muzaffernizam/STM32-Motor-Control-BLDC-24V/Orders/STM32_Motor_Kit_v0.1_L.xlsx

Sheet: STM32_Motor_Kit_v0.1
Reference | Value | Footprint | LCSC PART | LCSC PRICE 100 ADETTE |  | Price 10 adet | Adet | Toplam
R86,R130 | 0R | AKE_Resistor_SMD:RES_0603 | AC0603FR-070RL | 0.002 | 100 ADETTE | $0.0100 | 20 | $0.20 | 0.04
D3,D41 | 3.3V | AKE_Diode_SMD:SOD-123 | BZT52C3V3-7-F | 0.0224 | 20 ADETTE | $0.0460 | 20 | $0.92 | 0.448
R33,R34,R35,R36,R37,R38,R41,R42,R43,R44,R45,R46 | 10R | AKE_Resistor_SMD:RES_0603 | RC0603FR-0710RL | 0.0032 | 100 | $0.0100 | 120 | $1.20 | 0.384
D2,D29,D30,D31 | 26V | AKE_Diode_SMD:SMC |  |  |  | $0.0100 | 40 | $0.40 | 0
R18,R19,R47,R48,R62,R63,R72,R73,R83,R84,R87,R89,R131,R132 | 47R | AKE_Resistor_SMD:RES_0603 | RC0603FR-0747RL | 0.0012 |  | $0.0100 | 140 | $1.40 | 0.168
R29,R31 | 60R | AKE_Resistor_SMD:RES_0603 | RC0603FR-0760R4L | 0.0012 |  | $0.0100 | 20 | $0.20 | 0.024
R7,R10,R28,R119 | 100R | AKE_Resistor_SMD:RES_0603 | AC0603FR-07100RL | 0.0021 |  | $0.0100 | 40 | $0.40 | 0.084
R17,R81,R82,R120,R121,R122,R123,R124,R125,R126,R127,R128 | 330R | AKE_Resistor_SMD:RES_0603 | RC0603FR-07330RL | 0.0012 |  | $0.0100 | 120 | $1.20 | 0.144
R16 | 500R | AKE_Resistor_SMD:RES_0603 | RC0603FR-07499RL | 0.0013 |  | $0.0100 | 10 | $0.10 | 0.013
R1,R4,R5,R50,R51,R52,R53,R54,R55,R69,R70,R71,R75,R76,R77,R118 | 1K | AKE_Resistor_SMD:RES_0603 | RC0603FR-071KL | 0.001 |  | $0.0100 | 160 | $1.60 | 0.16
R15,R56,R57,R58,R59,R60,R61 | 1.5K | AKE_Resistor_SMD:RES_0603 | RC0603FR-071K5L | 0.0012 |  | $0.0100 | 70 | $0.70 | 0.084
R14 | 2.4K | AKE_Resistor_SMD:RES_0603 |  |  |  | $0.0100 | 10 | $0.10 | 0
R13 | 3.3K | AKE_Resistor_SMD:RES_0603 |  |  |  | $0.0100 | 10 | $0.10 | 0
R88,R90,R91,R92 | 4.7K | AKE_Resistor_SMD:RES_0603 |  |  |  | $0.0100 | 40 | $0.40 | 0
R2,R12 | 10K | AKE_Resistor_SMD:RES_0603 |  |  |  | $0.0100 | 20 | $0.20 | 0
R3,R6 | 10K | AKE_Resistor_SMD:RES_1206 |  |  |  | $0.0100 | 20 | $0.20 | 0
R11 | 29.4K | AKE_Resistor_SMD:RES_0603 |  |  |  | $0.0100 | 10 | $0.10 | 0
R66,R67,R68,R78,R79,R80 | 47K | AKE_Resistor_SMD:RES_0603 |  |  |  | $0.0100 | 60 | $0.60 | 0
R9 | 68K | AKE_Resistor_SMD:RES_0603 |  |  |  | $0.0100 | 10 | $0.10 | 0
R8 | 330K | AKE_Resistor_SMD:RES_0603 |  |  |  | $0.0100 | 10 | $0.10 | 0
C58,C59 | 1000uF_35V | AKE_Capacitor_TH:C_Radial_D16.0mm_H31.5mm_P7.50mm |  |  |  | $0.0374 | 20 | $0.75 | 0
C1,C2,C3,C4,C5,C6,C7,C8,C11,C13,C15,C16,C18,C20,C22,C23,C24,C25,C30,C34,C42,C49,C50,C51,C75,C76,C77,C81,C82,C83,C86,C87,C103,C104 | 100nF_50V | AKE_Capacitor_SMD:CAP_0603 |  |  |  | $0.0100 | 340 | $3.40 | 0
C52,C54,C56 | 100nF_50V | AKE_Capacitor_SMD:CAP_1206 |  |  |  | $0.0100 | 30 | $0.30 | 0
C36,C37,C40,C41,C66,C67,C68,C69,C70,C71 | 100pF_50V | AKE_Capacitor_SMD:CAP_0603 |  |  |  | $0.0100 | 100 | $1.00 | 0
C26 | 10nF_50V | AKE_Capacitor_SMD:CAP_0603 |  |  |  | $0.0100 | 10 | $0.10 | 0
C12,C17 | 10uF_10V | AKE_Capacitor_SMD:CAP_1206_TANTAL |  |  |  | $0.1260 | 20 | $2.52 | 0
C90 | 10uF_10V | AKE_Capacitor_SMD:CAP_1206 |  |  |  | $0.1260 | 10 | $1.26 | 0
C43,C44,C45 | 10uF_50V | AKE_Capacitor_SMD:CAP_1206_TANTAL |  |  |  | $0.0100 | 30 | $0.30 | 0
C9,C10 | 18pF_50V | AKE_Capacitor_SMD:CAP_0603 |  |  |  | $0.0100 | 20 | $0.20 | 0
D17,D18,D21,D22,D25,D26 | 1N4148 | AKE_Diode_SMD:SOD-323 |  |  |  | $0.0278 | 60 | $1.67 | 0
C29,C84,C85,C88,C89 | 1nF_50V | AKE_Capacitor_SMD:CAP_0603 |  |  |  | $0.0100 | 50 | $0.50 | 0
C72,C73,C74,C78,C79,C80 | 1uF_10V | AKE_Capacitor_SMD:CAP_0603 |  |  |  | $0.0100 | 60 | $0.60 | 0
C27,C28,C46,C47,C48 | 1uF_50V | AKE_Capacitor_SMD:CAP_1206 |  |  |  | $0.0100 | 50 | $0.50 | 0
C33 | 1uF_50V | AKE_Capacitor_SMD:CAP_0603 |  |  |  | $0.0100 | 10 | $0.10 | 0
C60,C61,C62,C63,C64,C65 | 2.2uF_10V | AKE_Capacitor_SMD:CAP_0603 |  |  |  | $0.0126 | 60 | $0.76 | 0
C19 | 220uF_50V | AKE_Capacitor_TH:CP_Radial_D10.0mm_P5.00mm |  |  |  | $0.1116 | 10 | $1.12 | 0
C14,C21,C35 | 22pF_50V | AKE_Capacitor_SMD:CAP_0603 |  |  |  | $0.0100 | 30 | $0.30 | 0
C53,C55,C57 | 22uF_35V | AKE_Capacitor_SMD:CAP_2917_7343_TANTAL_7.3x4.3mm |  |  |  | $0.1000 | 30 | $3.00 | 0
C91 | 3.3nF_50V | AKE_Capacitor_SMD:CAP_0603 |  |  |  | $0.0100 | 10 | $0.10 | 0
C32 | 330uF_25V | AKE_Capacitor_TH:CP_Radial_D10.0mm_P5.00mm |  |  |  | $0.0508 | 10 | $0.51 | 0
C31 | 47pF_50V | AKE_Capacitor_SMD:CAP_0603 |  |  |  | $0.0100 | 10 | $0.10 | 0
L1,L2 | 6.8uH_5.6A | AKE_Inductor_SMD:SRI1004-6R8M |  |  |  | $0.3068 | 20 | $6.14 | 0
TH1 | 8V_0.5A | AKE_Resistor_SMD:RES_1206 |  |  |  | $0.1087 | 10 | $1.09 | 0
D9 | B0520LW-7-F | AKE_Diode_SMD:SOD-123 |  |  |  | $0.0100 | 10 | $0.10 | 0
D4 | B340A-E3/61T | AKE_Diode_SMD:SMA |  |  |  | $0.2574 | 10 | $2.57 | 0
D5,D6,D7,D8,D32,D33,D42,D43,D44,D45,D46,D47,D48,D49 | Blue | AKE_Led_SMD:LED_0805 |  |  |  | $0.0500 | 140 | $7.00 | 0
J1,J4 | Conn_01x02_Male | AKE_Connector_Socket_TH:PhoenixContact_MC_1,5_2-G-3.81_1x02_P3.81mm_Horizontal |  |  |  | $0.1000 | 20 | $2.00 | 0
J5 | Conn_01x03_Male | AKE_Connector_Socket_TH:PhoenixContact_MC_1,5_3-G-3.81_1x03_P3.81mm_Horizontal |  |  |  | $0.1000 | 10 | $1.00 | 0
J6 | Conn_01x05_Male | AKE_Connector_Socket_TH:PhoenixContact_MC_1,5_5-G-3.81_1x05_P3.81mm_Horizontal |  |  |  | $0.1000 | 10 | $1.00 | 0
J2 | Conn_02x05_Odd_Even | AKE_Connector_IDC_Socket:IDC-Header_2x05_P2.54mm_Vertical |  |  |  | $0.0100 | 10 | $0.10 | 0
J10 | Conn_02x20_Odd_Even | AKE_Pinheader_TH:PinHeader_2x20_P2.54mm_Vertical |  |  |  | $0.2500 | 10 | $2.50 | 0
Y1 | CRYSTAL_8mHz | AKE_Oscilator_SMD:CRY_SMD_4P_5.0x3.2mm |  |  |  | $0.2000 | 10 | $2.00 | 0
D34 | DESD5V0U1BA-7 | AKE_Diode_SMD:SOD-323 |  |  |  | $0.0100 | 10 | $0.10 | 0
R85 | DNI/0R | AKE_Resistor_SMD:RES_0603 |  |  |  | $0.0100 | 10 | $0.10 | 0
R129 | DNI/0R | AKE_Resistor_SMD:RES_0603 |  |  |  | $0.0100 | 10 | $0.10 | 0
R39,R40 | DNI/499K | AKE_Resistor_SMD:RES_1206 |  |  |  | $0.0100 | 20 | $0.20 | 0
R30 | DNI/RX1 | AKE_Resistor_SMD:RES_0603 |  |  |  | $0.0100 | 10 | $0.10 | 0
R32 | DNI/RX2 | AKE_Resistor_SMD:RES_0603 |  |  |  | $0.0100 | 10 | $0.10 | 0
D14,D15,D16 | ES1D-M3/61T | AKE_Diode_SMD:SMA |  |  |  | $0.0877 | 30 | $2.63 | 0
F1 | Glass_Fuse | AKE_Device_TH:FuseHolder_5X20_TK79_Plastic |  |  |  | $0.1077 | 10 | $1.08 | 0
U9,U10,U11 | IR2101STRPBF | AKE_IC_SMD:SOIC-8_3.9x4.9mm_P1.27mm |  |  |  | $1.2804 | 30 | $38.41 | 0
U2 | LDF33DT-TR | AKE_Regulator_SMD:DPAK_123 |  |  |  | $0.2500 | 10 | $2.50 | 0
U3,U12,U13,U14 | LMV358IDRG4 | AKE_Opamp_SMD:SOIC-8_3.9x4.9mm_P1.27mm |  |  |  | $0.5184 | 40 | $20.74 | 0
U15 | LSF0204DPWR | AKE_IC_SMD:TSSOP-14_4.4x5mm_P0.65mm |  |  |  | $0.8130 | 10 | $8.13 | 0
U20 | M24C64-WMN6TP | AKE_IC_SMD:SOIC-8_3.9x4.9mm_P1.27mm |  |  |  | $0.1952 | 10 | $1.95 | 0
U5 | MC78M15CDTRKG | AKE_Regulator_SMD:DPAK_123 |  |  |  | $0.7028 | 10 | $7.03 | 0
Q9 | MMUN2235LT1G | AKE_Transistor_SMD:SOT-23 |  |  |  | $0.0501 | 10 | $0.50 | 0
Q1,Q2,Q3,Q4,Q5,Q6 | NTMFS4119NT1G | AKE_Mosfet_SMD:LFPAK56 |  |  |  | $0.1149 | 60 | $6.90 | 0
D13 | PESD2CANFD27V-TR | AKE_Diode_SMD:SOT-23 |  |  |  | $0.2000 | 10 | $2.00 | 0
SW2 | Push_Button_SMD_4P | AKE_Button_SMD_TH:SW_PTS645SK50SMTR92 |  |  |  | $0.1207 | 10 | $1.21 | 0
D1 | RED | AKE_Led_SMD:LED_0805 |  |  |  | $0.1000 | 10 | $1.00 | 0
R49,R64,R65,R74 | Rshont | AKE_Resistor_SMD:RES_2512 |  |  |  | $0.2500 | 40 | $10.00 | 0
D19,D20,D23,D24,D27,D28 | S3M-TP | AKE_Diode_SMD:SMC |  |  |  | $0.1178 | 60 | $7.07 | 0
U19 | SN74HC595DRG3 | AKE_IC_SMD:SOIC-16_3.9x9.9mm_P1.27mm |  |  |  | $0.3120 | 10 | $3.12 | 0
U1 | STM32G441VBT6 | AKE_MCU_SMD:LQFP-100_14x14mm_P0.5mm |  |  |  | $4.5000 | 10 | $45.00 | STM32G473VET6
SW1 | SW_DIP_x01 | Button_Switch_THT:SW_DIP_SPSTx01_Slide_6.7x4.1mm_W7.62mm_P2.54mm_LowProfile |  |  |  | $0.6088 | 10 | $6.09
U8 | TJA1441BT_0Z | AKE_IC_SMD:SOIC-8_3.9x4.9mm_P1.27mm |  |  |  | $1.3560 | 10 | $13.56
U4 | TPS54331DR | AKE_Regulator_SMD:SOIC-8_3.9x4.9mm_P1.27mm_EP |  |  |  | $0.4470 | 10 | $4.47
RV1 | WH148-1A-2-20V-B1K | AKE_Resistor_TH:Potentiometer_Side_TH_5mmPitch |  |  |  | $0.1712 | 10 | $1.71
 |  |  |  |  |  |  | TOPLAM | $240.59
 |  |  |  |  |  |  | BİRİM MALİYET | $24.06

Sheet: Sayfa1
Reference | Value | Footprint | Qty | DNP | MFG P/N | Price 10 adet | Adet | Toplam
R86,R130 | 0R | AKE_Resistor_SMD:RES_0603 | 2 |  | * | $0.0100 | 20 | $0.20
D3,D41 | 3.3V | AKE_Diode_SMD:SOD-123 | 2 |  | BZT52-B3V3_R1_00001 | $0.0460 | 20 | $0.92
R26,R27,R33,R34,R35,R36,R37,R38,R41,R42,R43,R44,R45,R46 | 10R | AKE_Resistor_SMD:RES_0603 | 14 |  | * | $0.0100 | 140 | $1.40
D2,D29,D30,D31 | 26V | AKE_Diode_SMD:SMC | 4 |  | * | $0.0100 | 40 | $0.40
R18,R19,R47,R48,R62,R63,R72,R73,R83,R84,R87,R89,R131,R132 | 47R | AKE_Resistor_SMD:RES_0603 | 14 |  | * | $0.0100 | 140 | $1.40
R29,R31 | 60R | AKE_Resistor_SMD:RES_0603 | 2 |  | * | $0.0100 | 20 | $0.20
R7,R10,R28,R111,R119 | 100R | AKE_Resistor_SMD:RES_0603 | 5 |  | * | $0.0100 | 50 | $0.50
R25 | 120R | AKE_Resistor_SMD:RES_0603 | 1 |  | * | $0.0100 | 10 | $0.10
R17,R81,R82,R116,R117,R120,R121,R122,R123,R124,R125,R126,R127,R128 | 330R | AKE_Resistor_SMD:RES_0603 | 14 |  | * | $0.0100 | 140 | $1.40
R16 | 500R | AKE_Resistor_SMD:RES_0603 | 1 |  | * | $0.0100 | 10 | $0.10
R95,R96 | 560R | AKE_Resistor_SMD:RES_0603 | 2 |  | * | $0.0100 | 20 | $0.20
R1,R4,R5,R20,R50,R51,R52,R53,R54,R55,R69,R70,R71,R75,R76,R77,R101,R102,R118 | 1K | AKE_Resistor_SMD:RES_0603 | 19 |  | * | $0.0100 | 190 | $1.90
R15,R21,R22,R23,R56,R57,R58,R59,R60,R61 | 1.5K | AKE_Resistor_SMD:RES_0603 | 10 |  | * | $0.0100 | 100 | $1.00
R14 | 2.4K | AKE_Resistor_SMD:RES_0603 | 1 |  | * | $0.0100 | 10 | $0.10
R13,R99,R100 | 3.3K | AKE_Resistor_SMD:RES_0603 | 3 |  | * | $0.0100 | 30 | $0.30
R24,R88,R90,R91,R92,R93,R94,R97,R98 | 4.7K | AKE_Resistor_SMD:RES_0603 | 9 |  | * | $0.0100 | 90 | $0.90
R103 | 4.7K | AKE_Resistor_SMD:RES_1206 | 1 |  | * | $0.0100 | 10 | $0.10
R2,R12,R105,R107,R112,R113,R114,R115 | 10K | AKE_Resistor_SMD:RES_0603 | 8 |  | * | $0.0100 | 80 | $0.80
R3,R6 | 10K | AKE_Resistor_SMD:RES_1206 | 2 |  | * | $0.0100 | 20 | $0.20
R11 | 29.4K | AKE_Resistor_SMD:RES_0603 | 1 |  | * | $0.0100 | 10 | $0.10
R66,R67,R68,R78,R79,R80 | 47K | AKE_Resistor_SMD:RES_0603 | 6 |  | * | $0.0100 | 60 | $0.60
R9 | 68K | AKE_Resistor_SMD:RES_0603 | 1 |  | * | $0.0100 | 10 | $0.10
R108,R109 | 100K | AKE_Resistor_SMD:RES_0603 | 2 |  | * | $0.0100 | 20 | $0.20
R8 | 330K | AKE_Resistor_SMD:RES_0603 | 1 |  | * | $0.0100 | 10 | $0.10
R106 | 510K | AKE_Resistor_SMD:RES_0603 | 1 |  | * | $0.0100 | 10 | $0.10
R110 | 1M | AKE_Resistor_SMD:RES_0603 | 1 |  | * | $0.0100 | 10 | $0.10
C58,C59 | 1000uF_35V | AKE_Capacitor_TH:C_Radial_D16.0mm_H31.5mm_P7.50mm | 2 |  | 108CKE063M | $1.5107 | 20 | $30.21
C1,C2,C3,C4,C5,C6,C7,C8,C11,C13,C15,C16,C18,C20,C22,C23,C24,C25,C30,C34,C38,C39,C42,C49,C50,C51,C75,C76,C77,C81,C82,C83,C86,C87,C98,C102,C103,C104 | 100nF_50V | AKE_Capacitor_SMD:CAP_0603 | 38 |  | * | $0.0100 | 380 | $3.80
C52,C54,C56 | 100nF_50V | AKE_Capacitor_SMD:CAP_1206 | 3 |  | * | $0.0100 | 30 | $0.30
C36,C37,C40,C41,C66,C67,C68,C69,C70,C71 | 100pF_50V | AKE_Capacitor_SMD:CAP_0603 | 10 |  | * | $0.0100 | 100 | $1.00
C26,C96 | 10nF_50V | AKE_Capacitor_SMD:CAP_0603 | 2 |  | * | $0.0100 | 20 | $0.20
C12,C17 | 10uF_10V | AKE_Capacitor_SMD:CAP_1206_TANTAL | 2 |  | TAJA106K010RNJ | $0.1260 | 20 | $2.52
C90 | 10uF_10V | AKE_Capacitor_SMD:CAP_1206 | 1 |  | TAJA106K010RNJ | $0.1260 | 10 | $1.26
C43,C44,C45 | 10uF_50V | AKE_Capacitor_SMD:CAP_1206_TANTAL | 3 |  | * | $0.0100 | 30 | $0.30
C9,C10 | 18pF_50V | AKE_Capacitor_SMD:CAP_0603 | 2 |  | * | $0.0100 | 20 | $0.20
D17,D18,D21,D22,D25,D26,D37,D38 | 1N4148 | AKE_Diode_SMD:SOD-323 | 8 |  | 1N4148WS_R1_00001 | $0.0278 | 80 | $2.23
C29,C84,C85,C88,C89,C94 | 1nF_50V | AKE_Capacitor_SMD:CAP_0603 | 6 |  | * | $0.0100 | 60 | $0.60
C72,C73,C74,C78,C79,C80 | 1uF_10V | AKE_Capacitor_SMD:CAP_0603 | 6 |  | * | $0.0100 | 60 | $0.60
C27,C28,C46,C47,C48 | 1uF_50V | AKE_Capacitor_SMD:CAP_1206 | 5 |  | * | $0.0100 | 50 | $0.50
C33 | 1uF_50V | AKE_Capacitor_SMD:CAP_0603 | 1 |  | * | $0.0100 | 10 | $0.10
C60,C61,C62,C63,C64,C65 | 2.2uF_10V | AKE_Capacitor_SMD:CAP_0603 | 6 |  | CL10A225KP8NNNC | $0.0126 | 60 | $0.76
C95 | 2.2uF_10V | AKE_Capacitor_SMD:CAP_1206 | 1 |  | * | $0.0100 | 10 | $0.10
C19 | 220uF_50V | AKE_Capacitor_TH:CP_Radial_D10.0mm_P5.00mm | 1 |  | PKLH-050V221MG160-T/A5.0 | $0.1116 | 10 | $1.12
C92,C93 | 22pF_10V | AKE_Capacitor_SMD:CAP_0603 | 2 |  | * | $0.0100 | 20 | $0.20
C14,C21,C35 | 22pF_50V | AKE_Capacitor_SMD:CAP_0603 | 3 |  | * | $0.0100 | 30 | $0.30
C99 | 22uF_10V | AKE_Capacitor_SMD:CAP_1206 | 1 |  | * | $0.0100 | 10 | $0.10
C53,C55,C57 | 22uF_35V | AKE_Capacitor_SMD:CAP_2917_7343_TANTAL_7.3x4.3mm | 3 |  | T495D226K035ATE300 | $1.2057 | 30 | $36.17 | footprint Kontrol edilecek var olan komponent eklendi
Q7,Q8 | 2N7002 | AKE_Mosfet_SMD:SOT-23 | 2 |  | 2N7002_R1_00001 | $0.0266 | 20 | $0.53
C91 | 3.3nF_50V | AKE_Capacitor_SMD:CAP_0603 | 1 |  | * | $0.0100 | 10 | $0.10
C32 | 330uF_25V | AKE_Capacitor_TH:CP_Radial_D10.0mm_P5.00mm | 1 |  | PKRM-025V331MF115-T/A5.0 | $0.0508 | 10 | $0.51
C100 | 4.7uF_10V | AKE_Capacitor_SMD:CAP_1206 | 1 |  | * | $0.0100 | 10 | $0.10
C97 | 470pF_50V | AKE_Capacitor_SMD:CAP_0603 | 1 |  | * | $0.0100 | 10 | $0.10
C31 | 47pF_50V | AKE_Capacitor_SMD:CAP_0603 | 1 |  | * | $0.0100 | 10 | $0.10
L1,L2 | 6.8uH_5.6A | AKE_Inductor_SMD:SRI1004-6R8M | 2 |  | SRI1004-6R8M | $0.3068 | 20 | $6.14
U6 | 74HC14D,653 | AKE_IC_SMD:SOIC-14_3.9x8.7mm_P1.27mm | 1 |  | 74HC14D,653 | $0.3007 | 10 | $3.01
TH1 | 8V_0.5A | AKE_Resistor_SMD:RES_1206 | 1 |  | 0ZCJ0050FF2G | $1.0794 | 10 | $10.79 | STOK YOK MUADİL BAK
RL1,RL2 | ALDP105W | AKE_Relay_TH:Relay_1P1T_NO_7x20x14.9mm_Panasonic_ALDP | 2 |  | ALDP124W | $0.5227 | 20 | $10.45 | ŞEMADA 24 VOLT ŞEKLİNDE DÜZELT
D9 | B0520LW-7-F | AKE_Diode_SMD:SOD-123 | 1 |  | B0520LW-7-F | $0.0100 | 10 | $0.10 | MUADİL BAKILACAK
D4 | B340A-E3/61T | AKE_Diode_SMD:SMA | 1 |  | B340A-E3/61T | $0.2574 | 10 | $2.57
D5,D6,D7,D8,D32,D33,D39,D40,D42,D43,D44,D45,D46,D47,D48,D49 | Blue | AKE_Led_SMD:LED_0805 | 16 |  | * | $0.0100 | 160 | $1.60
J1,J3,J4 | Conn_01x02_Male | AKE_Connector_Socket_TH:PhoenixContact_MC_1,5_2-G-3.81_1x02_P3.81mm_Horizontal | 3 |  |  | $0.6000 | 30 | $18.00
J8 | Conn_01x03 | AKE_Pinheader_TH:PinHeader_1x03_P2.54mm_Vertical | 1 |  |  | $0.0100 | 10 | $0.10
J5,J7,J9 | Conn_01x03_Male | AKE_Connector_Socket_TH:PhoenixContact_MC_1,5_3-G-3.81_1x03_P3.81mm_Horizontal | 3 |  |  | $0.6000 | 30 | $18.00
J6 | Conn_01x05_Male | AKE_Connector_Socket_TH:PhoenixContact_MC_1,5_5-G-3.81_1x05_P3.81mm_Horizontal | 1 |  |  | $0.6000 | 10 | $6.00
J2 | Conn_02x05_Odd_Even | AKE_Connector_IDC_Socket:IDC-Header_2x05_P2.54mm_Vertical | 1 |  |  | $0.0100 | 10 | $0.10
J10 | Conn_02x20_Odd_Even | AKE_Pinheader_TH:PinHeader_2x20_P2.54mm_Vertical | 1 |  |  | $0.0100 | 10 | $0.10
Y1 | CRYSTAL_8mHz | AKE_Oscilator_SMD:CRY_SMD_4P_5.0x3.2mm | 1 |  | OZDISAN | $0.2000 | 10 | $2.00 | KOMPONENT BUL
D34 | DESD5V0U1BA-7 | AKE_Diode_SMD:SOD-323 | 1 |  | * | $0.0555 | 10 | $0.56 | STOK YOK MUADİL BAK
R104 | DNI | AKE_PCB:RES_0603 | 1 | DNP | * | $0.0100 | 10 | $0.10
R85 | DNI/0R | AKE_Resistor_SMD:RES_0603 | 1 |  | * | $0.0100 | 10 | $0.10
R129 | DNI/0R | AKE_Resistor_SMD:RES_0603 | 1 | DNP | * | $0.0100 | 10 | $0.10
R39,R40 | DNI/499K | AKE_Resistor_SMD:RES_1206 | 2 |  | * | $0.0100 | 20 | $0.20
C101 | DNI/3nF_50V | AKE_Capacitor_SMD:CAP_0603 | 1 | DNP | * | $0.0100 | 10 | $0.10
R30 | DNI/RX1 | AKE_Resistor_SMD:RES_0603 | 1 |  | * | $0.0100 | 10 | $0.10
R32 | DNI/RX2 | AKE_Resistor_SMD:RES_0603 | 1 |  | * | $0.0100 | 10 | $0.10
D14,D15,D16 | ES1D-M3/61T | AKE_Diode_SMD:SMA | 3 |  | ES1D-E3/61T | $0.0877 | 30 | $2.63 | MUADİL BAKTIM KONTROL ET
F1 | Glass_Fuse | AKE_Device_TH:FuseHolder_5X20_TK79_Plastic | 1 |  | 202.707001.06-299 | $0.1077 | 10 | $1.08
D35,D36 | GREEN | AKE_Led_SMD:LED_0805 | 2 |  | * | $0.0100 | 20 | $0.20
U9,U10,U11 | IR2101STRPBF | AKE_IC_SMD:SOIC-8_3.9x4.9mm_P1.27mm | 3 |  | IR2101STRPBF | $1.2804 | 30 | $38.41
U2 | LDF33DT-TR | AKE_Regulator_SMD:DPAK_123 | 1 |  | LDF33DT-TR | $0.2500 | 10 | $2.50 | MUADİL BAK
U3,U12,U13,U14,U18 | LMV358IDRG4 | AKE_Opamp_SMD:SOIC-8_3.9x4.9mm_P1.27mm | 5 |  | LMV358M/NOPB | $0.5184 | 50 | $25.92 | MUADİL BULDUM KONTROL ET
U15 | LSF0204DPWR | AKE_IC_SMD:TSSOP-14_4.4x5mm_P0.65mm | 1 |  | LSF0204DPWR | $0.8130 | 10 | $8.13 | ÖZDİSANDAN MUADİL BAK ŞUANKİ DİGİKEY FİYATI
U20 | M24C64-WMN6TP | AKE_IC_SMD:SOIC-8_3.9x4.9mm_P1.27mm | 1 |  | M24C64-WMN6TP | $0.1952 | 10 | $1.95
U5 | MC78M15CDTRKG | AKE_Regulator_SMD:DPAK_123 | 1 |  | L7815CD2T-TR | $0.7028 | 10 | $7.03
Q9 | MMUN2235LT1G | AKE_Transistor_SMD:SOT-23 | 1 |  | MMUN2235LT1G | $0.0501 | 10 | $0.50 | STOK YOK MUADİL BAK
Q1,Q2,Q3,Q4,Q5,Q6 | NTMFS4119NT1G | AKE_Mosfet_SMD:LFPAK56 | 6 |  | NTMFS4119NT1G | $0.1149 | 60 | $6.90
D13 | PESD2CANFD27V-TR | AKE_Diode_SMD:SOT-23 | 1 |  | PESD2CANFD27V-TR | $0.2000 | 10 | $2.00
SW2 | Push_Button_SMD_4P | AKE_Button_SMD_TH:SW_PTS645SK50SMTR92 | 1 |  | PTS645SK50SMTR92 LFS | $0.1207 | 10 | $1.21
D1,D10,D11,D12 | RED | AKE_Led_SMD:LED_0805 | 4 |  | * | $0.0100 | 40 | $0.40
R49,R64,R65,R74 | Rshont | AKE_Resistor_SMD:RES_2512 | 4 |  | * | $0.2500 | 40 | $10.00
D19,D20,D23,D24,D27,D28 | S3M-TP | AKE_Diode_SMD:SMC | 6 |  | S3M_R2_00001 | $0.1178 | 60 | $7.07
U19 | SN74HC595DRG3 | AKE_IC_SMD:SOIC-16_3.9x9.9mm_P1.27mm | 1 |  | SN74HC595PWR | $0.3120 | 10 | $3.12 | FOOTPRİNT DEĞİŞECEK YENİ KOD EKLEDİM
U1 | STM32G441VBT6 | AKE_MCU_SMD:LQFP-100_14x14mm_P0.5mm | 1 |  | STM32G441VBT6 | $6.8090 | 10 | $68.09
SW1 | SW_DIP_x01 | Button_Switch_THT:SW_DIP_SPSTx01_Slide_6.7x4.1mm_W7.62mm_P2.54mm_LowProfile | 1 |  | NDS-01V | $0.6088 | 10 | $6.09
U7 | THVD1500D | AKE_IC_SMD:SOIC-8_3.9x4.9mm_P1.27mm | 1 |  | THVD1500DR | $0.3575 | 10 | $3.58 | YENİ KOD EKLEDİM KONTROL ET
U8 | TJA1441BT_0Z | AKE_IC_SMD:SOIC-8_3.9x4.9mm_P1.27mm | 1 |  | TJA1441BT/0Z | $1.3560 | 10 | $13.56 | ÖZDİSANDAN MUADİL BAK DİGİKEY FİYATI
U16,U17 | TLP290(GR-TP,SE | AKE_Opto_SMD:SO-4_4.4x2.3mm_P1.27mm | 2 |  | TLP290(GR-TP,SE(T | $0.2785 | 20 | $5.57 | YENİ KOD EKLEDİM KONTROL ET
U4 | TPS54331DR | AKE_Regulator_SMD:SOIC-8_3.9x4.9mm_P1.27mm_EP | 1 |  | TPS54331DR | $0.4470 | 10 | $4.47
RV1 | WH148-1A-2-20V-B1K | AKE_Resistor_TH:Potentiometer_Side_TH_5mmPitch | 1 |  | WH148-1A-2-20V-B1K | $0.1712 | 10 | $1.71
 |  |  |  |  |  |  | ALT TOPLAM | $399.86
 |  |  |  |  |  |  | BİRİM MALİYET | $39.99
