muzaffernizam/STM32-Motor-Control-BLDC-24V/Documents/Schematic/STM32_Motor_Kit_v0.1-Motor_Control.pdf

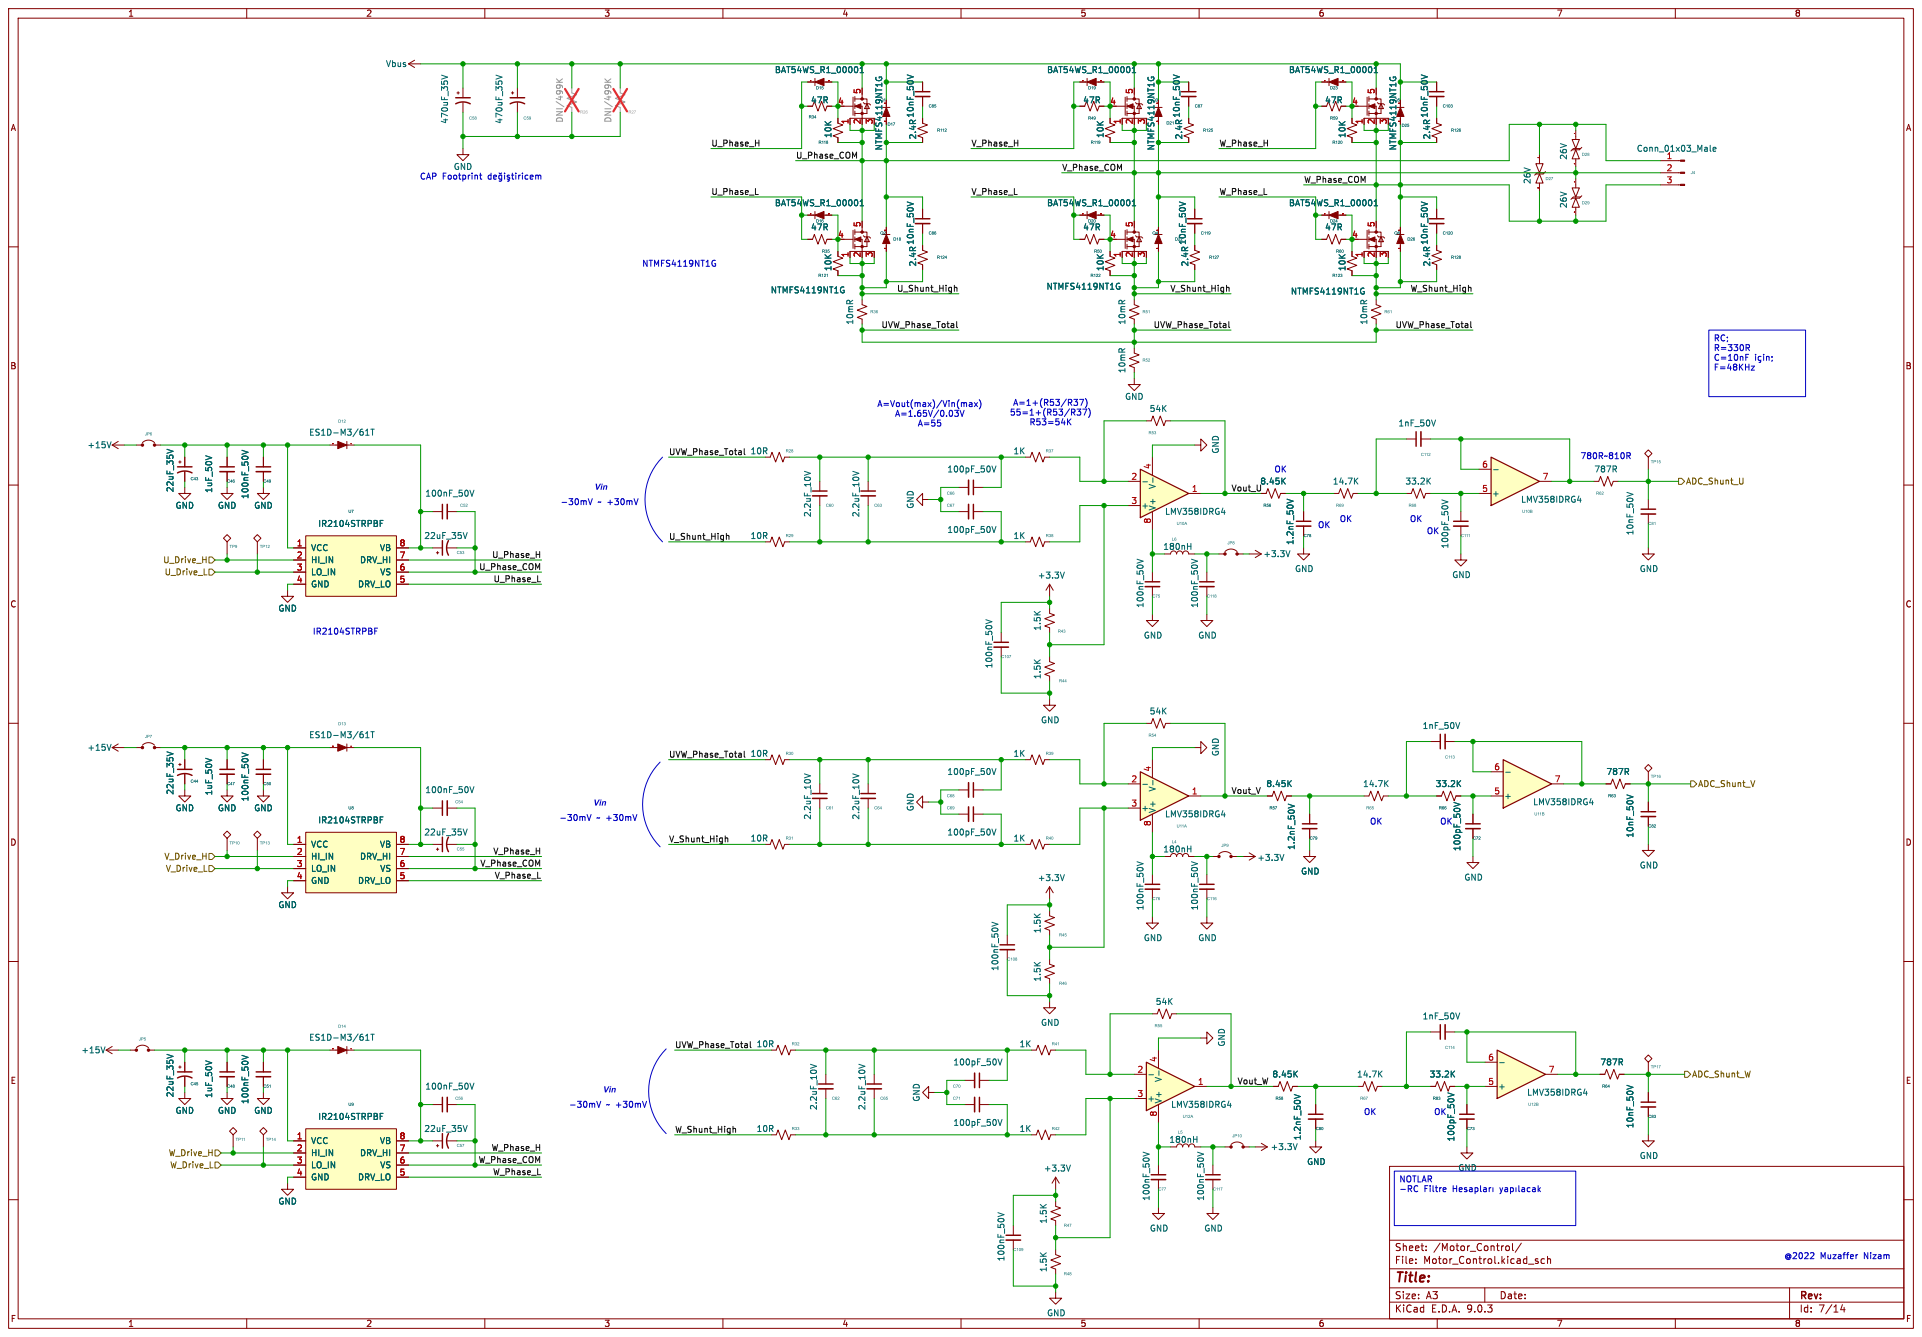
[picture p1: page 1]

A=Vout(max)/Vin(max) A=1.65V/0.03V
