muzaffernizam/STM32-Motor-Control-BLDC-24V/Documents/Schematic/STM32_Motor_Kit_v0.1.pdf

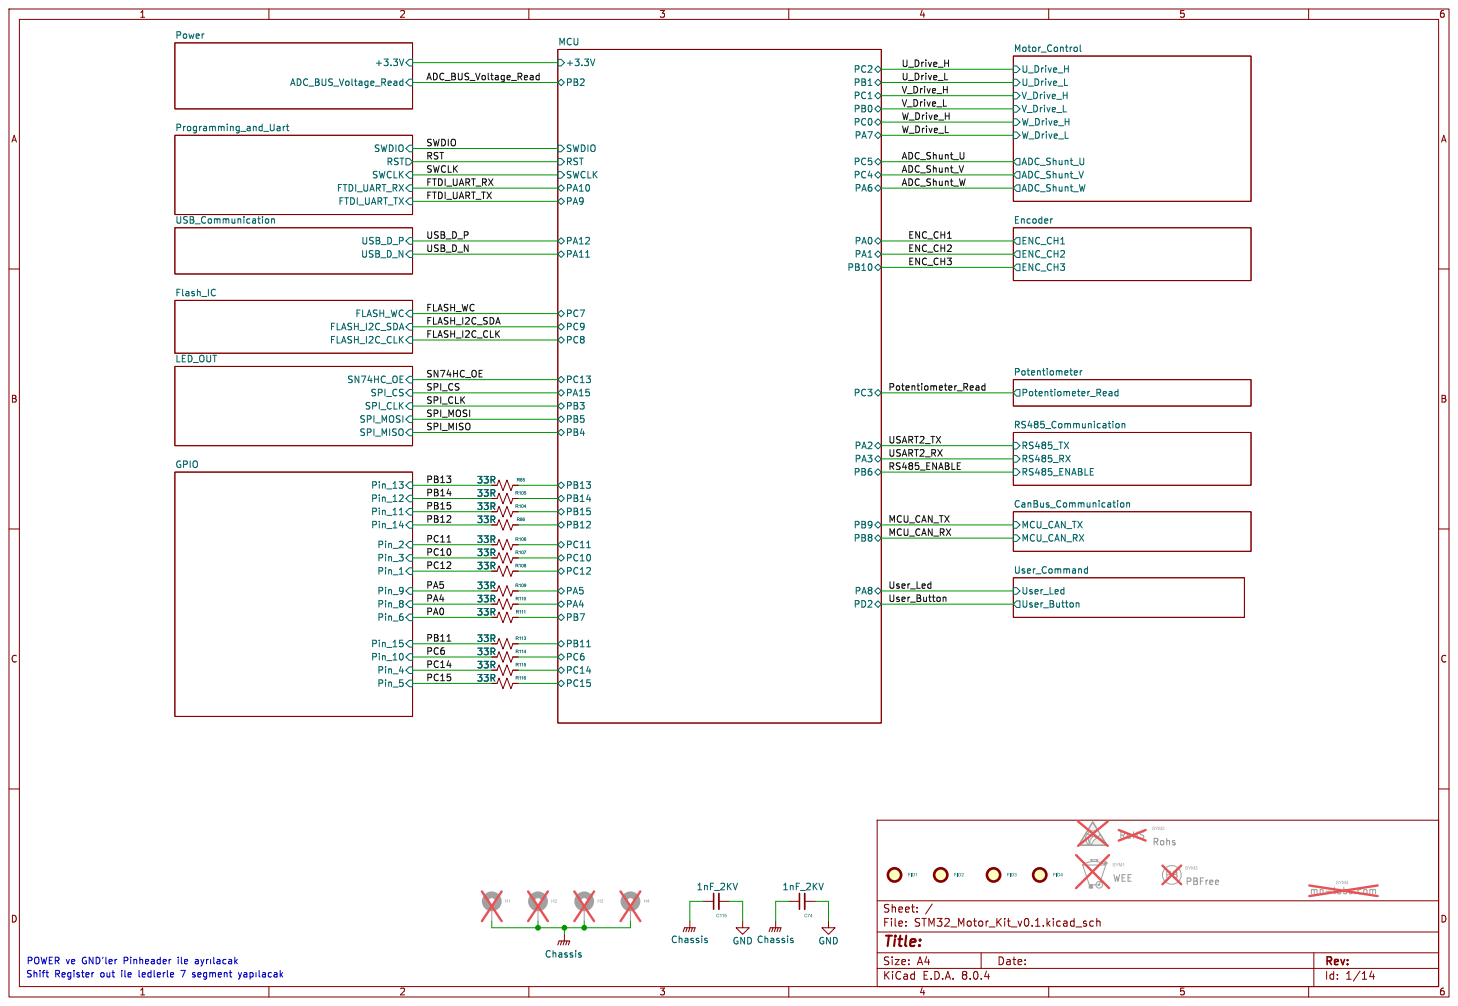
[picture p2: page 1]

Id: 1/14 Title: File: STM32_Motor_Kit_v0.1.kicad_sch Sheet: /

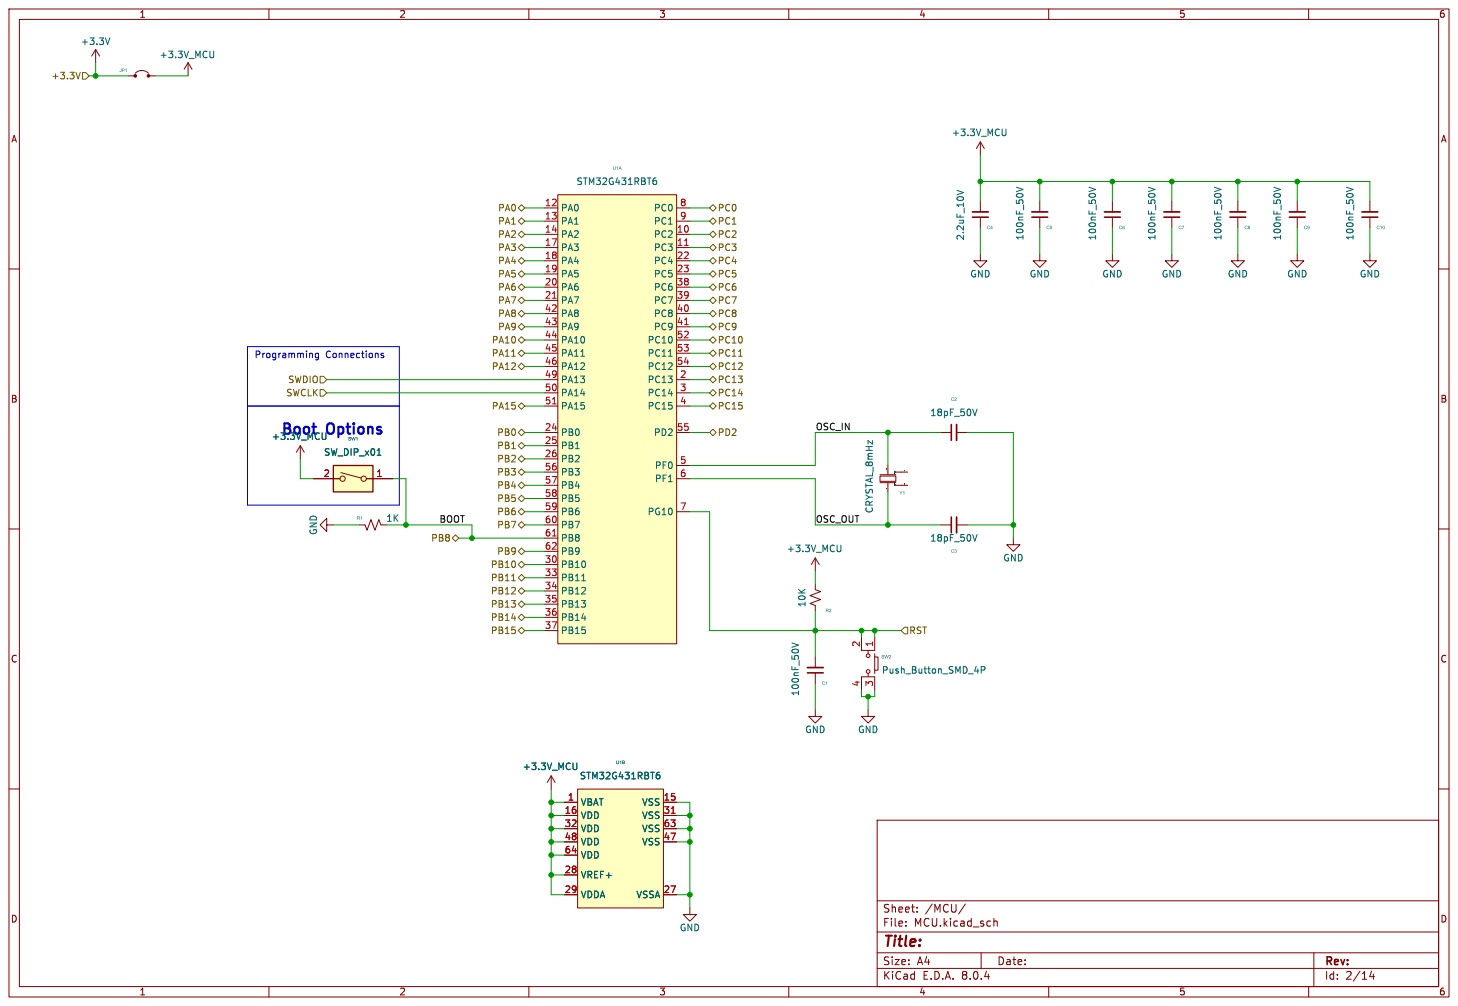
[picture p3: page 2]

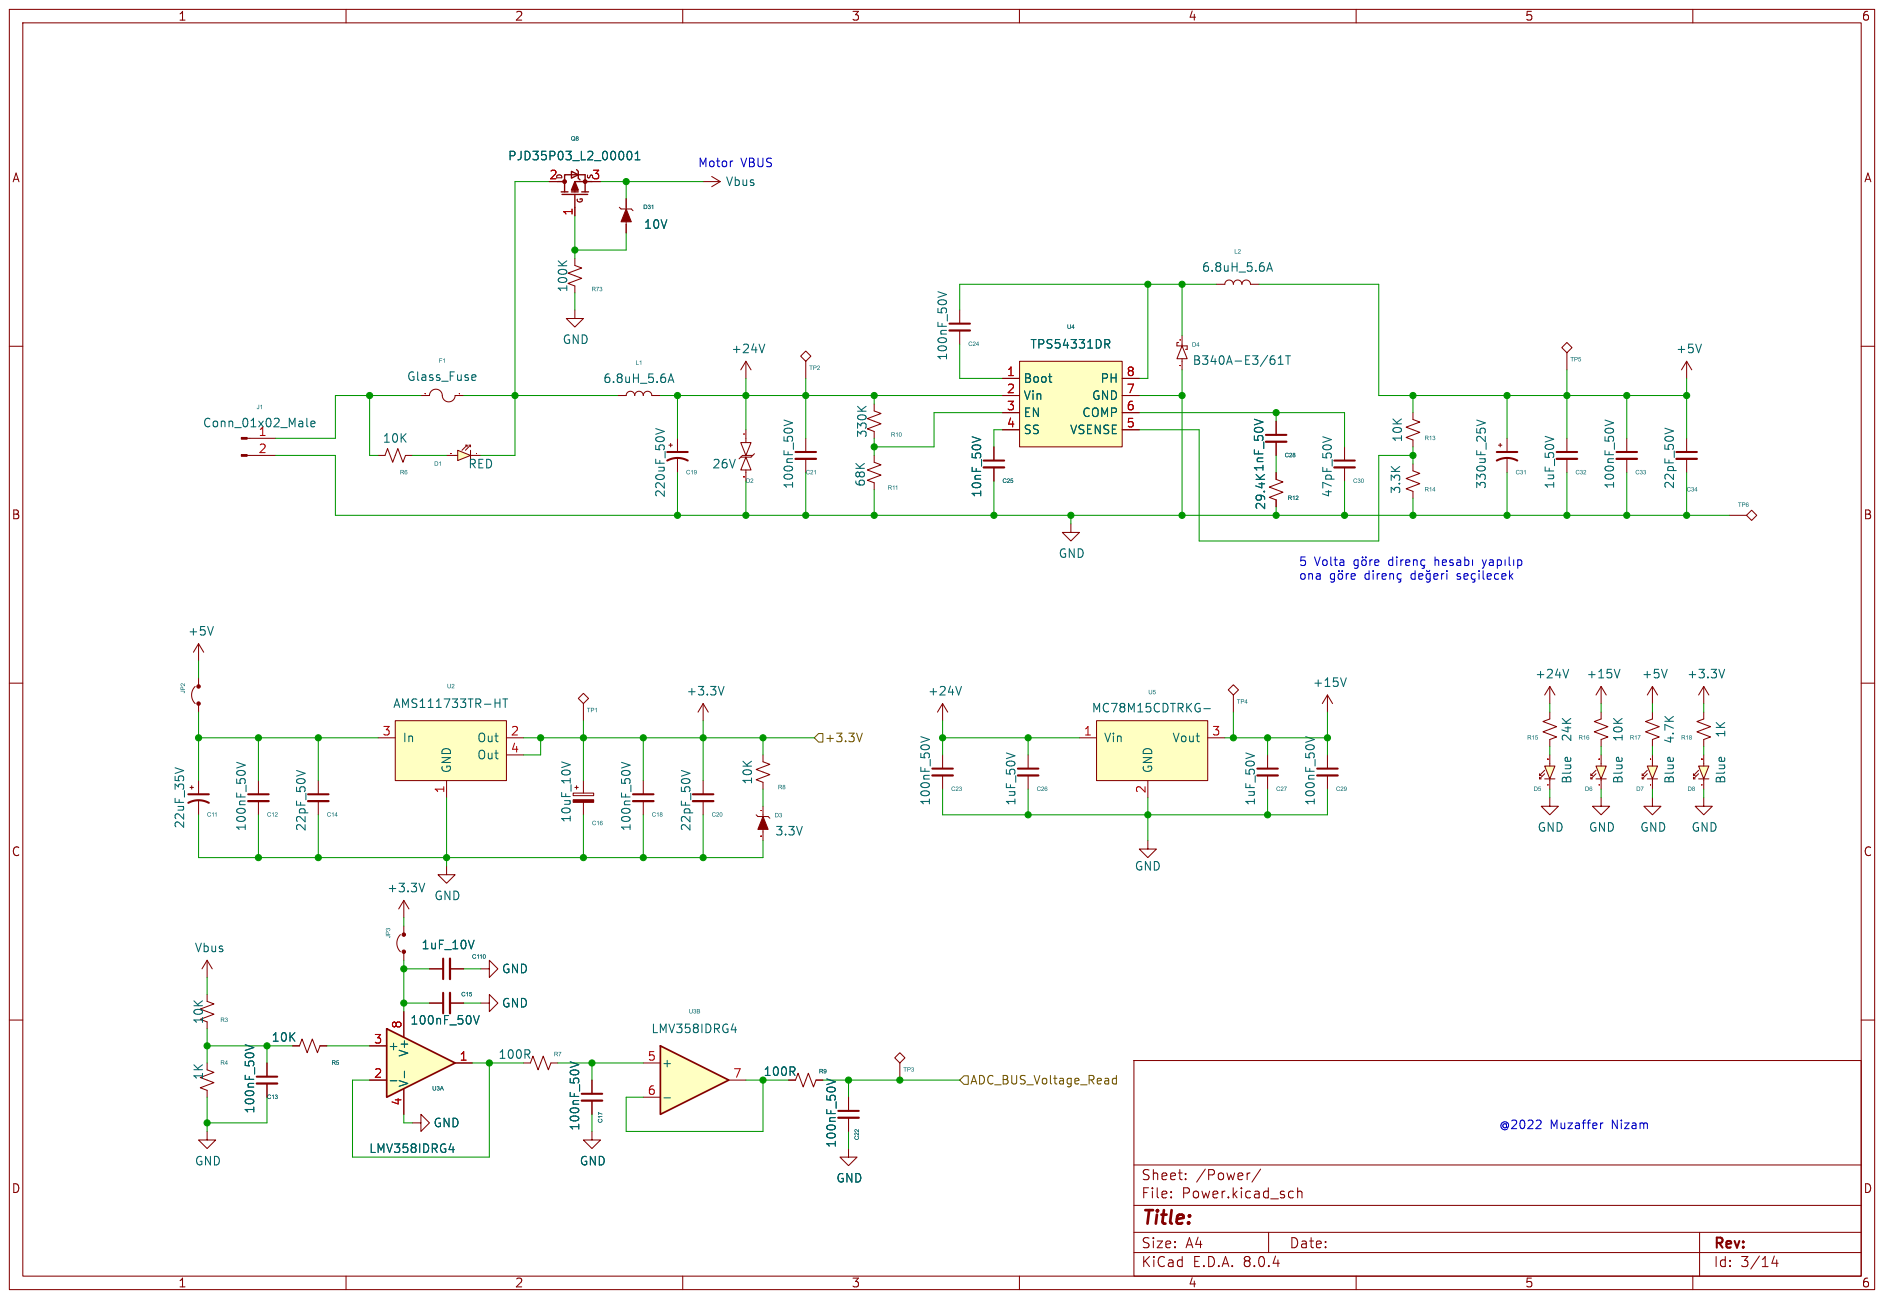
[picture p4: page 3]

ona þÿgöreþÿdirenç þÿdeeri þÿseçilecek Motor VBUS
Vbus

5 Volta þÿgöreþÿdirenç þÿhesab1 þÿyap1l1p

Id: 3/14 Title: File: Power.kicad_sch Sheet: /Power/

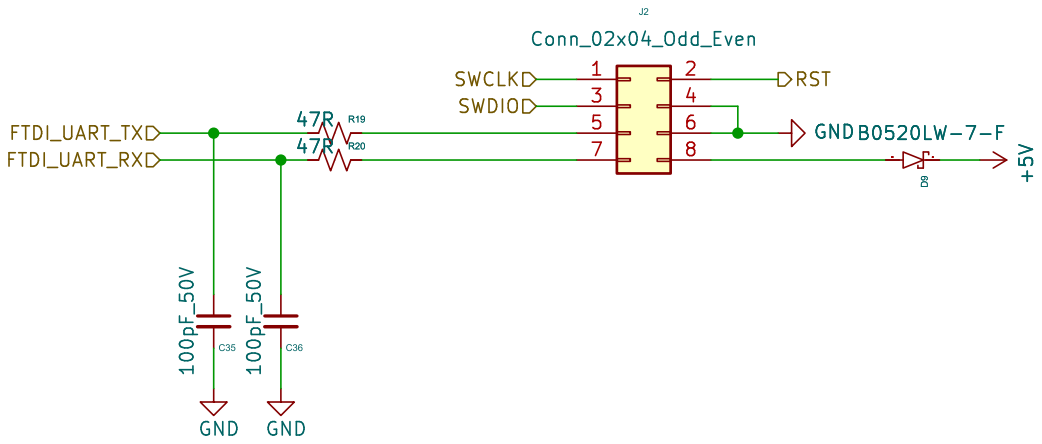
[picture p5: page 4]

Id: 4/14 Title: File: Programming_and_Uart.kicad_sch Sheet: /Programming_and_Uart/ +5V GND

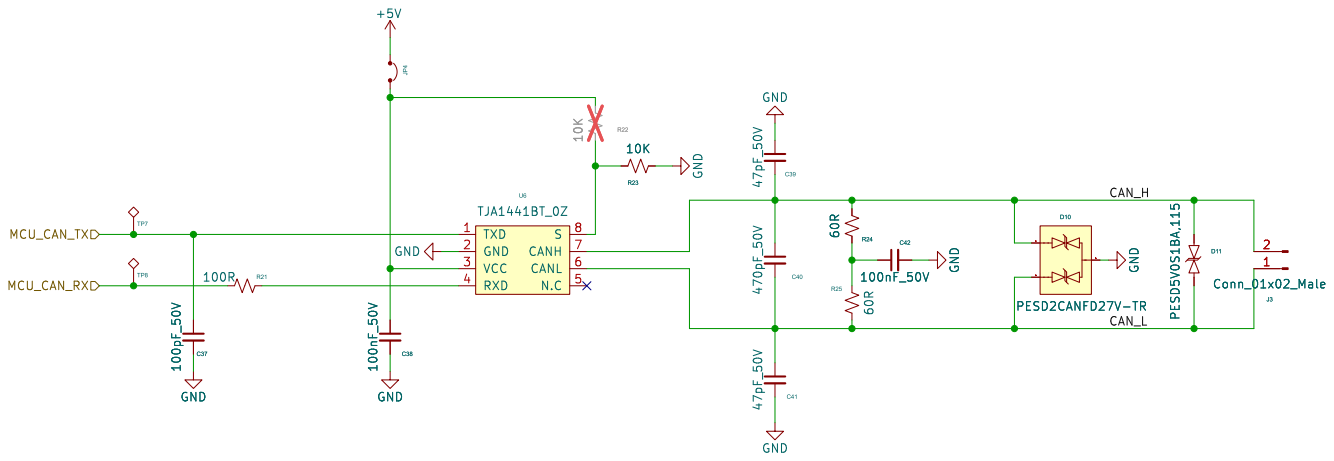
[picture p6: page 5]

Id: 6/14 Title: File: CanBus_Communication.kicad_sch Sheet: /CanBus_Communication/

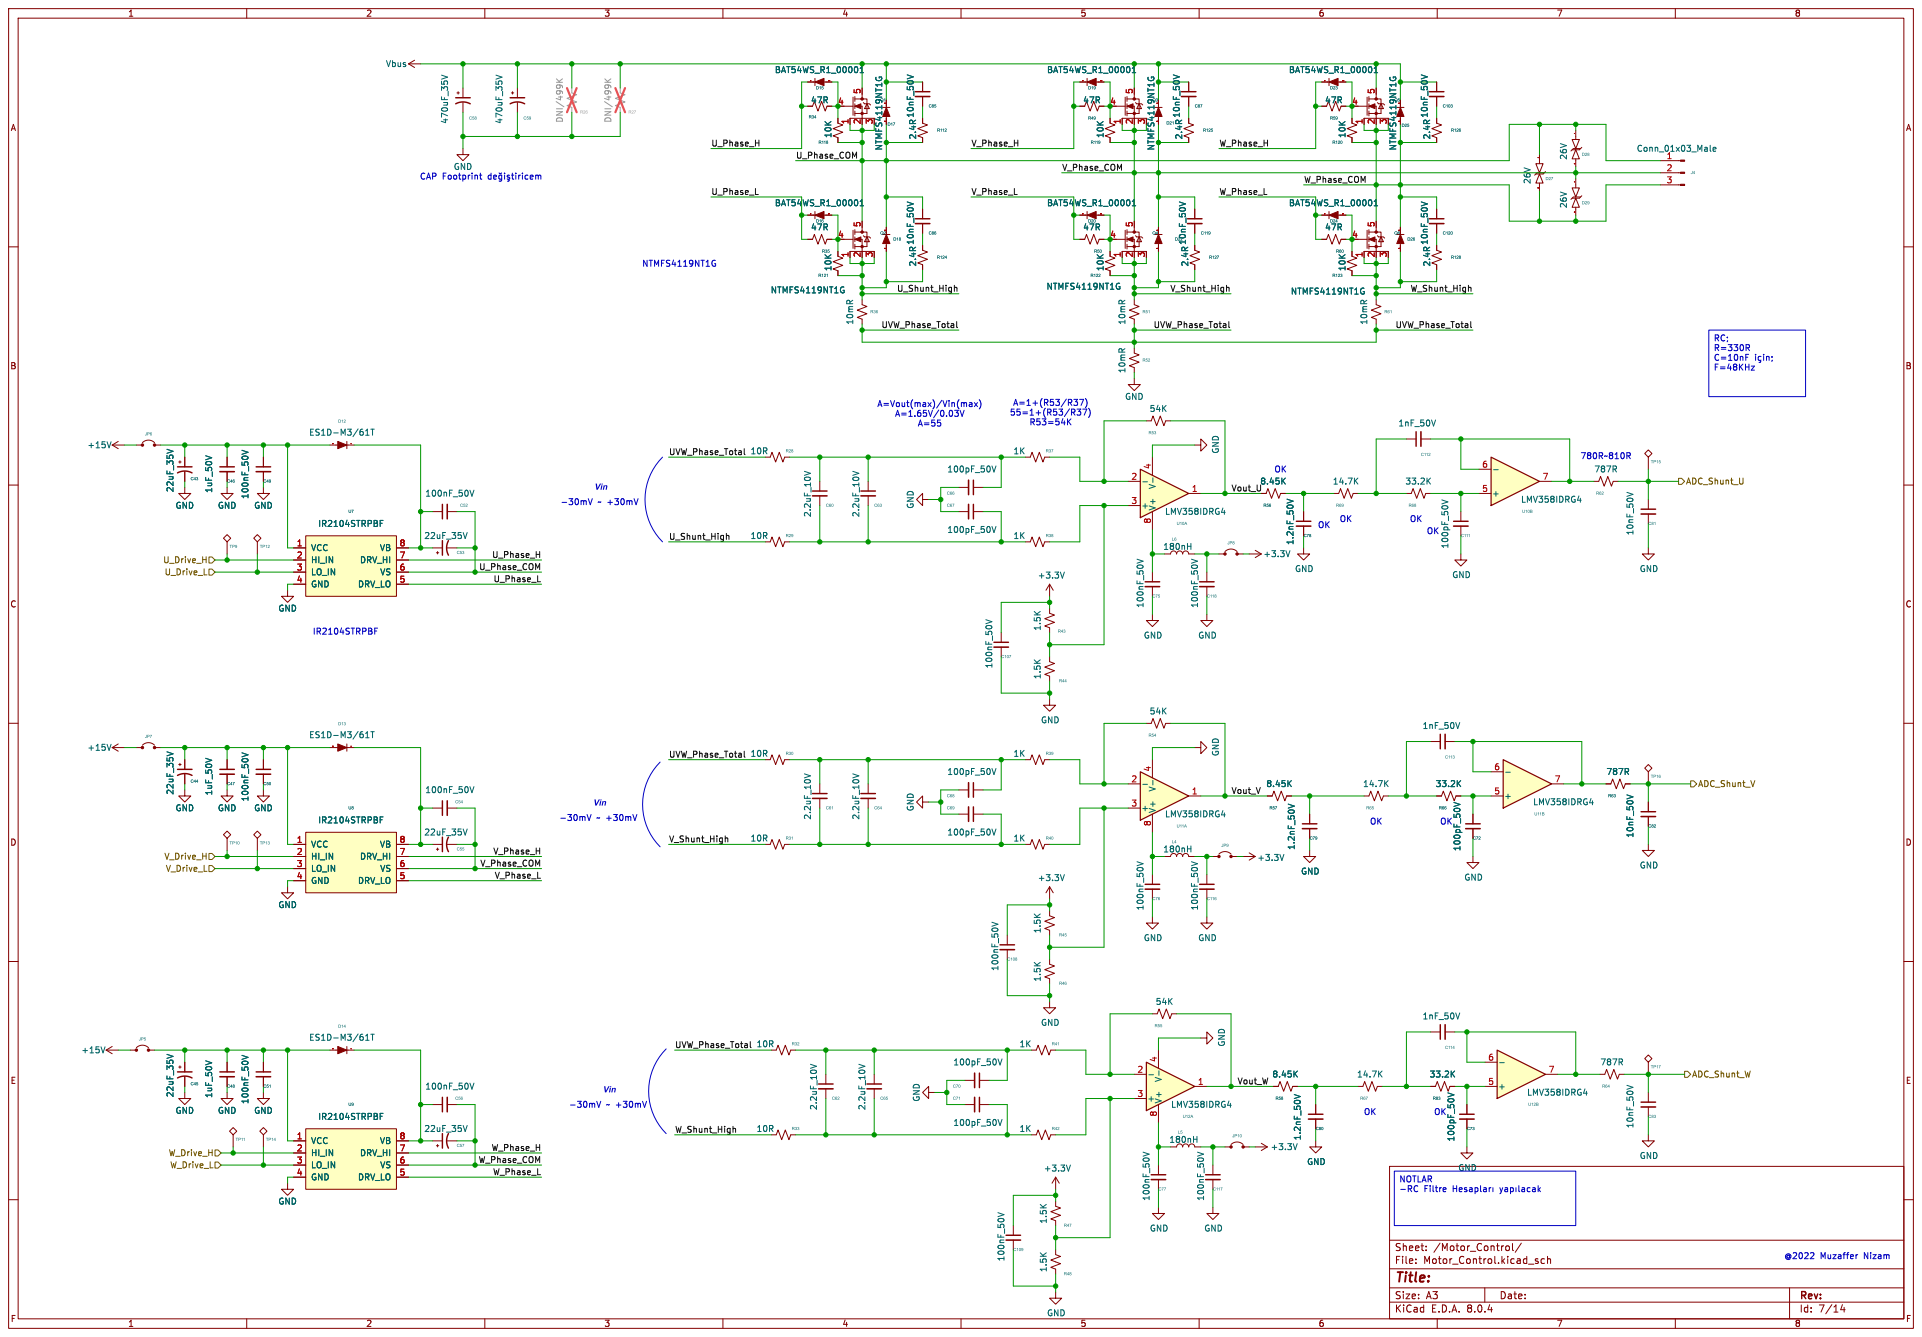
[picture p7: page 6]

A=Vout(max)/Vin(max) A=1.65V/0.03V

NOTLAR
-RC Filtre þÿHesaplar1 þÿyap1lacak

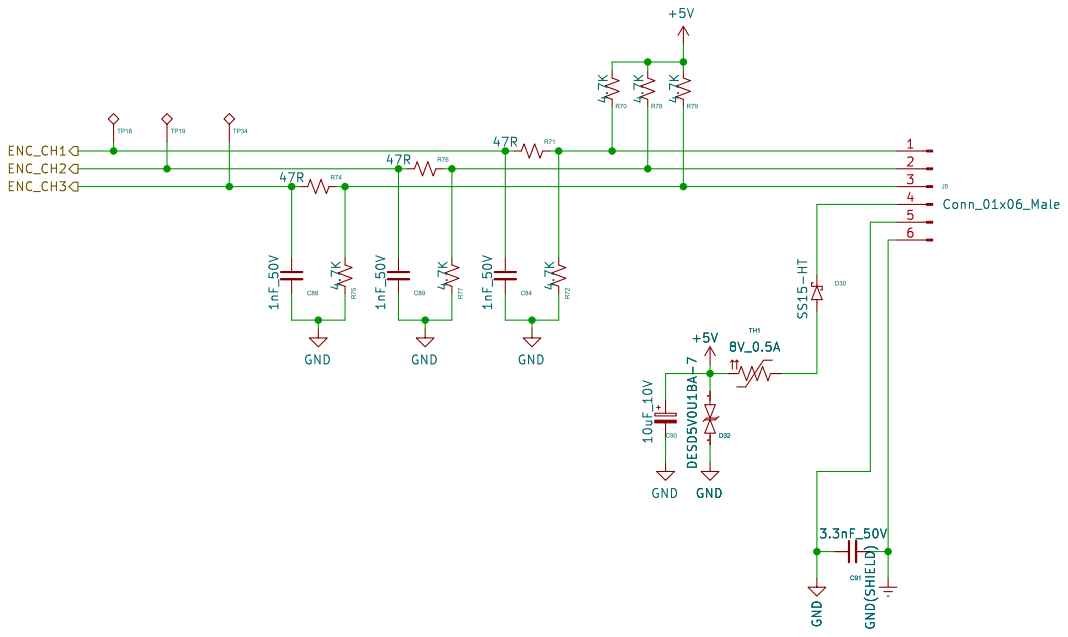
[picture p8: page 7]

Id: 8/14 Title: File: Encoder.kicad_sch Sheet: /Encoder/

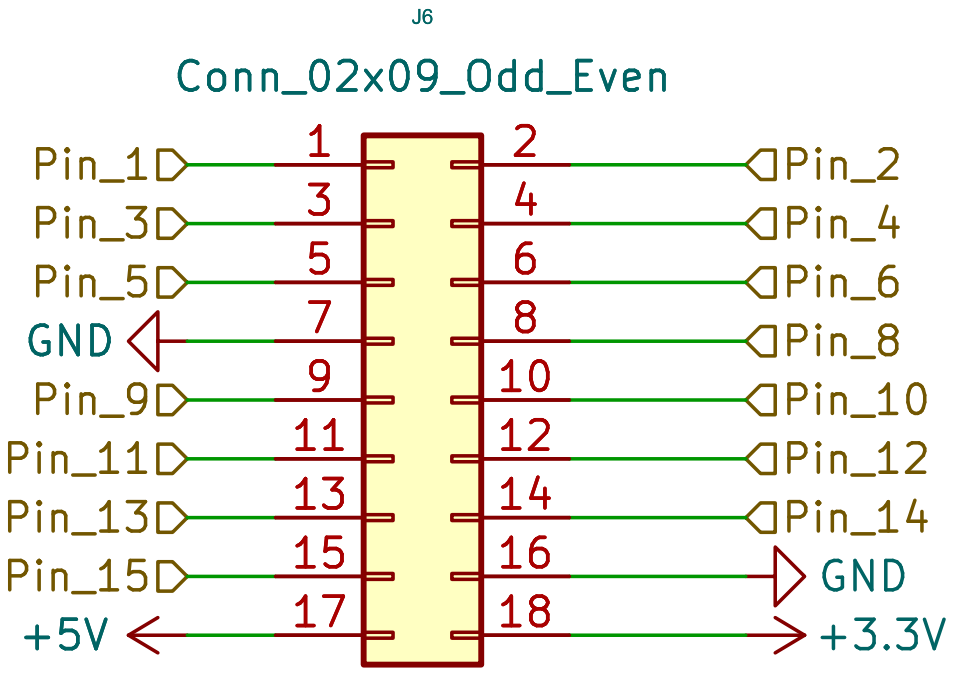
[picture p9: page 8]

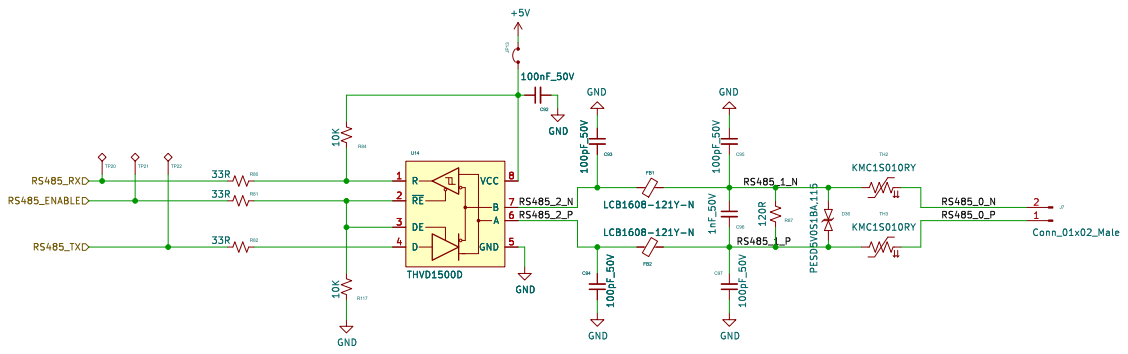
[picture p10: page 9]

Id: 12/14 Title: File: RS485_Communication.kicad_sch Sheet: /RS485_Communication/

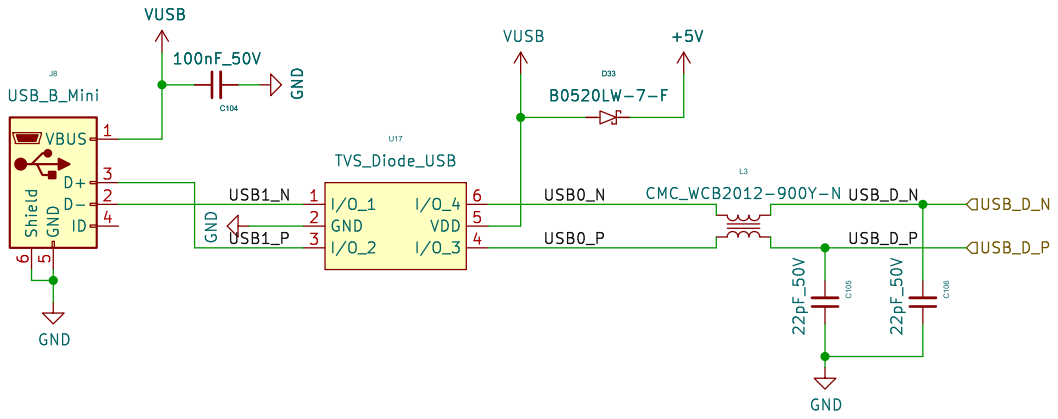
[picture p11: page 10]

Id: 13/14 Title: File: USB_Communication.kicad_sch Sheet: /USB_Communication/

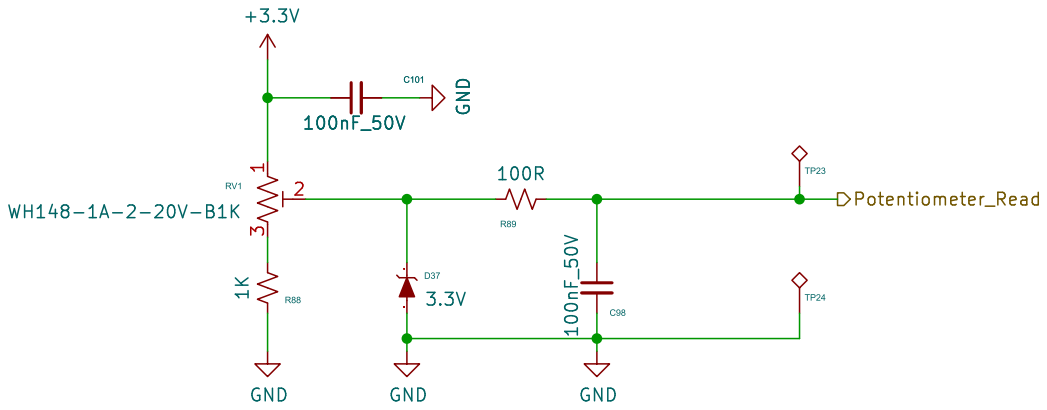
[picture p12: page 11]

Id: 13/14 Title: File: Potentiometer.kicad_sch Sheet: /Potentiometer/

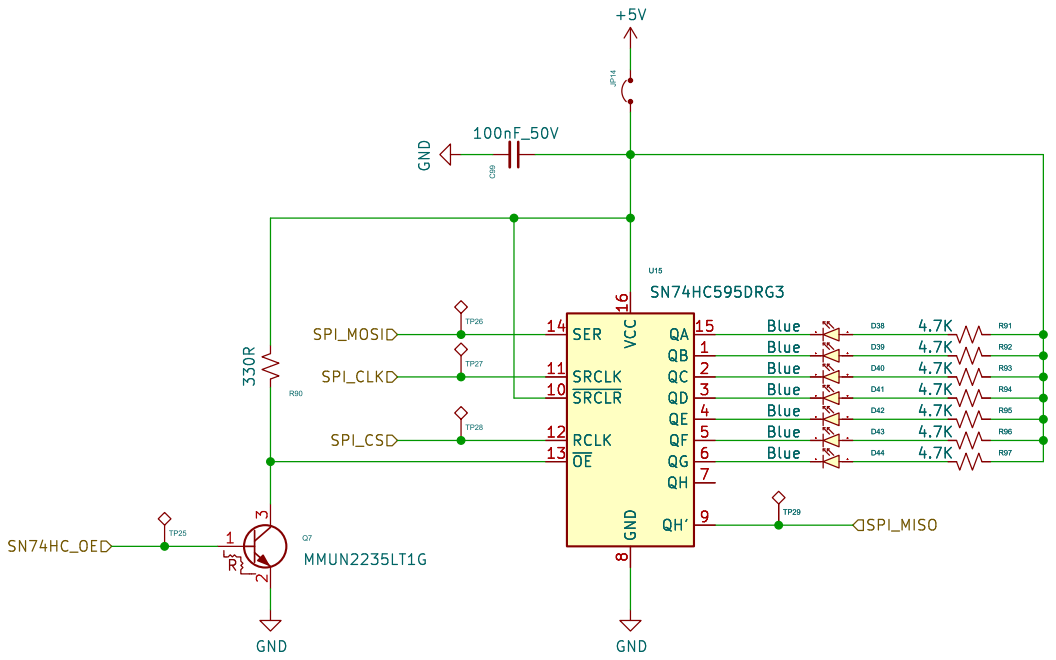
[picture p13: page 12]

Id: 14/14 Title: File: LED_OUT.kicad_sch Sheet: /LED_OUT/

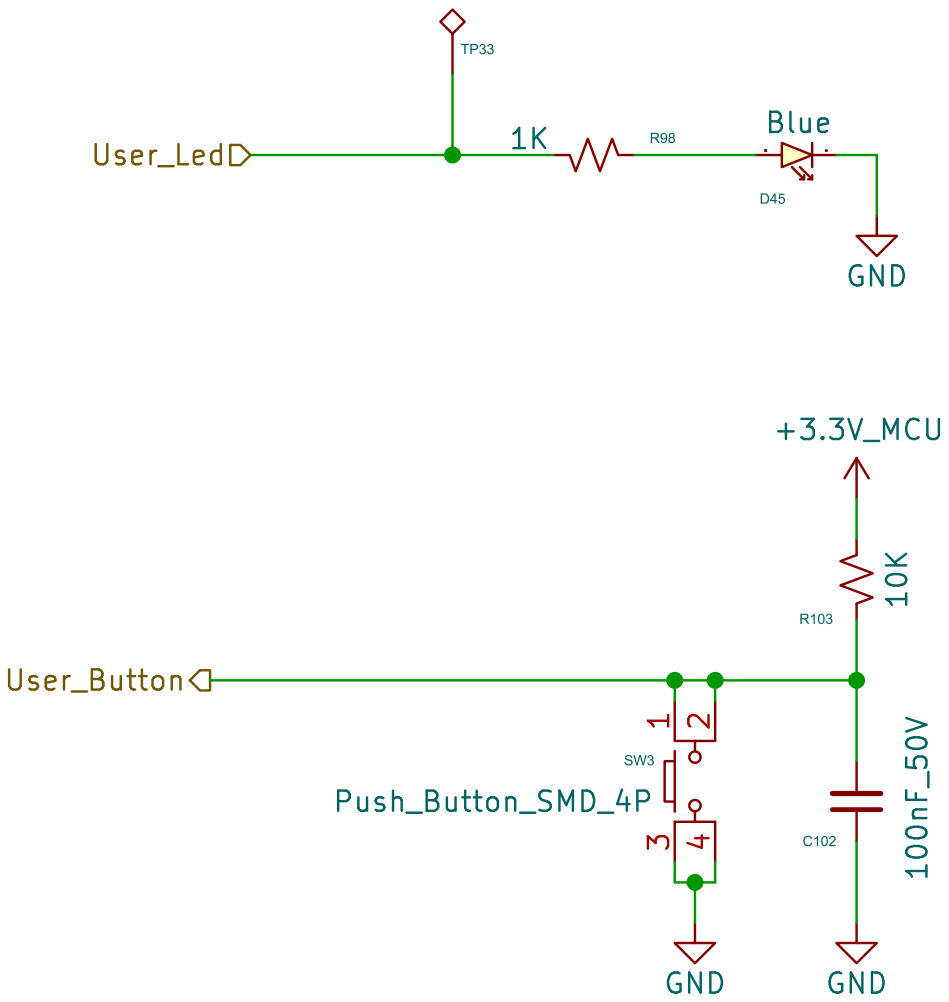
[picture p14: page 13]

Id: 14/14 Title: File: User_Command.kicad_sch Sheet: /User_Command/

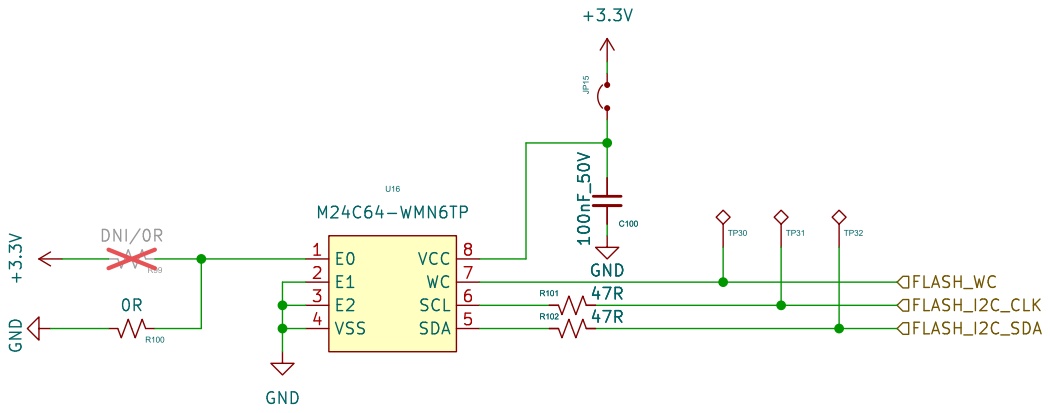
[picture p15: page 14]

Id: 15/14 Title: File: Flash_IC.kicad_sch Sheet: /Flash_IC/
