muzaffernizam/STM32-Motor-Control-BLDC-24V/Experiment/Opamp_EXP/Opamp_EXP.kicad_sch

## KiCad design Experiment/Opamp_EXP/Opamp_EXP.kicad_sch (2024-09-15)

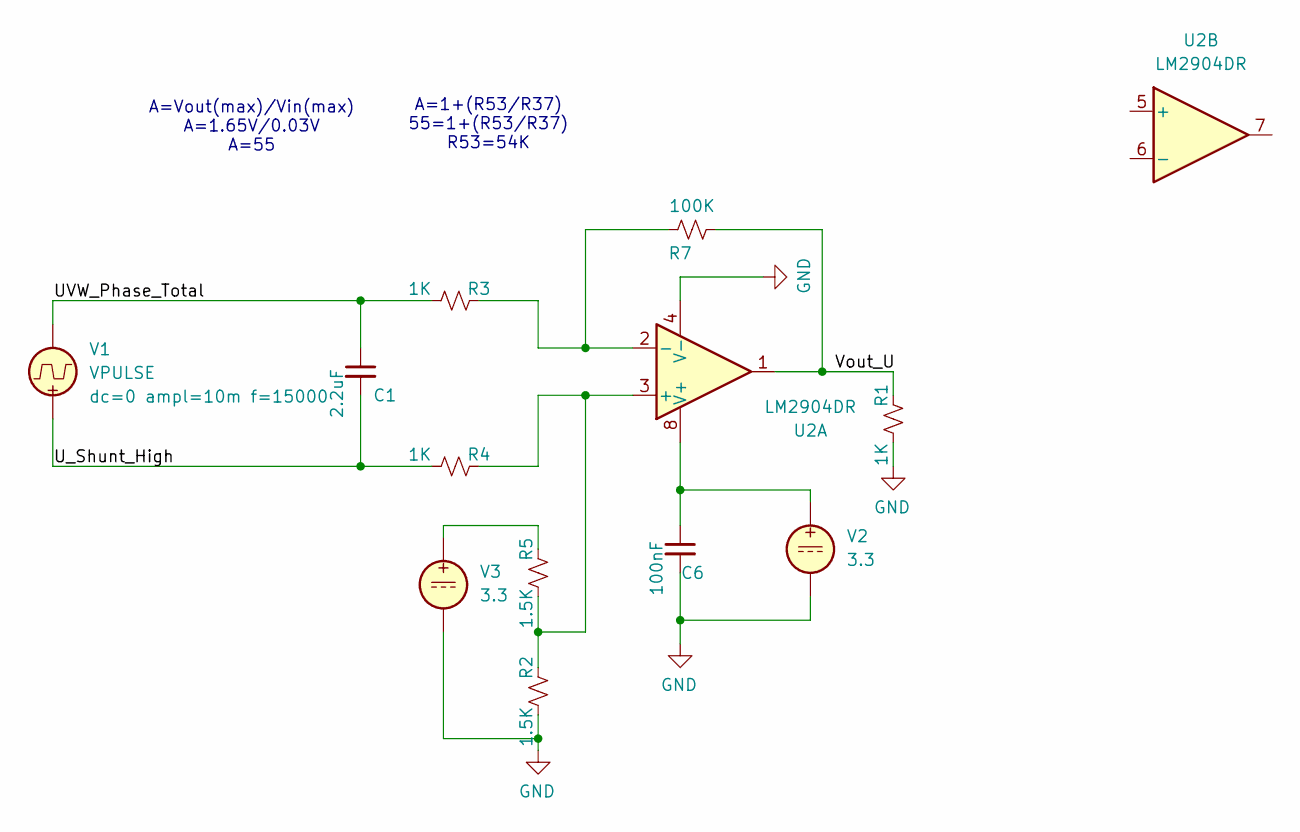
[picture p16: schematic Opamp_EXP.kicad_sch]

Parts:
C1: 2.2uF; CAP_0603; MFG P/N CL10A225KP8NNNC
C6: 100nF; CAP_0603; MFG P/N *
R1, R3, R4: 1K; RES_0603; MFG P/N *
R2, R5: 1.5K; RES_0603; MFG P/N *
R7: 100K; RES_0603; MFG P/N *
U2: LM2904DR; SOIC-8_3.9x4.9mm_P1.27mm; MFG P/N LM2904DR
V1: VPULSE
V2, V3: 3.3

Connections:
GND: C6.2, R1.2, R2.2, U2.4 (V-), V2.2, V3.2
unnamed: C6.1, U2.8 (V+), V2.1
unnamed: R2.1, R4.1, R5.2, U2.3 (+)
unnamed: R3.1, R7.2, U2.2 (-)
unnamed: R5.1, V3.1
UVW_Phase_Total: C1.1, R3.2, V1.2
U_Shunt_High: C1.2, R4.2, V1.1
Vout_U: R1.1, R7.1, U2.1

Notes on the sheet:
A=1+(R53/R37) 55=1+(R53/R37) R53=54K
A=Vout(max)/Vin(max) A=1.65V/0.03V A=55
