muzaffernizam/STM32-Motor-Control-BLDC-24V/Hardware/STM32_Motor_Kit_v0.1/Analog_Input.kicad_sch

## KiCad design Hardware/STM32_Motor_Kit_v0.1/Analog_Input.kicad_sch (2024-07-18)

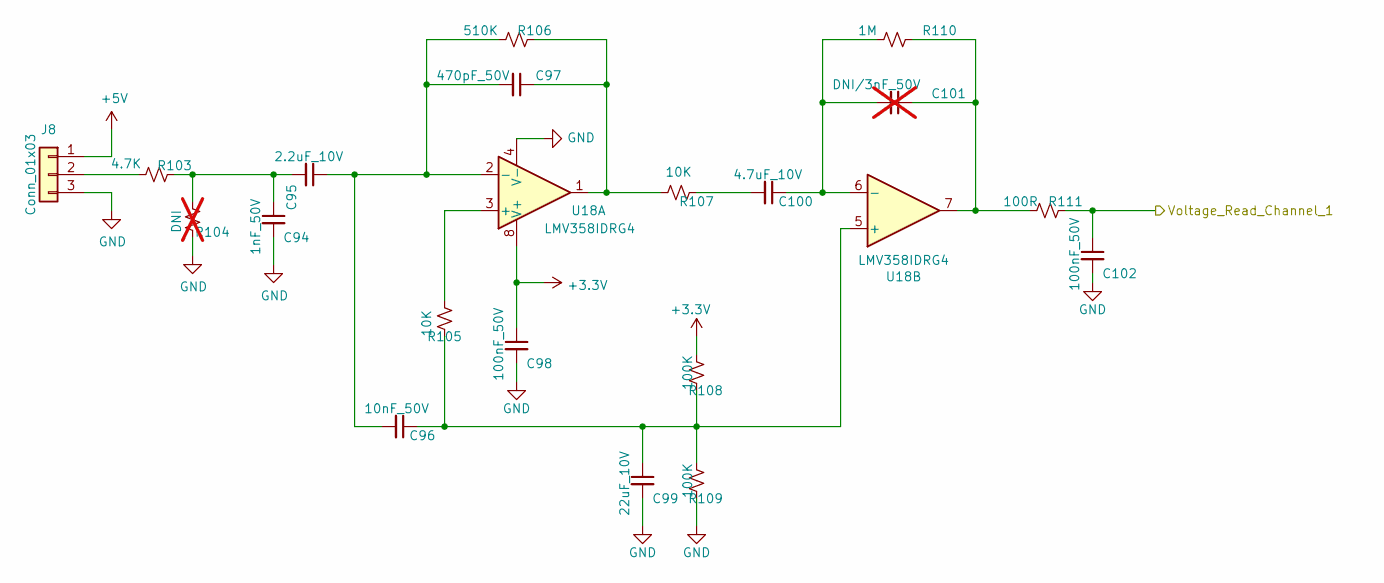
[picture p17: schematic Analog_Input.kicad_sch]

Parts:
C94: 1nF_50V; CAP_0603; MFG P/N *
C95: 2.2uF_10V; CAP_1206; MFG P/N *
C96: 10nF_50V; CAP_0603; MFG P/N *
C97: 470pF_50V; CAP_0603; MFG P/N *
C98, C102: 100nF_50V; CAP_0603; MFG P/N *
C99: 22uF_10V; CAP_1206; MFG P/N *
C100: 4.7uF_10V; CAP_1206; MFG P/N *
C101: DNI/3nF_50V; CAP_0603; MFG P/N *; not fitted
J8: Conn_01x03; PinHeader_1x03_P2.54mm_Vertical; MFG P/N CDM324
R103: 4.7K; RES_1206; MFG P/N *
R104: DNI; RES_0603; MFG P/N *; not fitted
R105, R107: 10K; RES_0603; MFG P/N *
R106: 510K; RES_0603; MFG P/N *
R108, R109: 100K; RES_0603; MFG P/N *
R110: 1M; RES_0603; MFG P/N *
R111: 100R; RES_0603; MFG P/N *
U18: LMV358IDRG4; SOIC-8_3.9x4.9mm_P1.27mm; MFG P/N LMV358IDRG4

Connections:
+3.3V: C98.1, R108.2, U18.8 (V+)
+5V: J8.1
GND: C94.2, C98.2, C99.2, C102.2, J8.3, R104.1, R109.1, U18.4 (V-)
unnamed: C94.1, C95.2, R103.2, R104.2
unnamed: C95.1, C96.2, C97.2, R106.1, U18.2 (-)
unnamed: C96.1, C99.1, R105.1, R108.1, R109.2, U18.5 (+)
unnamed: C97.1, R106.2, R107.1, U18.1
unnamed: C100.1, C101.2, R110.1, U18.6 (-)
unnamed: C100.2, R107.2
unnamed: C101.1, R110.2, R111.1, U18.7
unnamed: J8.2, R103.1
unnamed: R105.2, U18.3 (+)
Voltage_Read_Channel_1: C102.1, R111.2
