muzaffernizam/STM32-Motor-Control-BLDC-24V/Hardware/STM32_Motor_Kit_v0.1/CanBus_Communication.kicad_sch

## KiCad design Hardware/STM32_Motor_Kit_v0.1/CanBus_Communication.kicad_sch (2025-01-12)

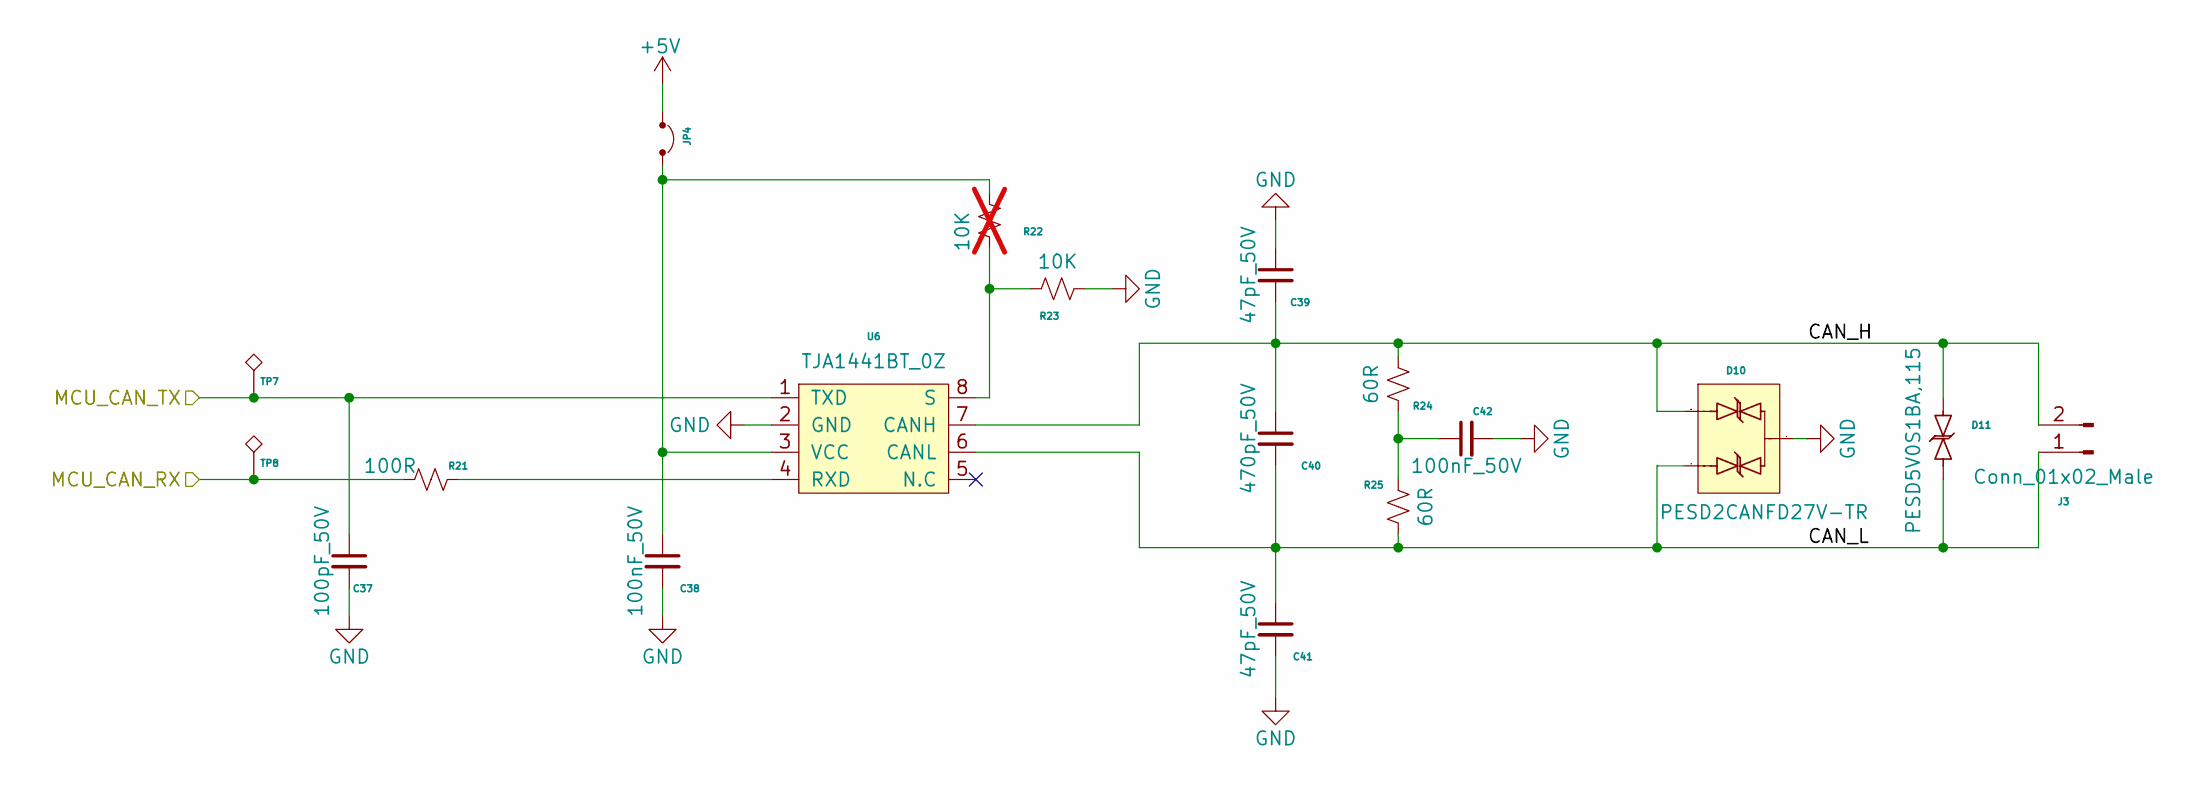
[picture p18: schematic CanBus_Communication.kicad_sch]

Parts:
C37: 100pF_50V; CAP_0603; MFG P/N *
C38, C42: 100nF_50V; CAP_0603; MFG P/N *
C39, C41: 47pF_50V; CAP_0603; MFG P/N *
C40: 470pF_50V; CAP_0603; MFG P/N *
D10: PESD2CANFD27V-TR; SOT-23; MFG P/N PESD2CANFD27V-TR
D11: PESD5V0S1BA,115; SOD-323; MFG P/N *
J3: Conn_01x02_Male; TerminalBlock_Phoenix_MKDS-1,5-2_1x02_P5.00mm_Horizontal; MFG P/N L-KLS2-306V-5.00-02P-4C
JP4: Jumper_Pinheader; PinHeader_1x02_P2.54mm_Vertical; MFG P/N *
R21: 100R; RES_0603; MFG P/N *
R22: 10K; RES_0603; MFG P/N *; not fitted
R23: 10K; RES_0603; MFG P/N *
R24, R25: 60R; RES_0603; MFG P/N *
TP7, TP8: Test_Point; TEST_POINT
U6: TJA1441BT_0Z; SOIC-8_3.9x4.9mm_P1.27mm; MFG P/N TJA1441BT/0Z

Connections:
+5V: JP4.1 (A)
CAN_H: C39.2, C40.1, D10.1, D11.2, J3.2, R24.1, U6.7 (CANH)
CAN_L: C40.2, C41.1, D10.2, D11.1, J3.1, R25.1, U6.6 (CANL)
GND: C37.2, C38.2, C39.1, C41.2, C42.2, D10.3, R23.1, U6.2 (GND)
MCU_CAN_RX: R21.1, TP8.1
MCU_CAN_TX: C37.1, TP7.1, U6.1 (TXD)
unnamed: C38.1, JP4.2 (B), R22.1, U6.3 (VCC)
unnamed: C42.1, R24.2, R25.2
unnamed: R21.2, U6.4 (RXD)
unnamed: R22.2, R23.2, U6.8 (S)
