muzaffernizam/STM32-Motor-Control-BLDC-24V/Hardware/STM32_Motor_Kit_v0.1/Digital_Input.kicad_sch

## KiCad design Hardware/STM32_Motor_Kit_v0.1/Digital_Input.kicad_sch (2024-07-18)

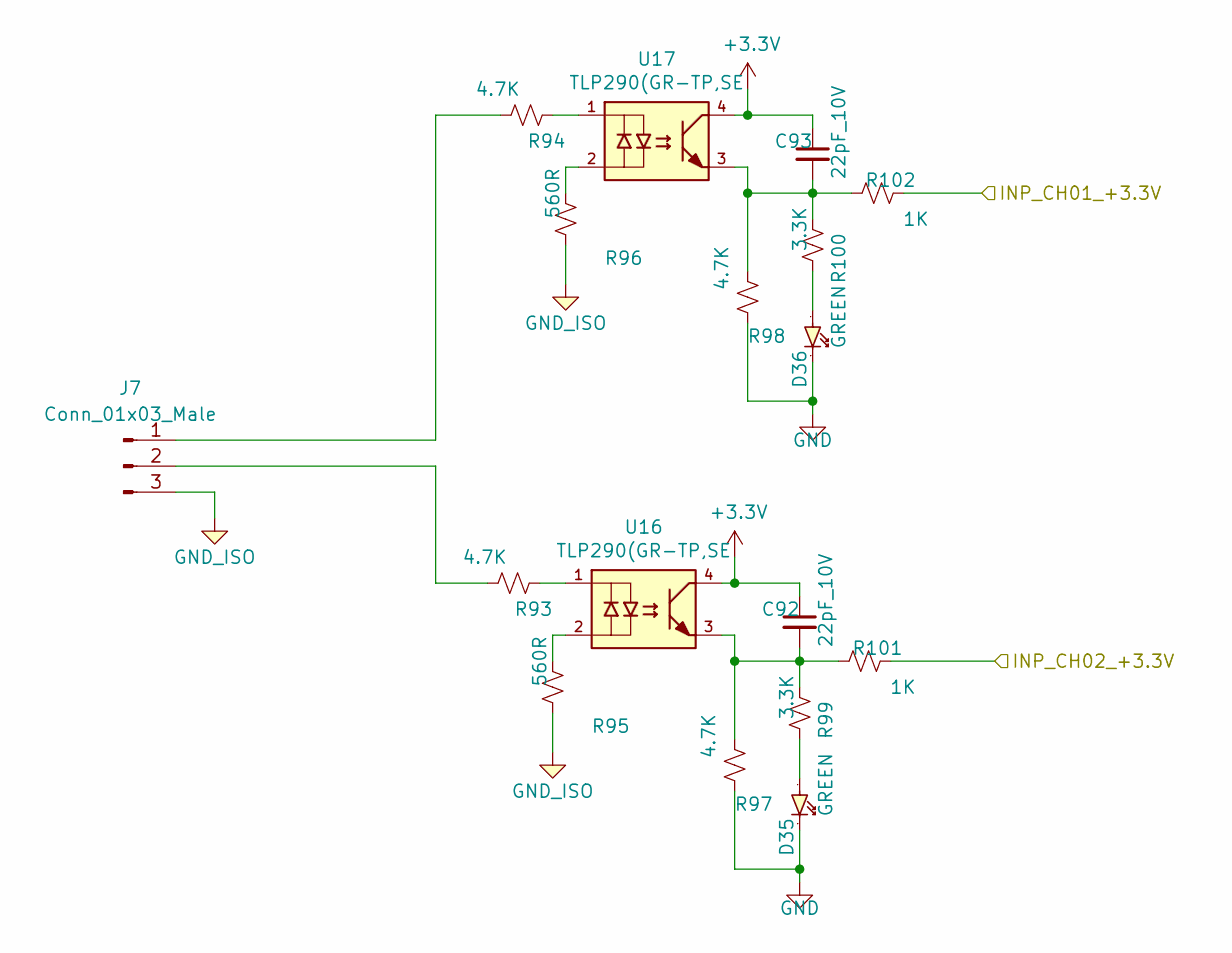
[picture p19: schematic Digital_Input.kicad_sch]

Parts:
C92, C93: 22pF_10V; CAP_0603; MFG P/N *
D35, D36: GREEN; LED_0805; MFG P/N *
J7: Conn_01x03_Male; PhoenixContact_MC_1,5_3-G-3.81_1x03_P3.81mm_Horizontal
R93, R94, R97, R98: 4.7K; RES_0603; MFG P/N *
R95, R96: 560R; RES_0603; MFG P/N *
R99, R100: 3.3K; RES_0603; MFG P/N *
R101, R102: 1K; RES_0603; MFG P/N *
U16, U17: TLP290(GR-TP,SE; SO-4_4.4x2.3mm_P1.27mm; MFG P/N TLP290(GR-TP,SE

Connections:
+3.3V: C92.1, C93.1, U16.4, U17.4
GND: D35.1, D36.1, R97.1, R98.1
GND_ISO: J7.3, R95.1, R96.1
INP_CH01_+3.3V: R102.2
INP_CH02_+3.3V: R101.2
unnamed: C92.2, R97.2, R99.2, R101.1, U16.3
unnamed: C93.2, R98.2, R100.2, R102.1, U17.3
unnamed: D35.2, R99.1
unnamed: D36.2, R100.1
unnamed: J7.1, R94.2
unnamed: J7.2, R93.2
unnamed: R93.1, U16.1
unnamed: R94.1, U17.1
unnamed: R95.2, U16.2
unnamed: R96.2, U17.2
