muzaffernizam/STM32-Motor-Control-BLDC-24V/Hardware/STM32_Motor_Kit_v0.1/Encoder.kicad_sch

## KiCad design Hardware/STM32_Motor_Kit_v0.1/Encoder.kicad_sch (2026-02-23)

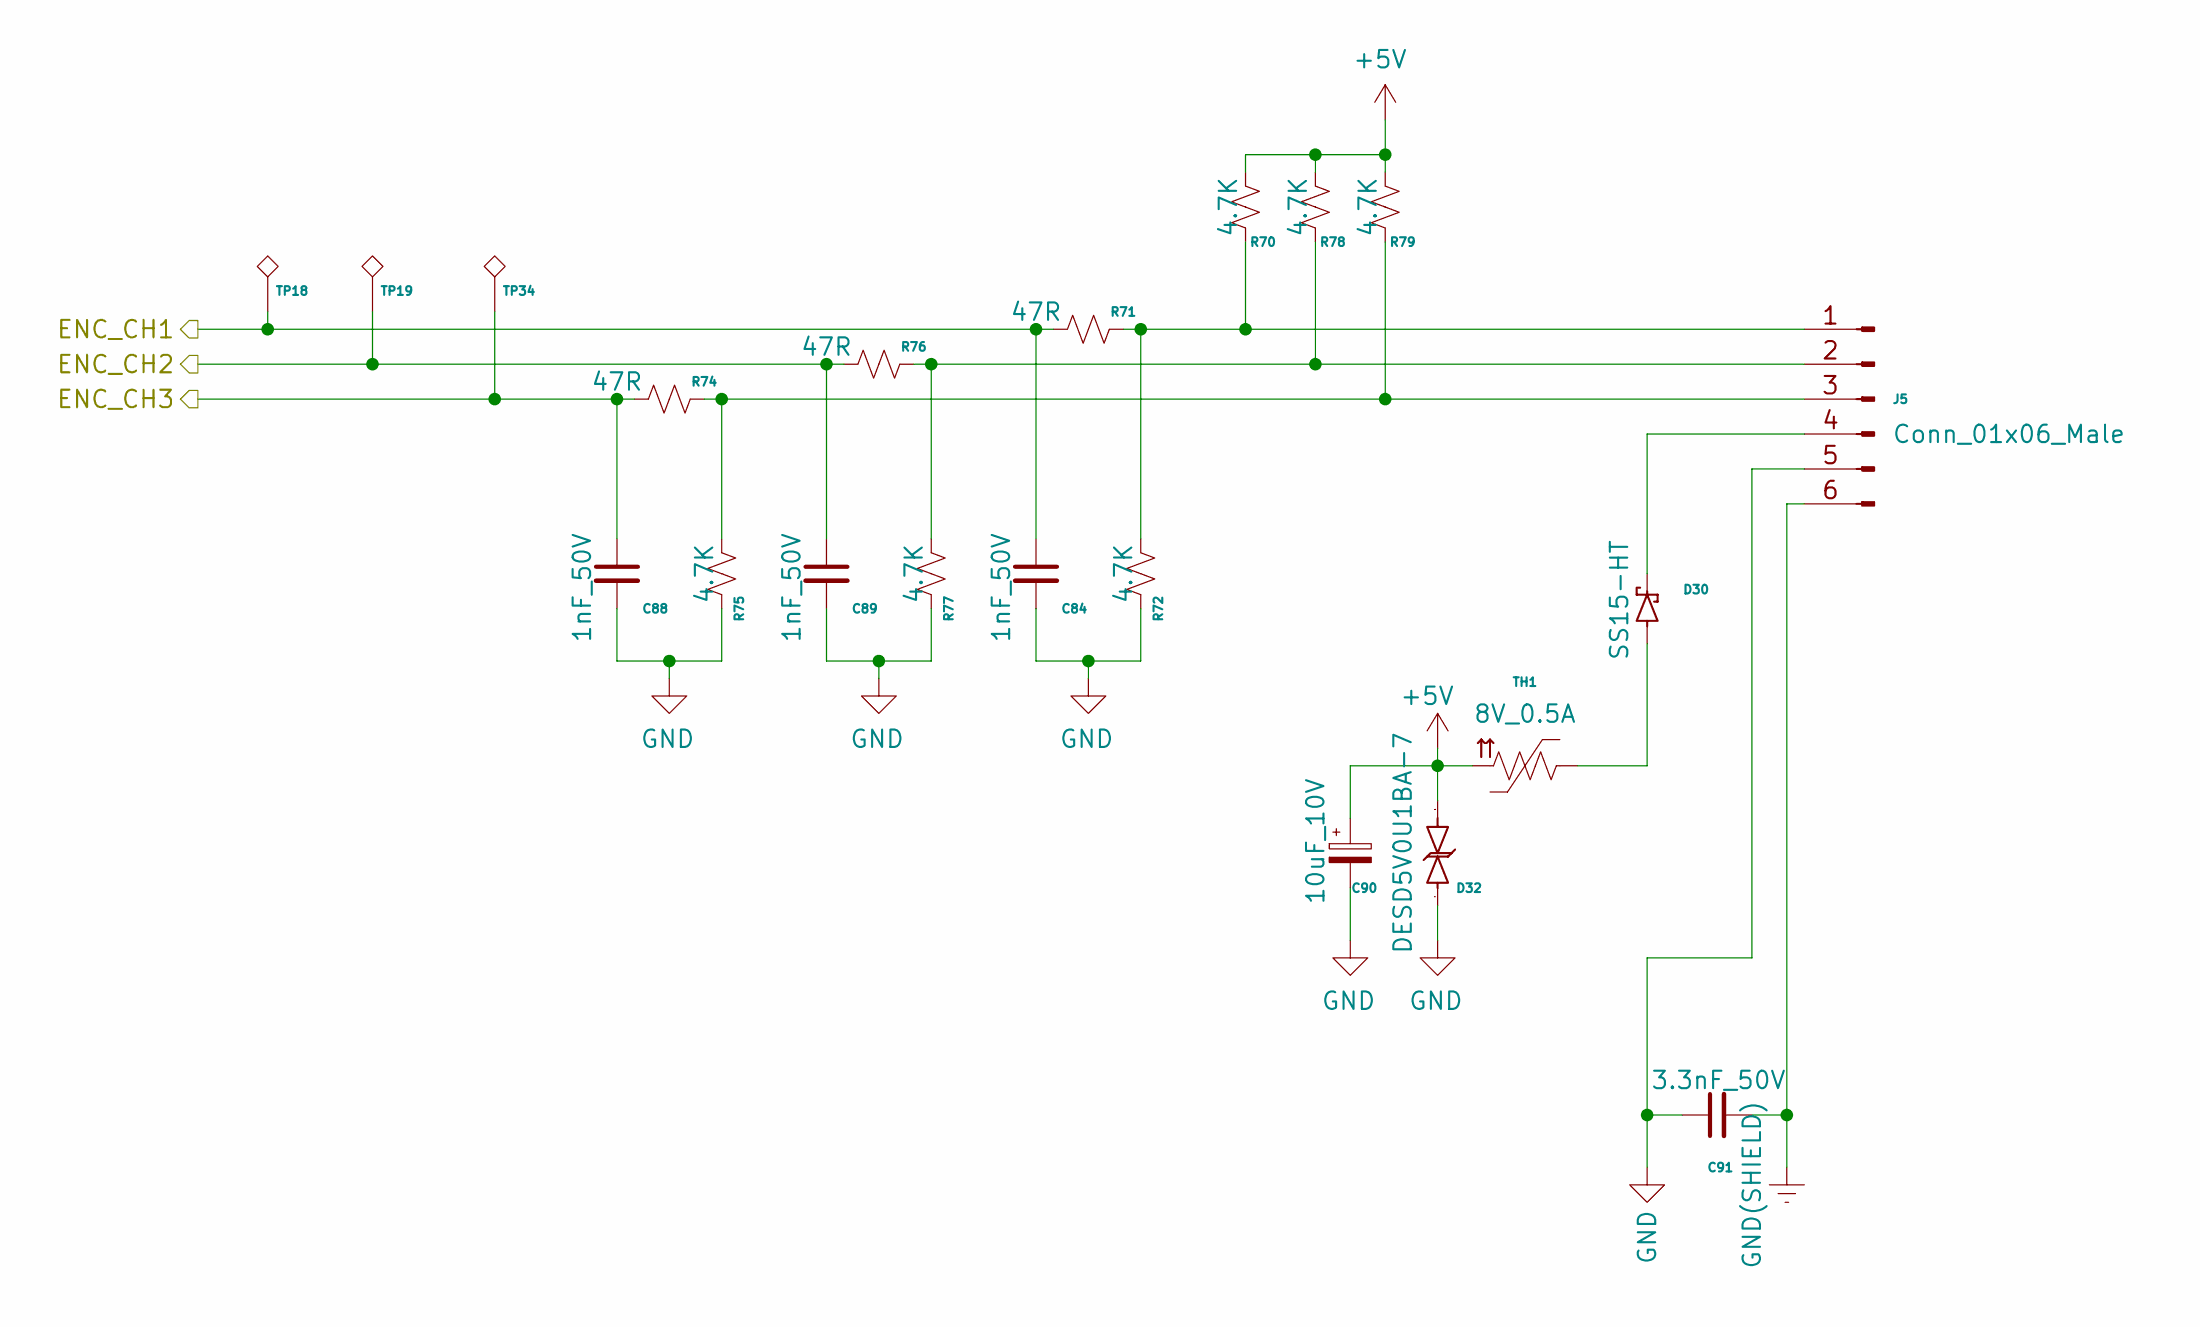
[picture p20: schematic Encoder.kicad_sch]

Parts:
C84, C88, C89: 1nF_50V; CAP_0603; MFG P/N *
C90: 10uF_10V; CAP_1206; MFG P/N TAJA106K010RNJ
C91: 3.3nF_50V; CAP_0603; MFG P/N *
D30: SS15-HT; SMA; MFG P/N *
D32: DESD5V0U1BA-7; SOD-323; MFG P/N *
J5: Conn_01x06_Male; TerminalBlock_Phoenix_MKDS-1,5-6_1x06_P5.00mm_Horizontal
R70, R72, R75, R77, R78, R79: 4.7K; RES_0603; MFG P/N *
R71, R74, R76: 47R; RES_0603; MFG P/N *
TH1: 8V_0.5A; RES_1206; MFG P/N 0ZCJ0050FF2G
TP18, TP19, TP34: Test_Point; TEST_POINT

Connections:
+5V: C90.1, D32.1, R70.2, R78.2, R79.2, TH1.2
ENC_CH1: C84.1, R71.2, TP18.1
ENC_CH2: C89.1, R76.2, TP19.1
ENC_CH3: C88.1, R74.2, TP34.1
GND: C84.2, C88.2, C89.2, C90.2, C91.1, D32.2, J5.5, R72.1, R75.1, R77.1
GND(SHIELD): C91.2, J5.6
unnamed: D30.1, J5.4
unnamed: D30.2, TH1.1
unnamed: J5.1, R70.1, R71.1, R72.2
unnamed: J5.2, R76.1, R77.2, R78.1
unnamed: J5.3, R74.1, R75.2, R79.1
