muzaffernizam/STM32-Motor-Control-BLDC-24V/Hardware/STM32_Motor_Kit_v0.1/Flash_IC.kicad_sch

## KiCad design Hardware/STM32_Motor_Kit_v0.1/Flash_IC.kicad_sch (2026-02-23)

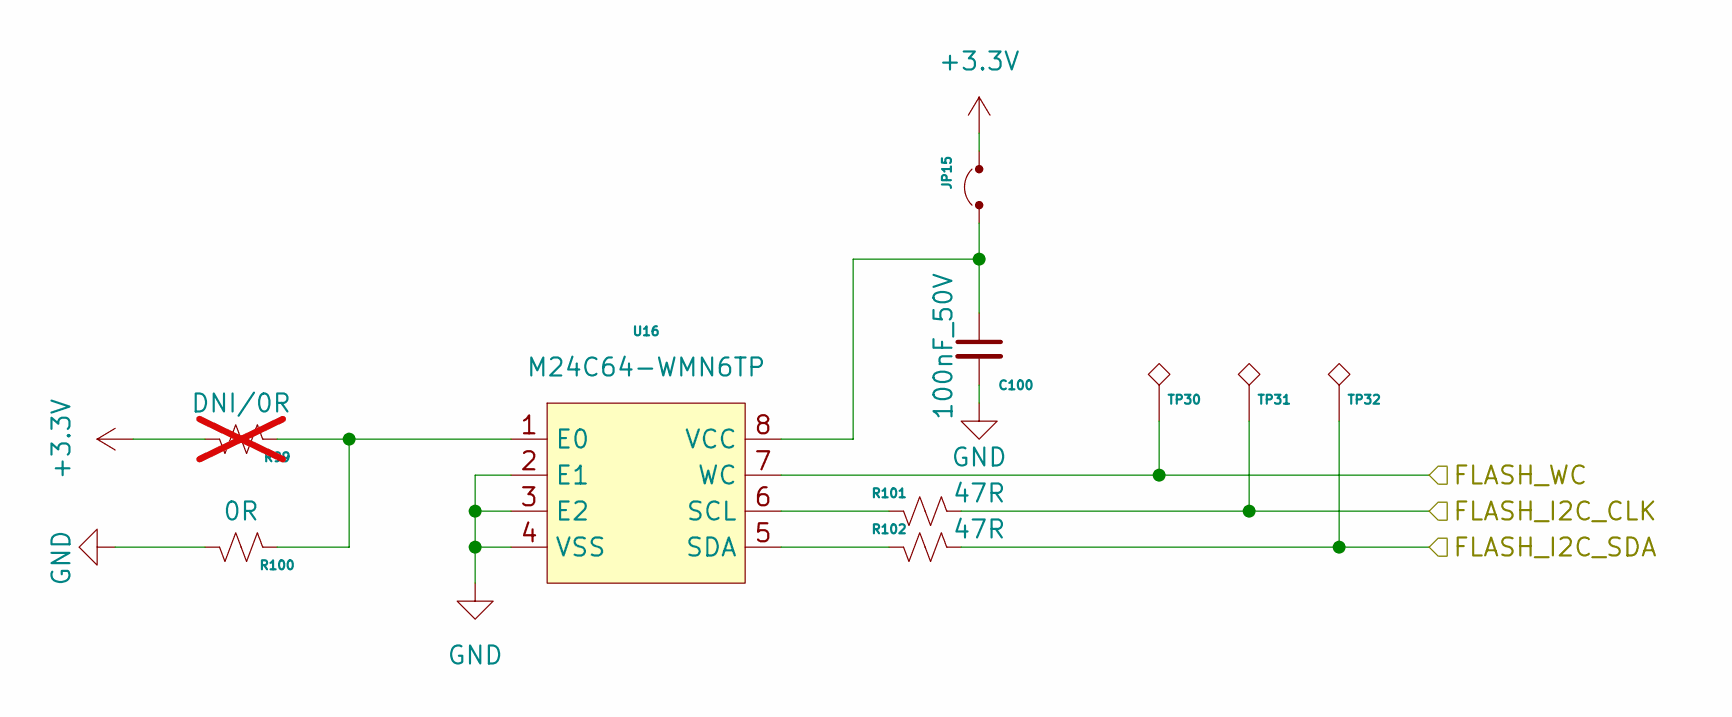
[picture p21: schematic Flash_IC.kicad_sch]

Parts:
C100: 100nF_50V; CAP_0603; MFG P/N *
JP15: Jumper_Pinheader; PinHeader_1x02_P2.54mm_Vertical; MFG P/N *
R99: DNI/0R; RES_0603; MFG P/N *; not fitted
R100: 0R; RES_0603; MFG P/N *
R101, R102: 47R; RES_0603; MFG P/N *
TP30, TP31, TP32: Test_Point; TEST_POINT
U16: M24C64-WMN6TP; SOIC-8_3.9x4.9mm_P1.27mm; MFG P/N M24C64-WMN6TP

Connections:
+3.3V: JP15.2 (B), R99.2
FLASH_I2C_CLK: R101.1, TP31.1
FLASH_I2C_SDA: R102.1, TP32.1
FLASH_WC: TP30.1, U16.7 (WC)
GND: C100.2, R100.2, U16.2 (E1), U16.3 (E2), U16.4 (VSS)
unnamed: C100.1, JP15.1 (A), U16.8 (VCC)
unnamed: R99.1, R100.1, U16.1 (E0)
unnamed: R101.2, U16.6 (SCL)
unnamed: R102.2, U16.5 (SDA)
