muzaffernizam/STM32-Motor-Control-BLDC-24V/Hardware/STM32_Motor_Kit_v0.1/LED_OUT.kicad_sch

## KiCad design Hardware/STM32_Motor_Kit_v0.1/LED_OUT.kicad_sch (2026-02-23)

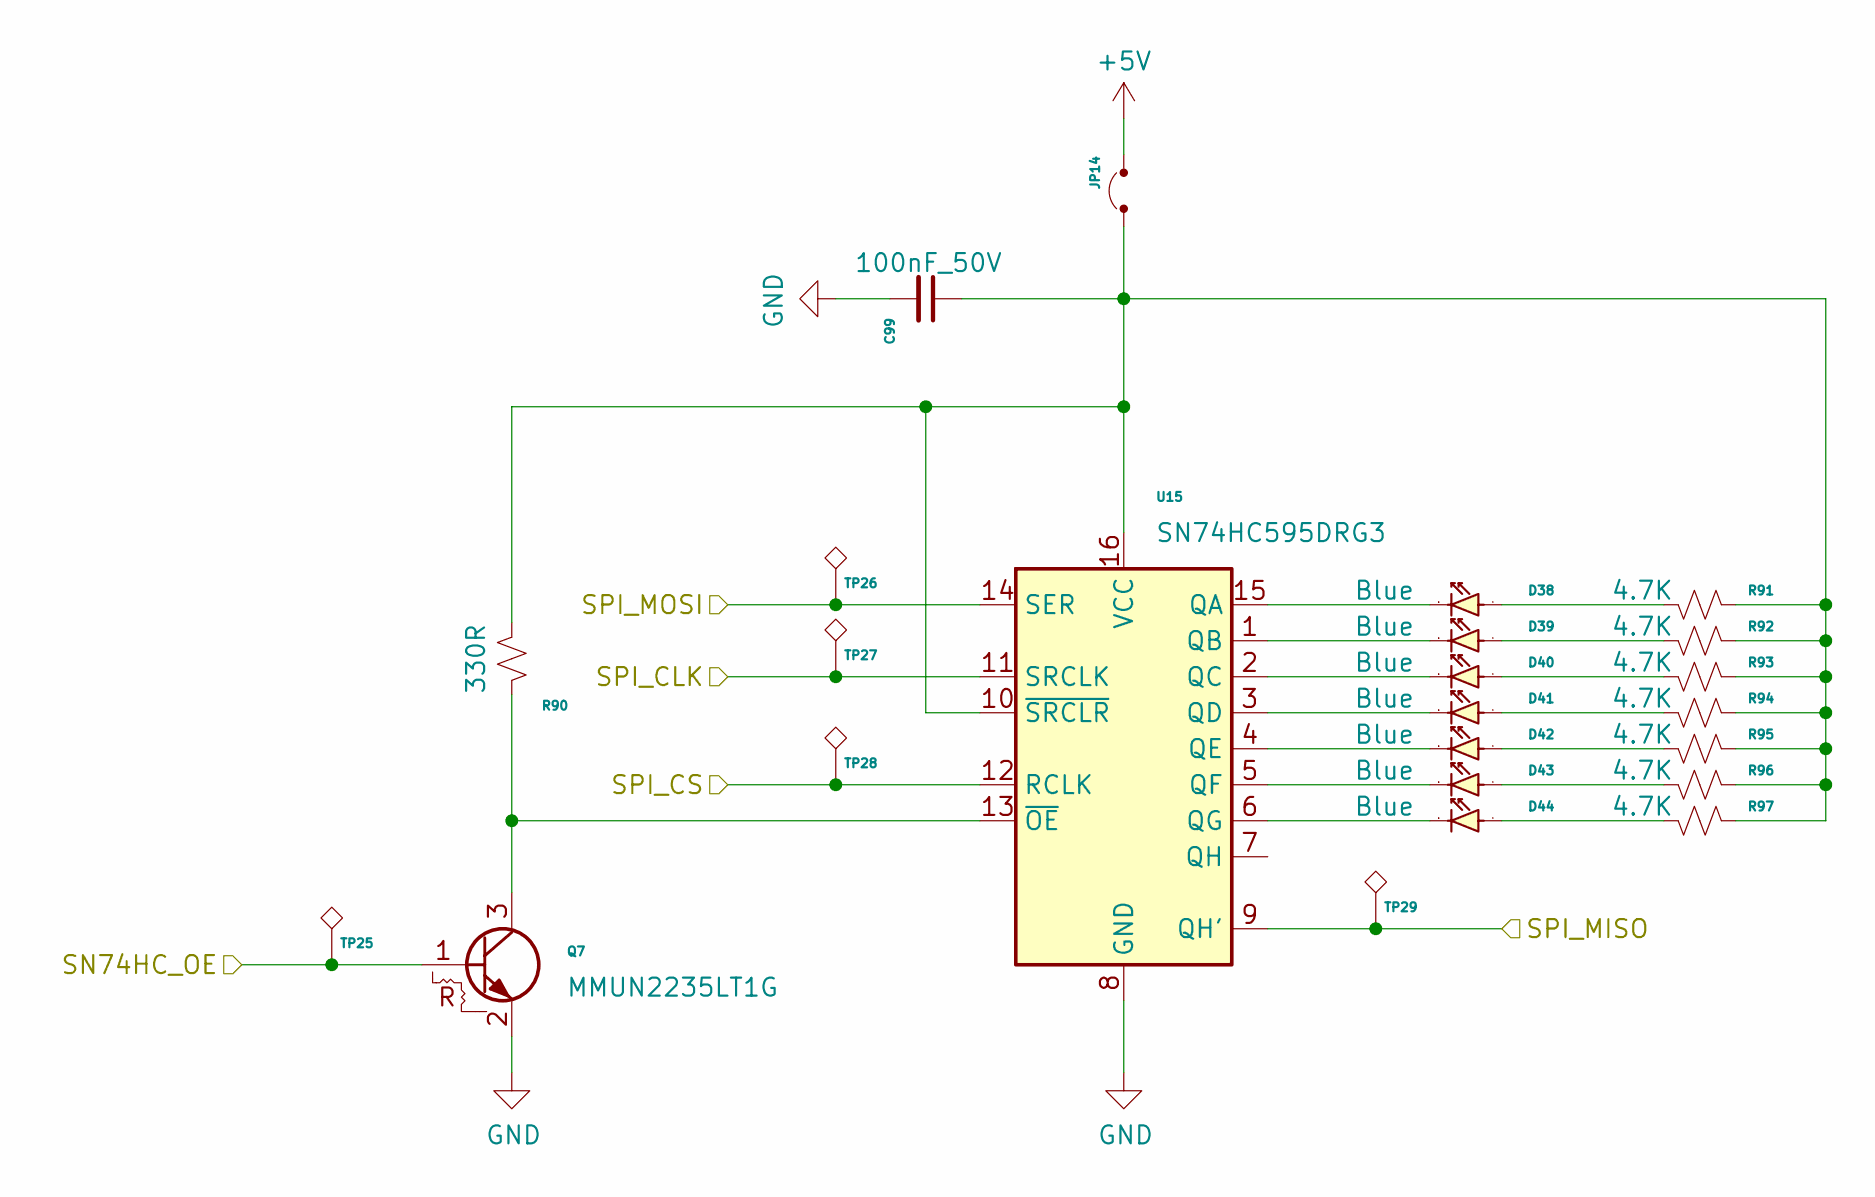
[picture p22: schematic LED_OUT.kicad_sch]

Parts:
C99: 100nF_50V; CAP_0603; MFG P/N *
D38, D39, D40, D41, D42, D43, D44: Blue; LED_0805; MFG P/N *
JP14: Jumper_Pinheader; PinHeader_1x02_P2.54mm_Vertical; MFG P/N *
Q7: MMUN2235LT1G; SOT-23; MFG P/N MMUN2235LT1G
R90: 330R; RES_0603; MFG P/N *
R91, R92, R93, R94, R95, R96, R97: 4.7K; RES_0603; MFG P/N *
TP25, TP26, TP27, TP28, TP29: Test_Point; TEST_POINT
U15: SN74HC595DRG3; SOIC-16_3.9x9.9mm_P1.27mm; MFG P/N SN74HC595DRG3

Connections:
+5V: JP14.2 (B)
GND: C99.2, Q7.2, U15.8 (GND)
unnamed: C99.1, JP14.1 (A), R90.1, R91.2, R92.2, R93.2, R94.2, R95.2, R96.2, R97.2, U15.10 (~SRCLR), U15.16 (VCC)
unnamed: D38.1, U15.15 (QA)
unnamed: D38.2, R91.1
unnamed: D39.1, U15.1 (QB)
unnamed: D39.2, R92.1
unnamed: D40.1, U15.2 (QC)
unnamed: D40.2, R93.1
unnamed: D41.1, U15.3 (QD)
unnamed: D41.2, R94.1
unnamed: D42.1, U15.4 (QE)
unnamed: D42.2, R95.1
unnamed: D43.1, U15.5 (QF)
unnamed: D43.2, R96.1
unnamed: D44.1, U15.6 (QG)
unnamed: D44.2, R97.1
unnamed: Q7.3, R90.2, U15.13 (~OE)
SN74HC_OE: Q7.1, TP25.1
SPI_CLK: TP27.1, U15.11 (SRCLK)
SPI_CS: TP28.1, U15.12 (RCLK)
SPI_MISO: TP29.1, U15.9 (QH')
SPI_MOSI: TP26.1, U15.14 (SER)
