muzaffernizam/STM32-Motor-Control-BLDC-24V/Hardware/STM32_Motor_Kit_v0.1/Potentiometer.kicad_sch

## KiCad design Hardware/STM32_Motor_Kit_v0.1/Potentiometer.kicad_sch (2026-02-23)

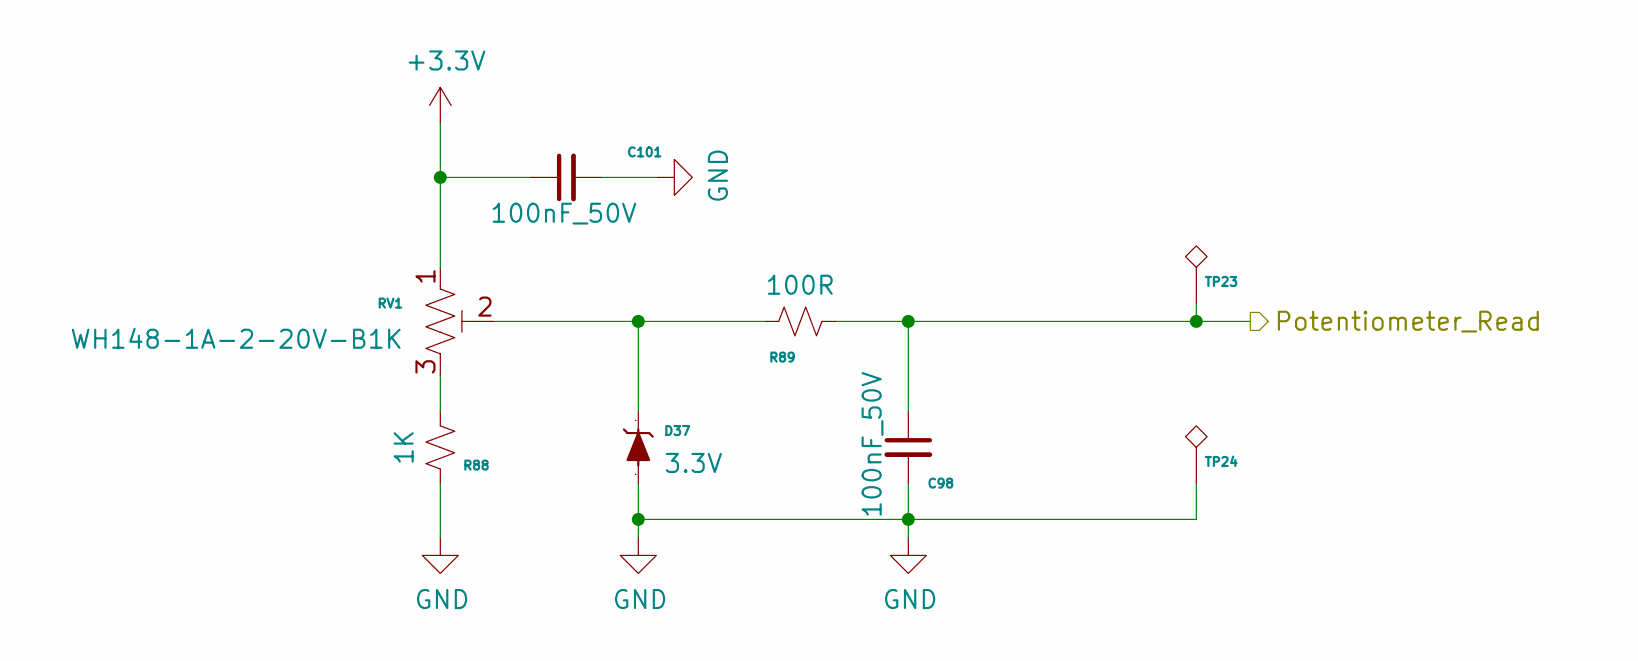
[picture p23: schematic Potentiometer.kicad_sch]

Parts:
C98, C101: 100nF_50V; CAP_0603; MFG P/N *
D37: 3.3V; SOD-123; MFG P/N BZT52-C3V6J
R88: 1K; RES_0603; MFG P/N *
R89: 100R; RES_0603; MFG P/N *
RV1: WH148-1A-2-20V-B1K; Potentiometer_Side_TH_5mmPitch; MFG P/N WH148-1A-2-20V-B1K
TP23, TP24: Test_Point; TEST_POINT

Connections:
+3.3V: C101.1, RV1.1
GND: C98.2, C101.2, D37.2, R88.1, TP24.1
unnamed: D37.1, R89.1, RV1.2
unnamed: R88.2, RV1.3
Potentiometer_Read: C98.1, R89.2, TP23.1
