muzaffernizam/STM32-Motor-Control-BLDC-24V/Hardware/STM32_Motor_Kit_v0.1/Power.kicad_sch

## KiCad design Hardware/STM32_Motor_Kit_v0.1/Power.kicad_sch (2026-02-23)

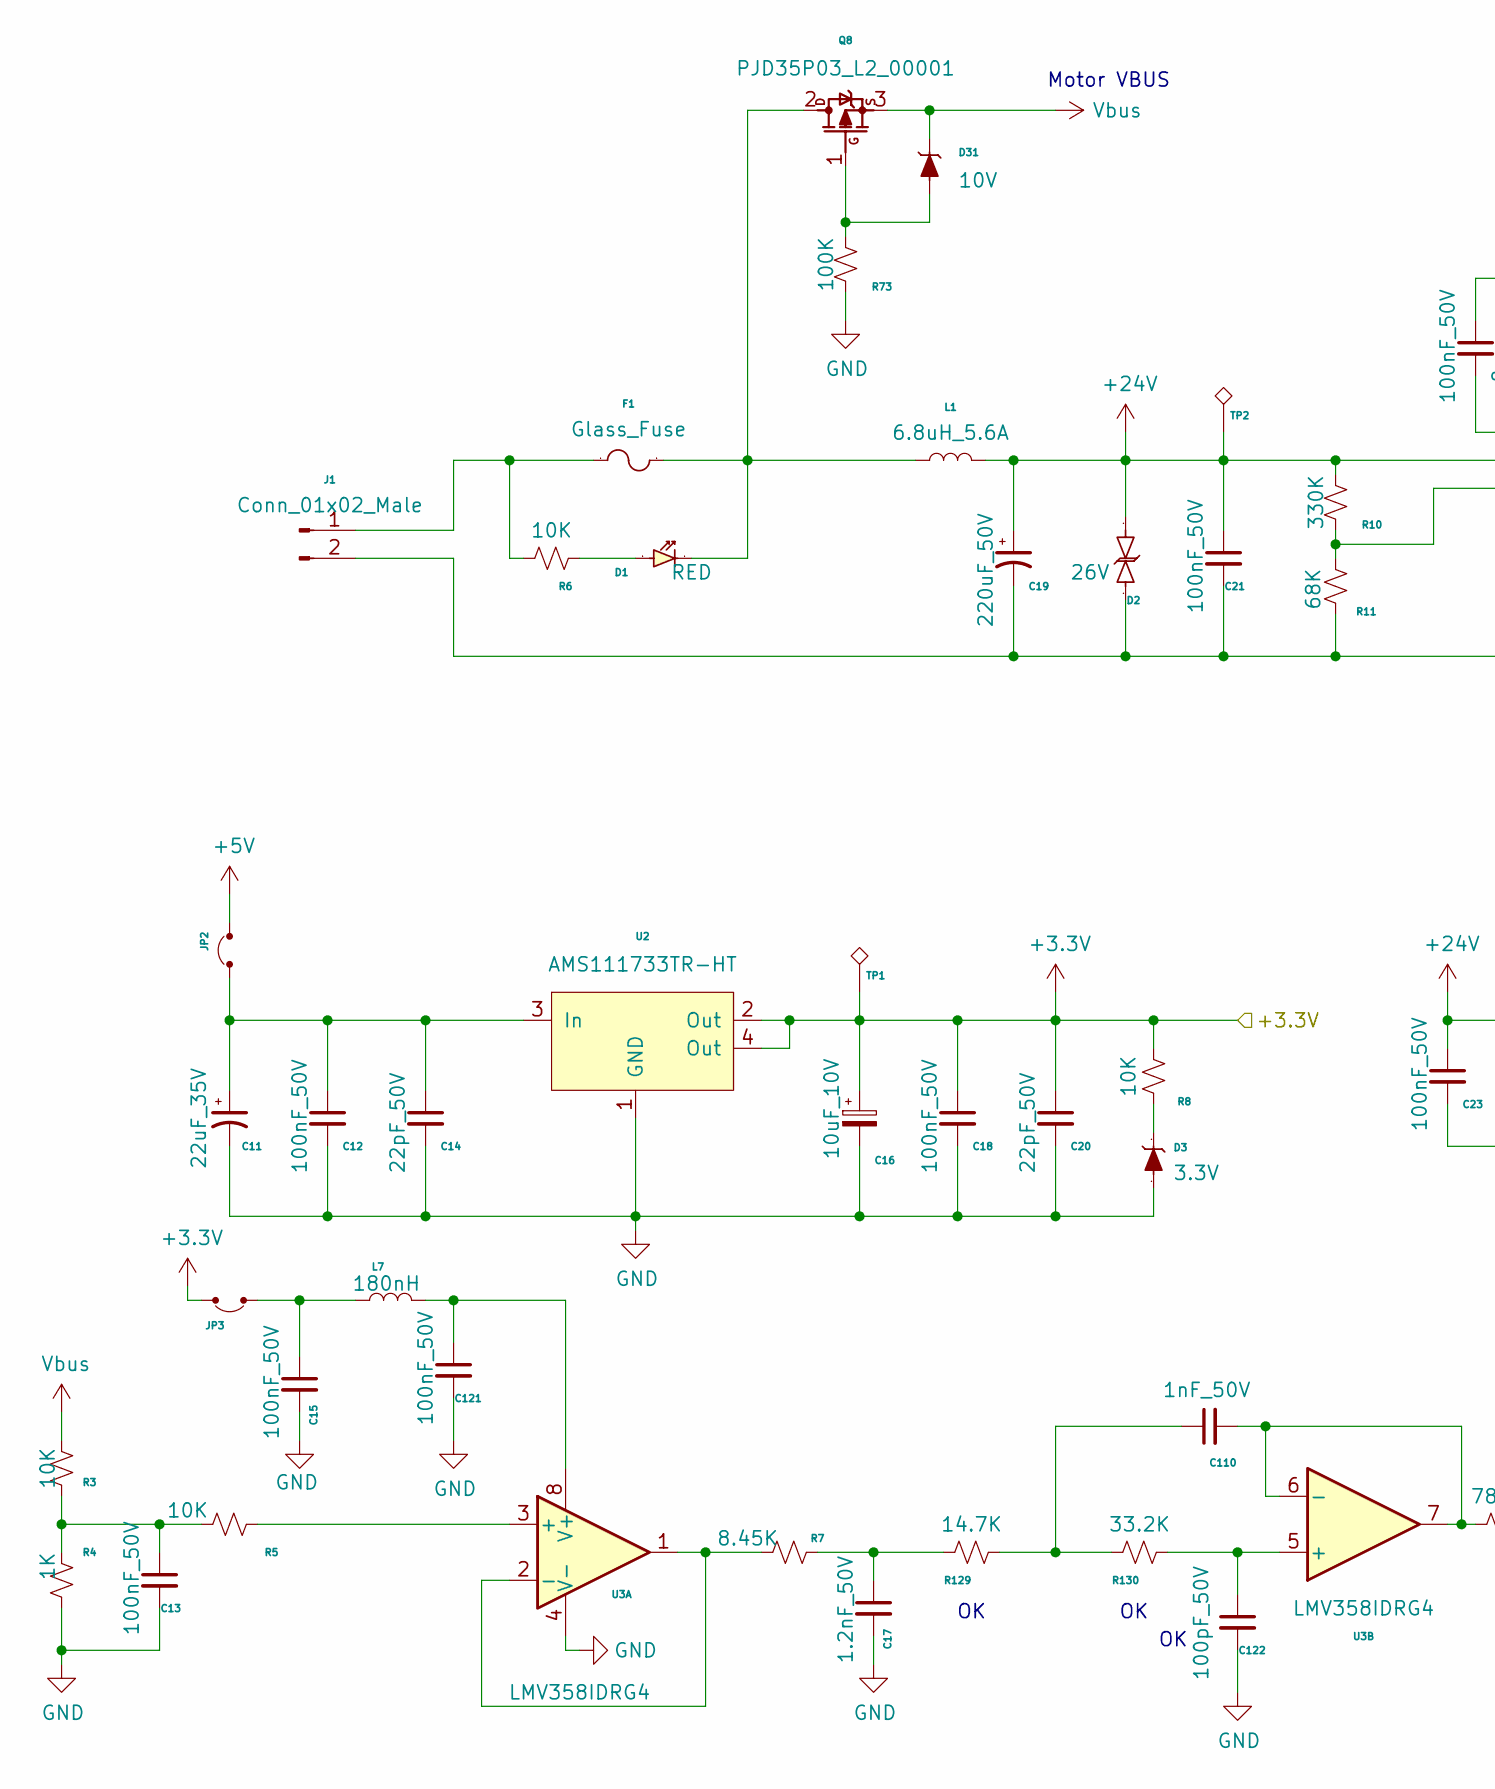
[picture p24: schematic Power.kicad_sch, part in row 1, column 1]

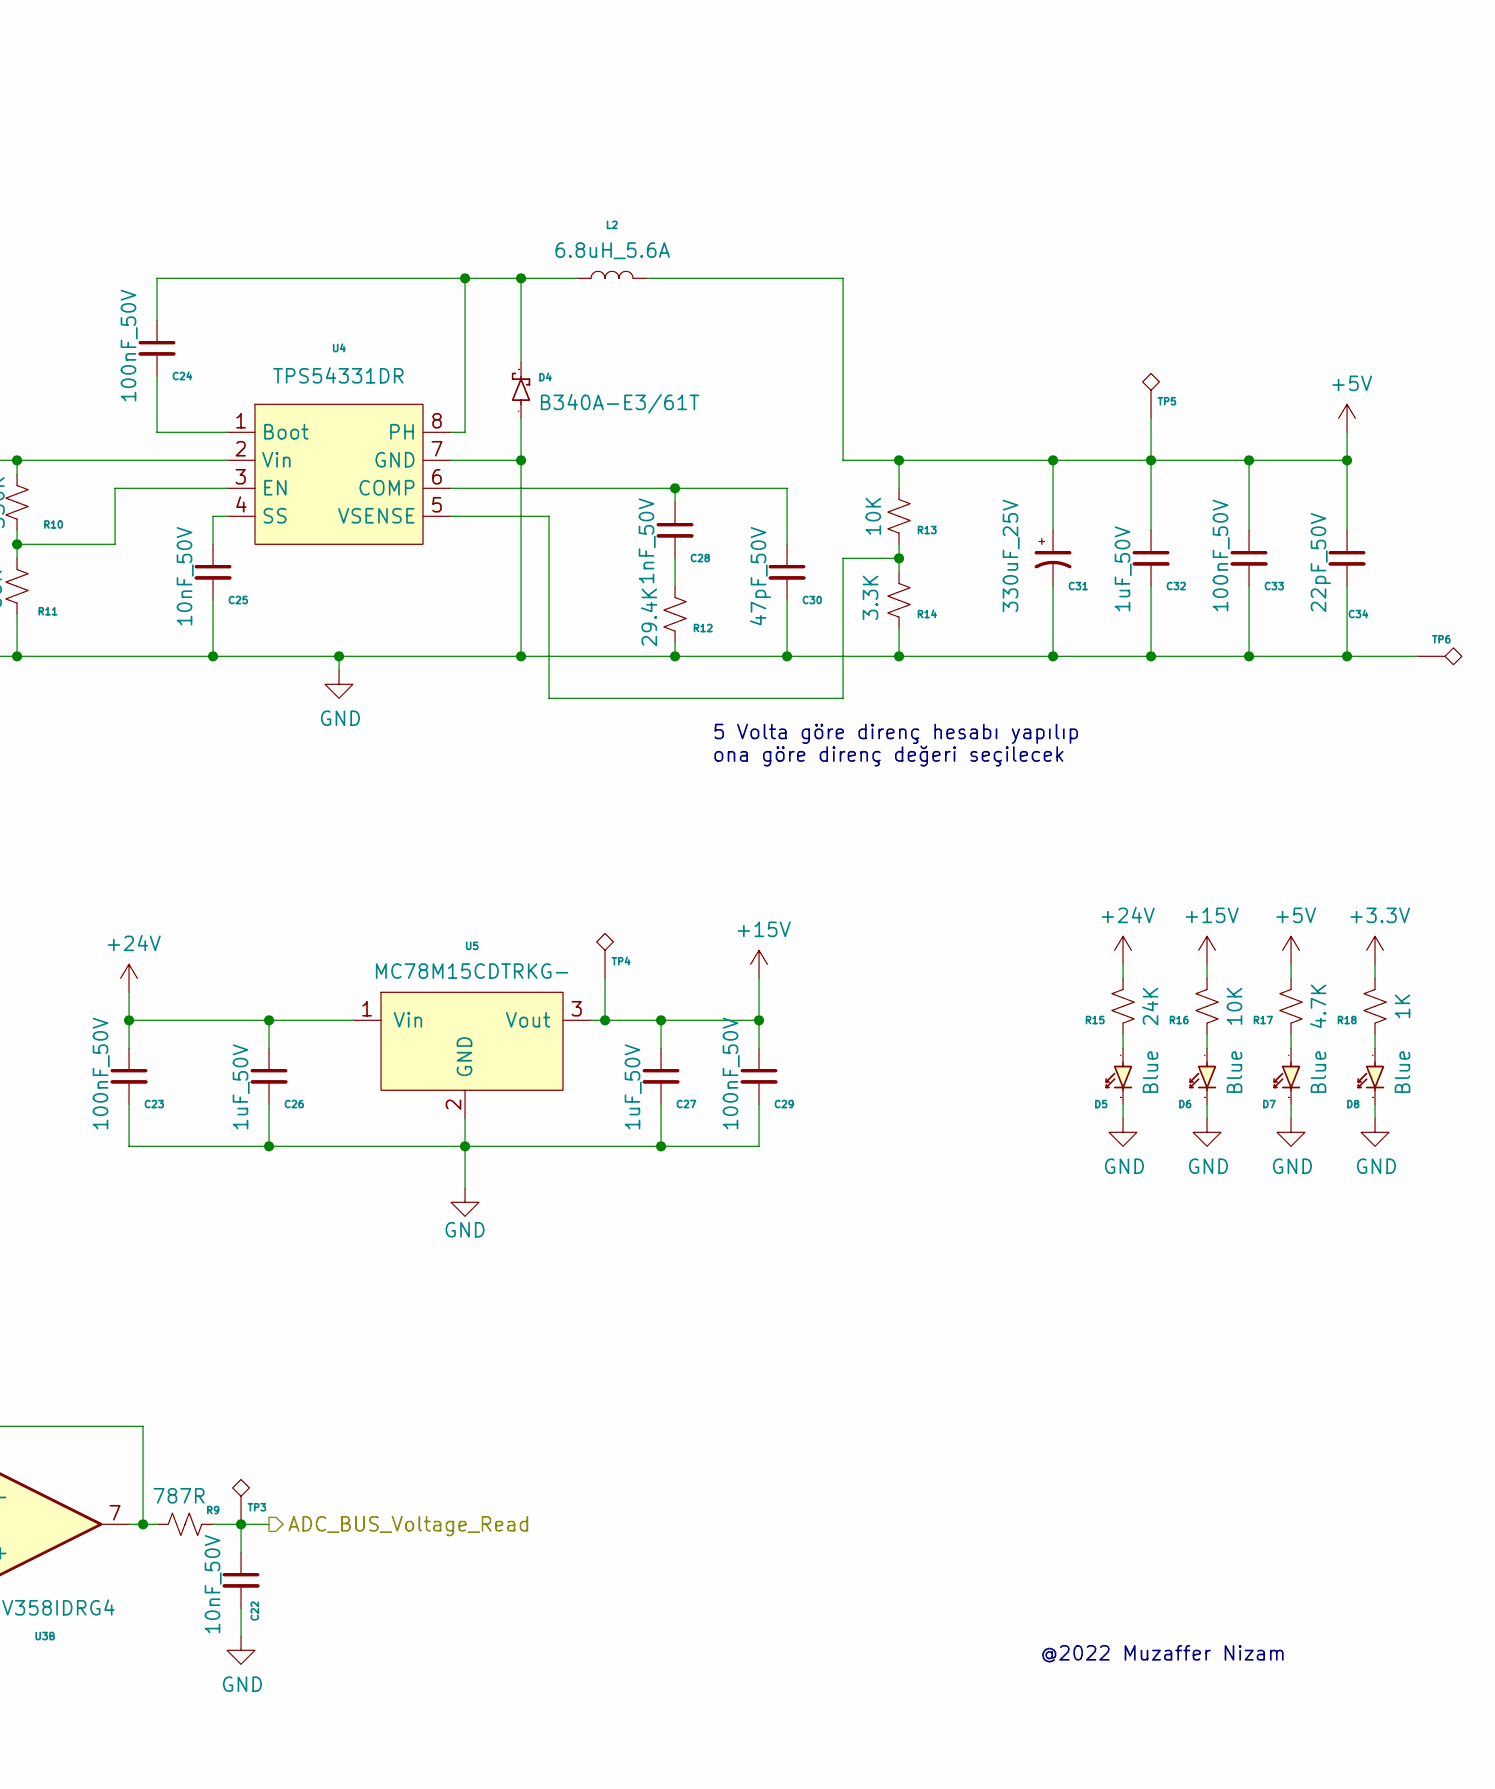
[picture p25: schematic Power.kicad_sch, part in row 1, column 2]

Parts:
C11: 22uF_35V; CP_Radial_D5.0mm_P2.50mm; MFG P/N PKRM-035V220MC110-T2.5
C12, C13, C15, C18, C21, C23, C24, C29, C33, C121: 100nF_50V; CAP_0603; MFG P/N *
C14, C20, C34: 22pF_50V; CAP_0603; MFG P/N *
C16: 10uF_10V; CAP_1206_TANTAL; MFG P/N TAJA106K010RNJ
C17: 1.2nF_50V; CAP_0603; MFG P/N *
C19: 220uF_50V; CP_Radial_D10.0mm_P5.00mm; MFG P/N RS-050V220AX170-T5
C22, C25: 10nF_50V; CAP_0603; MFG P/N *
C26, C27, C32: 1uF_50V; CAP_0603; MFG P/N *
C28, C110: 1nF_50V; CAP_0603; MFG P/N *
C30: 47pF_50V; CAP_0603; MFG P/N *
C31: 330uF_25V; CP_Radial_D8.0mm_P5.00mm; MFG P/N PS-025V330AX120-T5
C122: 100pF_50V; CAP_0603; MFG P/N *
D1: RED; LED_0805; MFG P/N *
D2: 26V; SMC; MFG P/N *
D3: 3.3V; SOD-123; MFG P/N BZT52-C3V6J
D4: B340A-E3/61T; SMA; MFG P/N B340A-E3/61T
D5, D6, D7, D8: Blue; LED_0805; MFG P/N *
D31: 10V; SMA; MFG P/N 3SMAJ5925B
F1: Glass_Fuse; FuseHolder_5X20_TK79_Plastic; MFG P/N 202.707001.06-299
J1: Conn_01x02_Male; TerminalBlock_Phoenix_MKDS-1,5-2_1x02_P5.00mm_Horizontal; MFG P/N L-KLS2-306V-5.00-02P-4C
JP2, JP3: Jumper_Pinheader; PinHeader_1x02_P2.54mm_Vertical; MFG P/N *
L1, L2: 6.8uH_5.6A; SRI1004-6R8M; MFG P/N SRI1004-6R8M
L7: 180nH; IND_0603; MFG P/N HCL1608-R18J-N
Q8: PJD35P03_L2_00001; DPAK_123; MFG P/N PJD35P03_L2_00001
R3: 10K; RES_1206; MFG P/N *
R4, R18: 1K; RES_0603; MFG P/N *
R5, R6, R8, R13, R16: 10K; RES_0603; MFG P/N *
R7: 8.45K; RES_0603; MFG P/N *
R9: 787R; RES_0603; MFG P/N *
R10: 330K; RES_0603; MFG P/N *
R11: 68K; RES_0603; MFG P/N *
R12: 29.4K; RES_0603; MFG P/N *
R14: 3.3K; RES_0603; MFG P/N *
R15: 24K; RES_0603; MFG P/N *
R17: 4.7K; RES_0603; MFG P/N *
R73: 100K; RES_1206; MFG P/N *
R129: 14.7K; RES_0603; MFG P/N *
R130: 33.2K; RES_0603; MFG P/N *
TP1, TP2, TP3, TP4, TP5, TP6: Test_Point; TEST_POINT
U2: AMS111733TR-HT; SOT-223; MFG P/N AMS111733TR-HT
U3: LMV358IDRG4; SOIC-8_3.9x4.9mm_P1.27mm; MFG P/N LMV358IDRG4
U4: TPS54331DR; SOIC-8_3.9x4.9mm_P1.27mm_EP; MFG P/N TPS54331DR
U5: MC78M15CDTRKG-; DPAK_123; MFG P/N MC78M15CDTRKG-

Connections:
+3.3V: C16.1, C18.1, C20.1, JP3.2 (B), R8.2, R18.2, TP1.1, U2.2 (Out), U2.4 (Out)
+5V: C31.1, C32.1, C33.1, C34.1, JP2.2 (B), L2.2, R13.2, R17.2, TP5.1
+15V: C27.1, C29.1, R16.2, TP4.1, U5.3 (Vout)
+24V: C19.1, C21.1, C23.1, C26.1, D2.1, L1.2, R10.2, R15.2, TP2.1, U4.2 (Vin), U5.1 (Vin)
ADC_BUS_Voltage_Read: C22.1, R9.1, TP3.1
GND: C11.2, C12.2, C13.2, C14.2, C15.2, C16.2, C17.2, C18.2, C19.2, C20.2, C21.2, C22.2, C23.2, C25.2, C26.2, C27.2, C29.2, C30.2, C31.2, C32.2, C33.2, C34.2, C121.2, C122.2, D2.2, D3.2, D4.2, D5.1, D6.1, D7.1, D8.1, J1.2, R4.1, R11.1, R12.1, R14.1, R73.1, TP6.1, U2.1 (GND), U3.4 (V-), U4.7 (GND), U4.9 (EXP), U5.2 (GND)
unnamed: C11.1, C12.1, C14.1, JP2.1 (A), U2.3 (In)
unnamed: C13.1, R3.1, R4.2, R5.2
unnamed: C15.1, JP3.1 (A), L7.1
unnamed: C17.1, R7.1, R129.2
unnamed: C24.1, D4.1, L2.1, U4.8 (PH)
unnamed: C24.2, U4.1 (Boot)
unnamed: C25.1, U4.4 (SS)
unnamed: C28.1, C30.1, U4.6 (COMP)
unnamed: C28.2, R12.2
unnamed: C110.1, R129.1, R130.2
unnamed: C110.2, R9.2, U3.6 (-), U3.7
unnamed: C121.1, L7.2, U3.8 (V+)
unnamed: C122.1, R130.1, U3.5 (+)
unnamed: D1.1, F1.2, L1.1, Q8.2 (D)
unnamed: D1.2, R6.2
unnamed: D3.1, R8.1
unnamed: D5.2, R15.1
unnamed: D6.2, R16.1
unnamed: D7.2, R17.1
unnamed: D8.2, R18.1
unnamed: D31.2, Q8.1 (G), R73.2
unnamed: F1.1, J1.1, R6.1
unnamed: R5.1, U3.3 (+)
unnamed: R7.2, U3.1, U3.2 (-)
unnamed: R10.1, R11.2, U4.3 (EN)
unnamed: R13.1, R14.2, U4.5 (VSENSE)
Vbus: D31.1, Q8.3 (S), R3.2

Notes on the sheet:
5 Volta göre direnç hesabı yapılıp ona göre direnç değeri seçilecek
Motor VBUS
@2022 Muzaffer Nizam
