muzaffernizam/STM32-Motor-Control-BLDC-24V/Hardware/STM32_Motor_Kit_v0.1/Programming_and_Uart.kicad_sch

## KiCad design Hardware/STM32_Motor_Kit_v0.1/Programming_and_Uart.kicad_sch (2026-02-23)

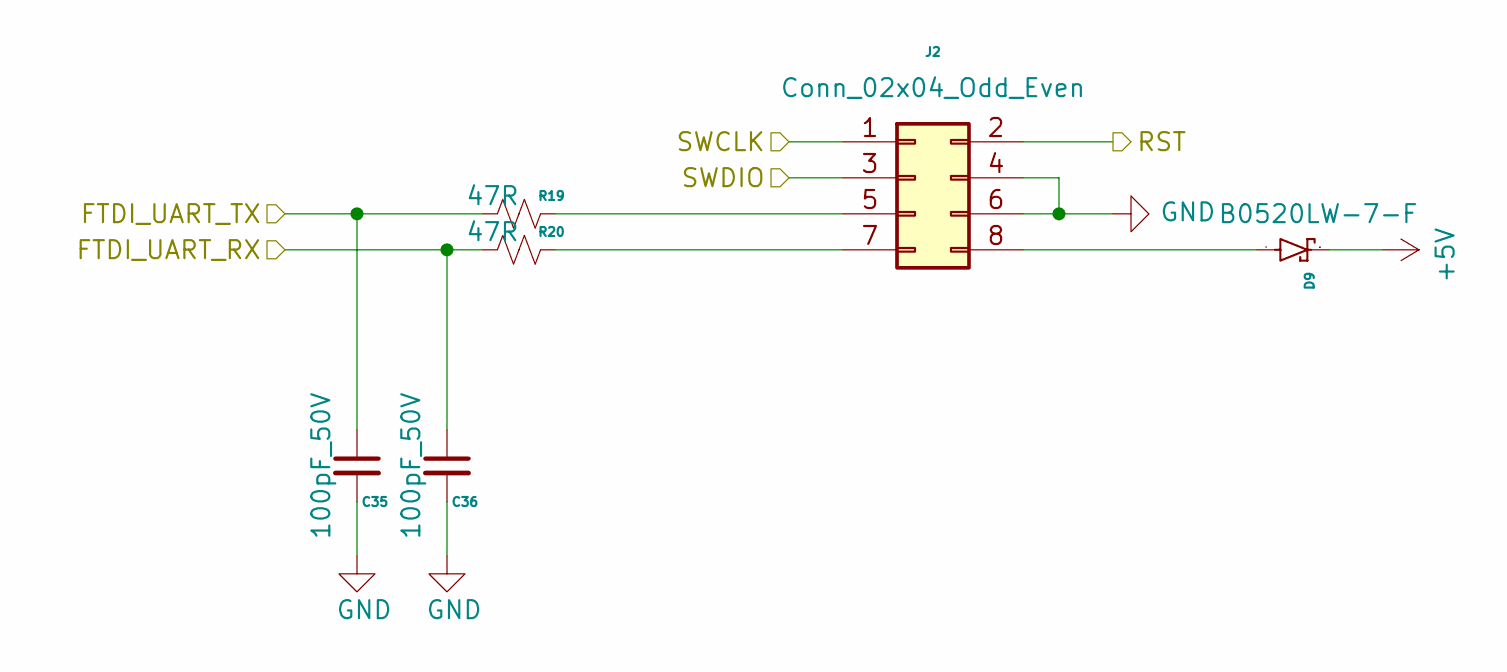
[picture p26: schematic Programming_and_Uart.kicad_sch]

Parts:
C35, C36: 100pF_50V; CAP_0603; MFG P/N *
D9: B0520LW-7-F; SOD-123; MFG P/N B0520LW-7-F
J2: Conn_02x04_Odd_Even; PinHeader_2x04_P2.54mm_Vertical
R19, R20: 47R; RES_0603; MFG P/N *

Connections:
+5V: D9.1
FTDI_UART_RX: C36.1, R20.2
FTDI_UART_TX: C35.1, R19.2
GND: C35.2, C36.2, J2.4, J2.6
unnamed: D9.2, J2.8
unnamed: J2.5, R19.1
unnamed: J2.7, R20.1
RST: J2.2
SWCLK: J2.1
SWDIO: J2.3
