muzaffernizam/STM32-Motor-Control-BLDC-24V/Hardware/STM32_Motor_Kit_v0.1/RS485_Communication.kicad_sch

## KiCad design Hardware/STM32_Motor_Kit_v0.1/RS485_Communication.kicad_sch (2026-02-23)

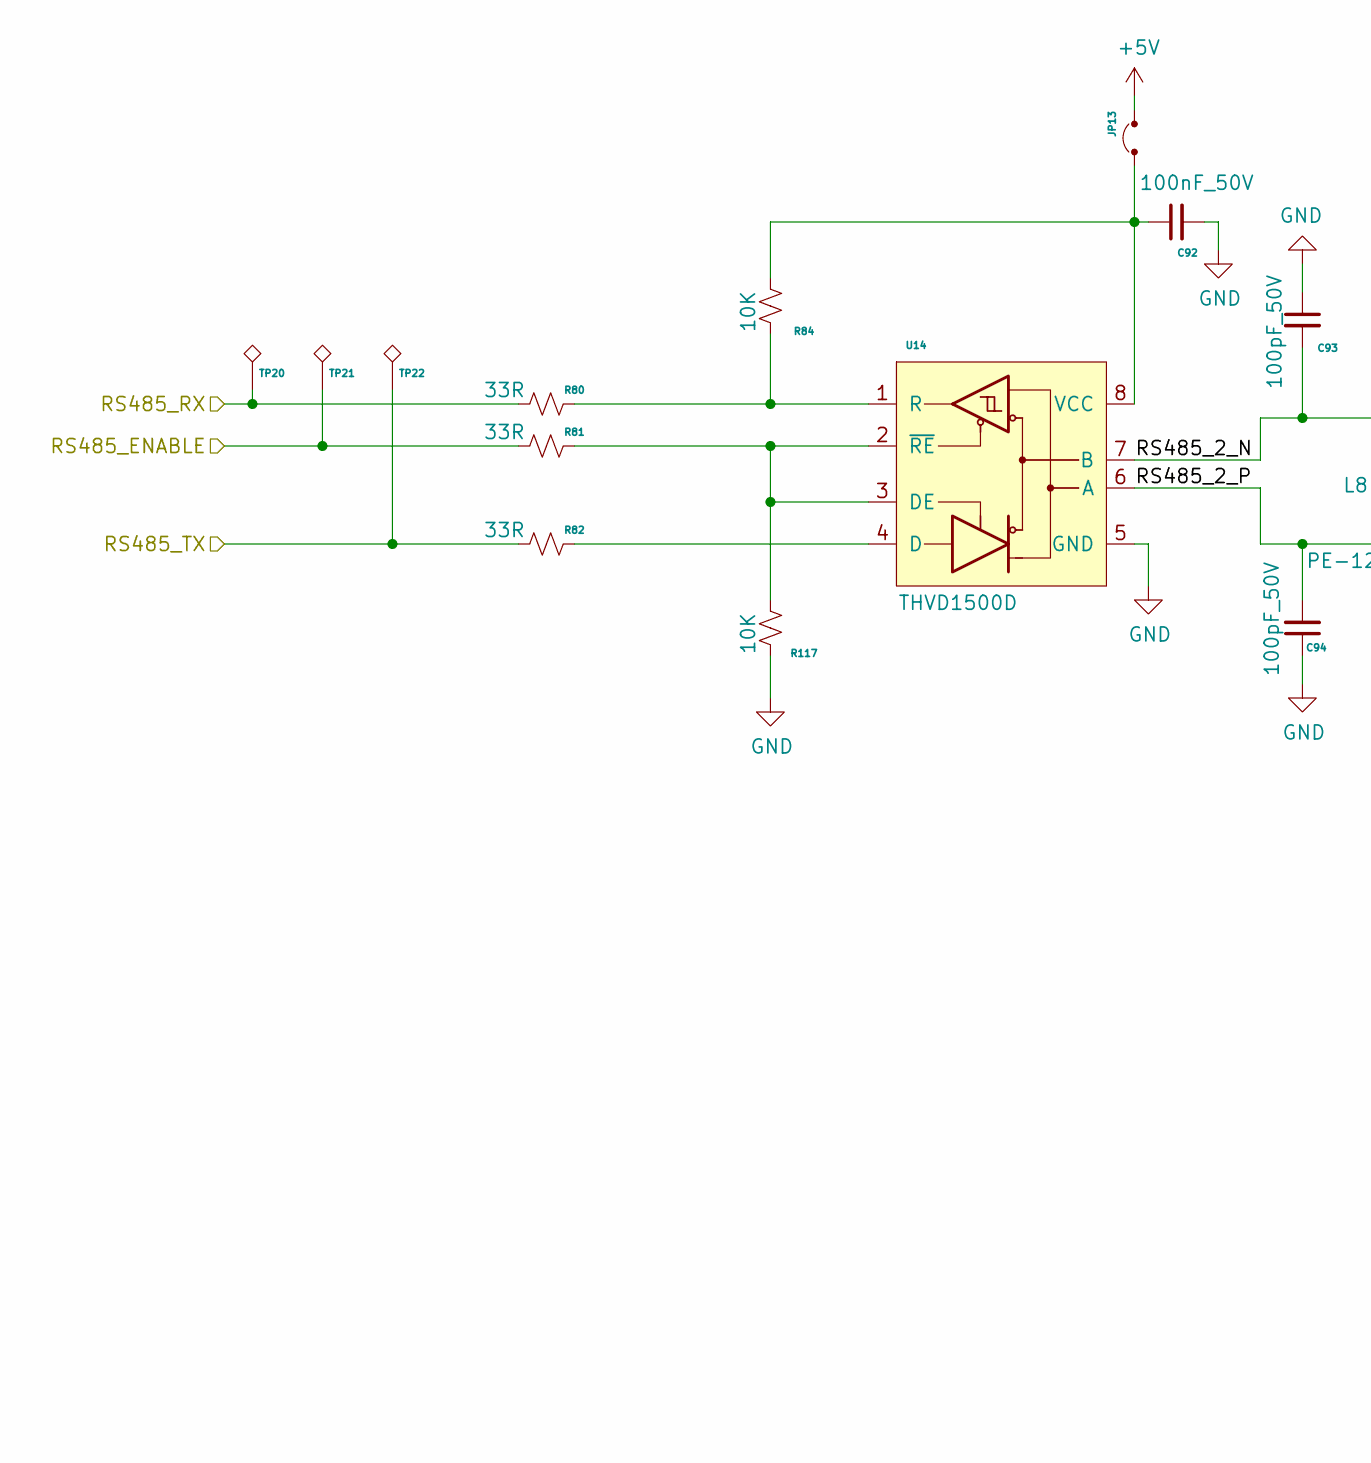
[picture p27: schematic RS485_Communication.kicad_sch, part in row 1, column 1]

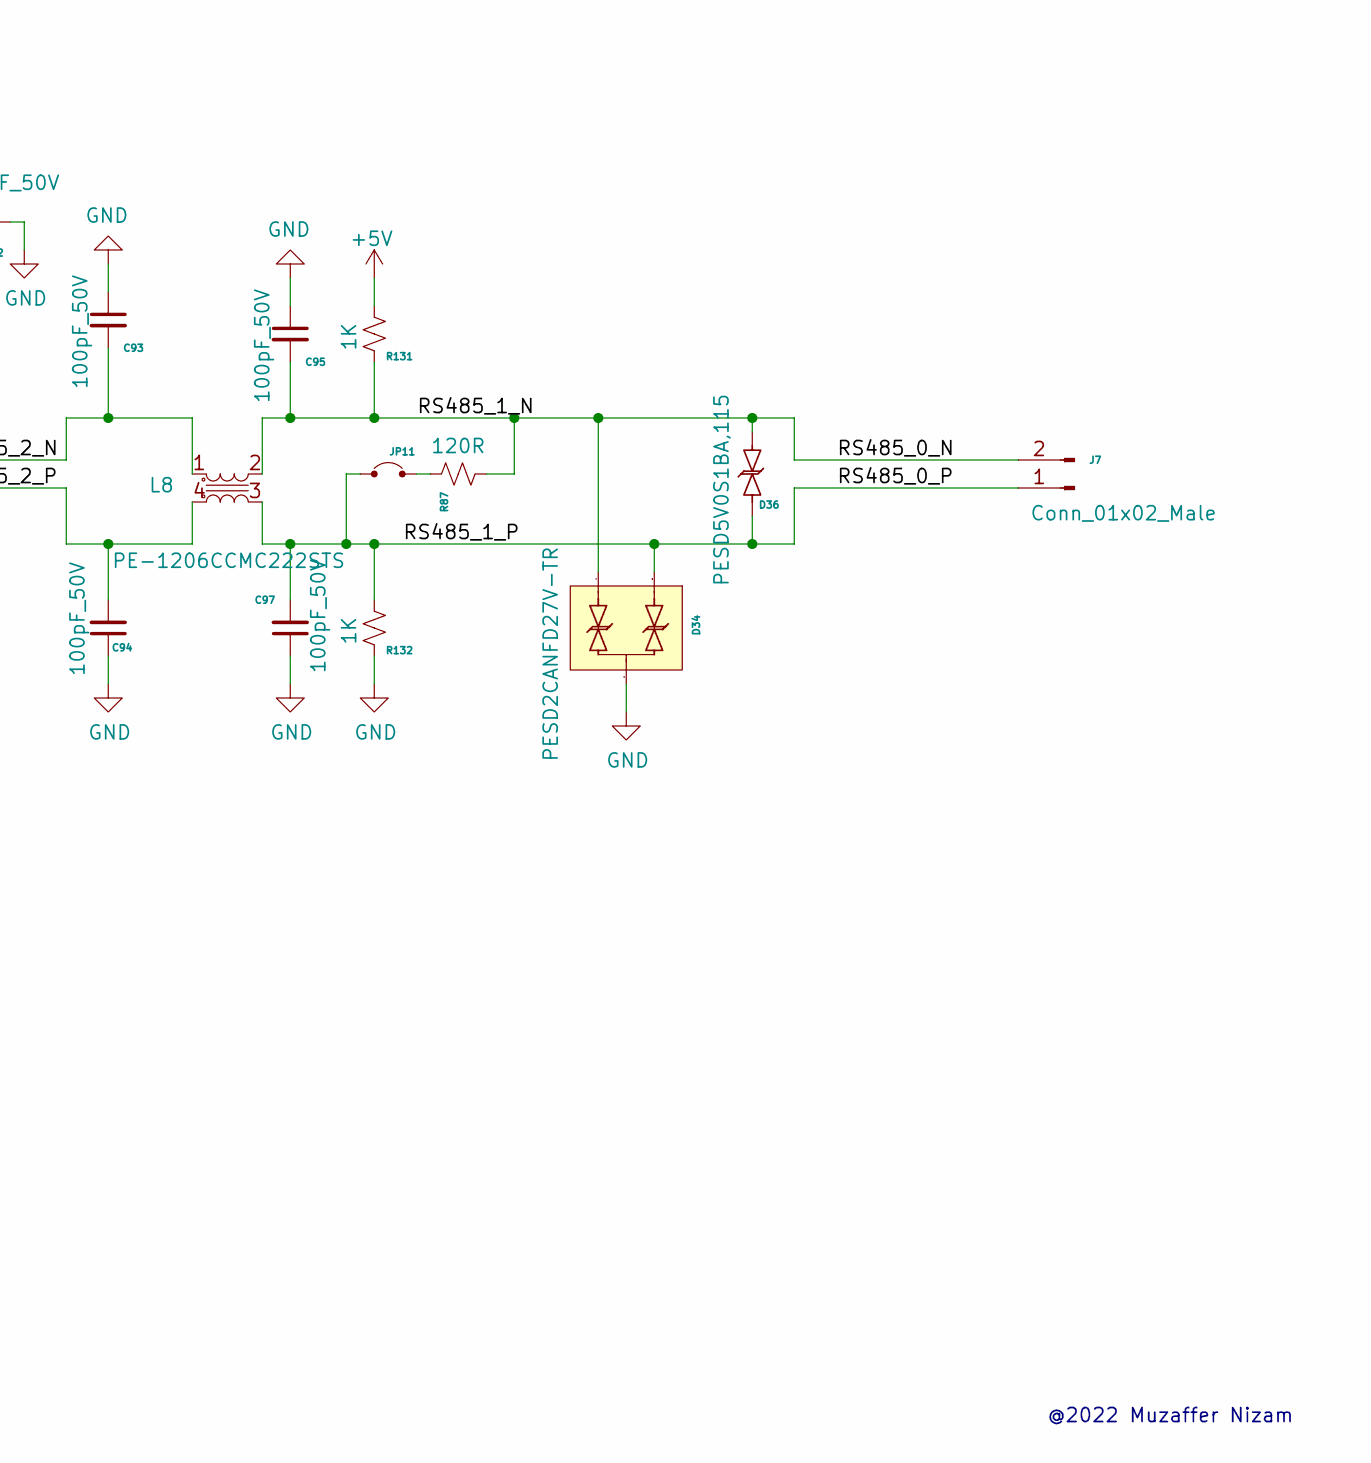
[picture p28: schematic RS485_Communication.kicad_sch, part in row 1, column 2]

Parts:
C92: 100nF_50V; CAP_0603; MFG P/N *
C93, C94, C95, C97: 100pF_50V; CAP_0603; MFG P/N *
D34: PESD2CANFD27V-TR; SOT-23; MFG P/N PESD2CANFD27V-TR
D36: PESD5V0S1BA,115; SOD-323; MFG P/N *
J7: Conn_01x02_Male; TerminalBlock_Phoenix_MKDS-1,5-2_1x02_P5.00mm_Horizontal; MFG P/N L-KLS2-306V-5.00-02P-4C
JP11, JP13: Jumper_Pinheader; PinHeader_1x02_P2.54mm_Vertical; MFG P/N *
L8: PE-1206CCMC222STS; CMC_1206_4_LEAD; MFG P/N PE-1206CCMC222STS
R80, R81, R82: 33R; RES_0603; MFG P/N *
R84, R117: 10K; RES_0603; MFG P/N *
R87: 120R; RES_1206; MFG P/N *
R131, R132: 1K; RES_0603; MFG P/N *
TP20, TP21, TP22: Test_Point; TEST_POINT
U14: THVD1500D; SOIC-8_3.9x4.9mm_P1.27mm; MFG P/N THVD1500D

Connections:
+5V: JP13.2 (B), R131.2
GND: C92.2, C93.1, C94.1, C95.1, C97.1, D34.3, R117.1, R132.1, U14.5 (GND)
unnamed: C92.1, JP13.1 (A), R84.2, U14.8 (VCC)
unnamed: JP11.2 (B), R87.1
unnamed: R80.1, R84.1, U14.1 (R)
unnamed: R82.1, U14.4 (D)
unnamed: R81.1, R117.2, U14.2 (~RE), U14.3 (DE)
RS485_0_N: C95.2, D34.2, D36.2, J7.2, L8.2, R87.2, R131.1
RS485_0_P: C97.2, D34.1, D36.1, J7.1, JP11.1 (A), L8.3, R132.2
RS485_2_N: C93.2, L8.1, U14.7 (B)
RS485_2_P: C94.2, L8.4, U14.6 (A)
RS485_ENABLE: R81.2, TP21.1
RS485_RX: R80.2, TP20.1
RS485_TX: R82.2, TP22.1

Notes on the sheet:
@2022 Muzaffer Nizam
