muzaffernizam/STM32-Motor-Control-BLDC-24V/Hardware/STM32_Motor_Kit_v0.1/RS485_Communication_2.kicad_sch

## KiCad design Hardware/STM32_Motor_Kit_v0.1/RS485_Communication_2.kicad_sch (2026-02-23)

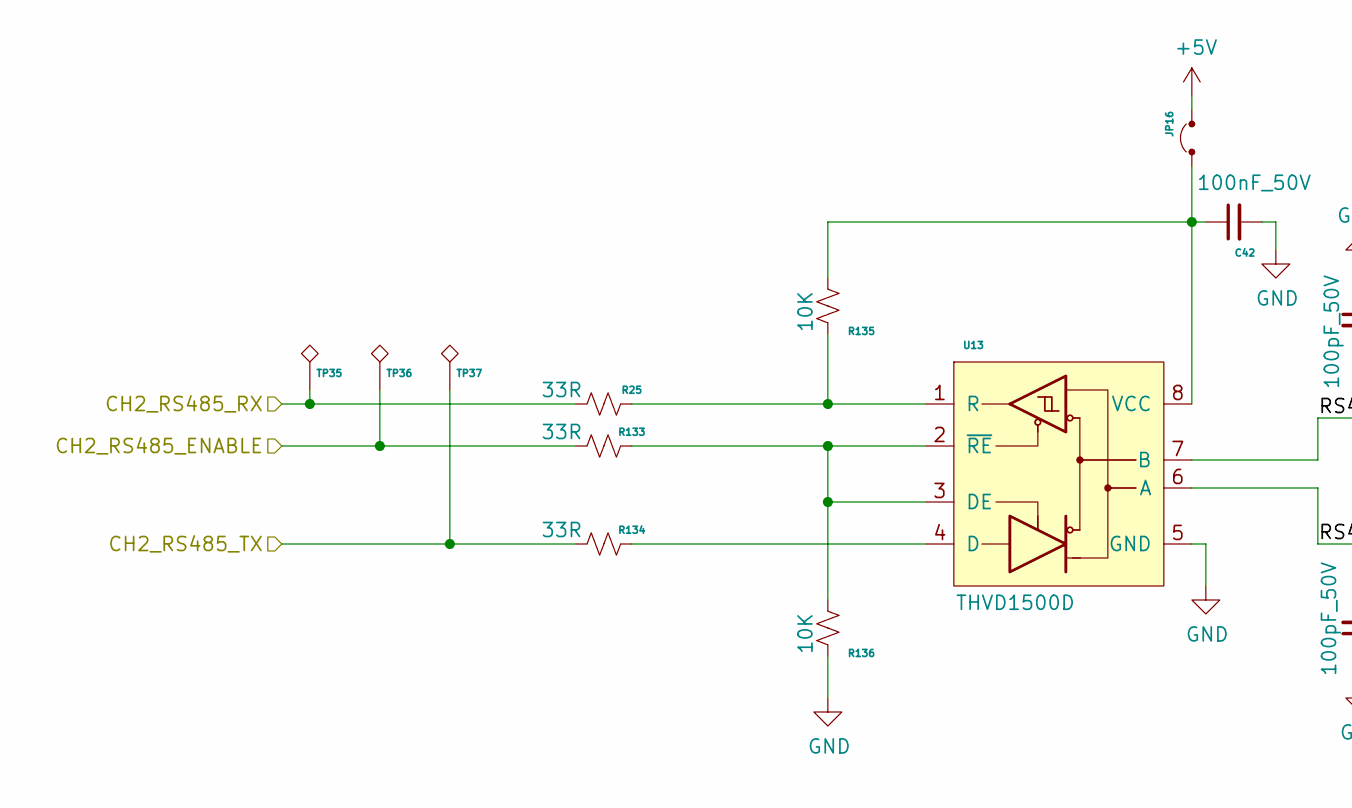
[picture p29: schematic RS485_Communication_2.kicad_sch, part in row 1, column 1]

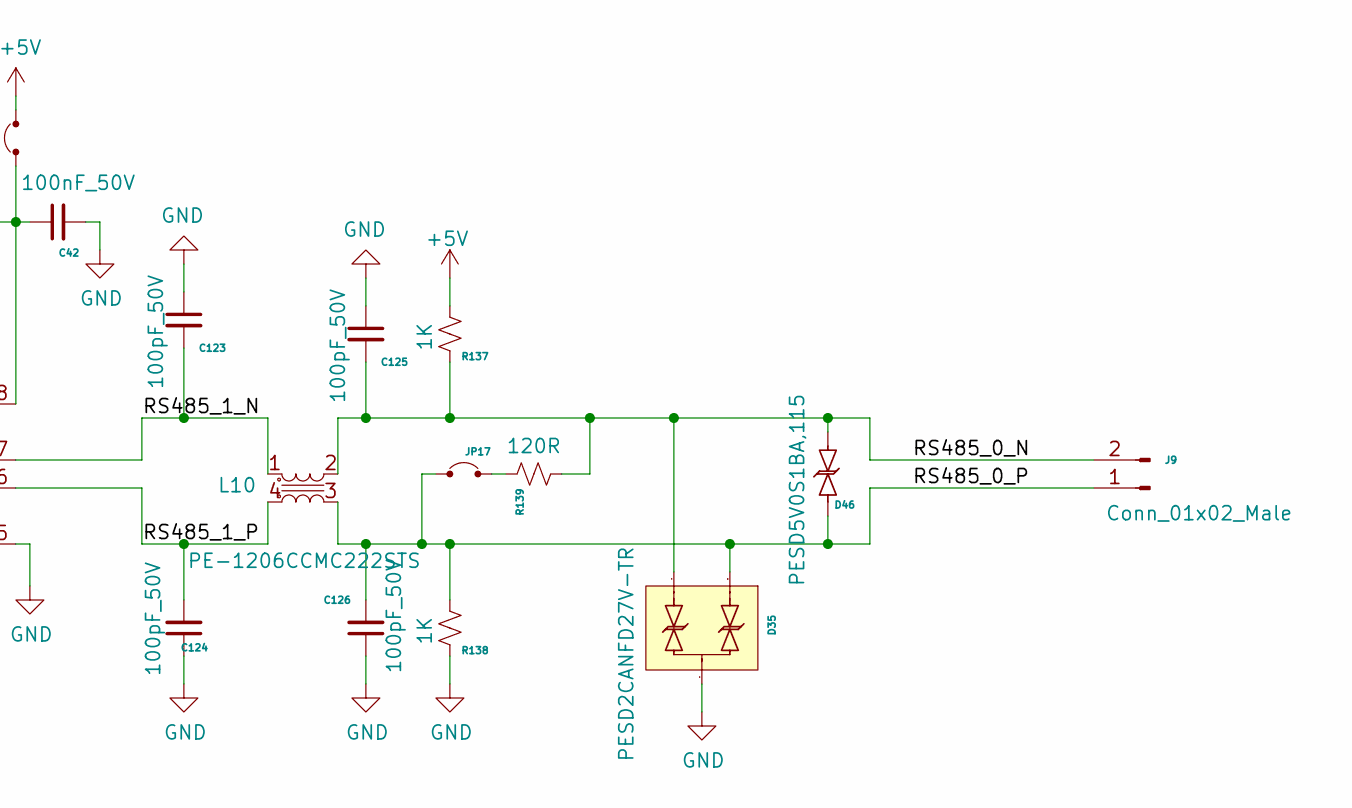
[picture p30: schematic RS485_Communication_2.kicad_sch, part in row 1, column 2]

Parts:
C42: 100nF_50V; CAP_0603; MFG P/N *
C123, C124, C125, C126: 100pF_50V; CAP_0603; MFG P/N *
D35: PESD2CANFD27V-TR; SOT-23; MFG P/N PESD2CANFD27V-TR
D46: PESD5V0S1BA,115; SOD-323; MFG P/N *
J9: Conn_01x02_Male; TerminalBlock_Phoenix_MKDS-1,5-2_1x02_P5.00mm_Horizontal; MFG P/N L-KLS2-306V-5.00-02P-4C
JP16, JP17: Jumper_Pinheader; PinHeader_1x02_P2.54mm_Vertical; MFG P/N *
L10: PE-1206CCMC222STS; CMC_1206_4_LEAD; MFG P/N PE-1206CCMC222STS
R25, R133, R134: 33R; RES_0603; MFG P/N *
R135, R136: 10K; RES_0603; MFG P/N *
R137, R138: 1K; RES_0603; MFG P/N *
R139: 120R; RES_1206; MFG P/N *
TP35, TP36, TP37: Test_Point; TEST_POINT
U13: THVD1500D; SOIC-8_3.9x4.9mm_P1.27mm; MFG P/N THVD1500D

Connections:
+5V: JP16.2 (B), R137.2
CH2_RS485_ENABLE: R133.2, TP36.1
CH2_RS485_RX: R25.2, TP35.1
CH2_RS485_TX: R134.2, TP37.1
GND: C42.2, C123.1, C124.1, C125.1, C126.1, D35.3, R136.1, R138.1, U13.5 (GND)
unnamed: C42.1, JP16.1 (A), R135.2, U13.8 (VCC)
unnamed: JP17.2 (B), R139.1
unnamed: R133.1, R136.2, U13.2 (~RE), U13.3 (DE)
unnamed: R134.1, U13.4 (D)
unnamed: R25.1, R135.1, U13.1 (R)
RS485_0_N: C125.2, D35.2, D46.2, J9.2, L10.2, R137.1, R139.2
RS485_0_P: C126.2, D35.1, D46.1, J9.1, JP17.1 (A), L10.3, R138.2
RS485_1_N: C123.2, L10.1, U13.7 (B)
RS485_1_P: C124.2, L10.4, U13.6 (A)
