muzaffernizam/STM32-Motor-Control-BLDC-24V/Hardware/STM32_Motor_Kit_v0.1/Relay_Output.kicad_sch

## KiCad design Hardware/STM32_Motor_Kit_v0.1/Relay_Output.kicad_sch (2024-07-18)

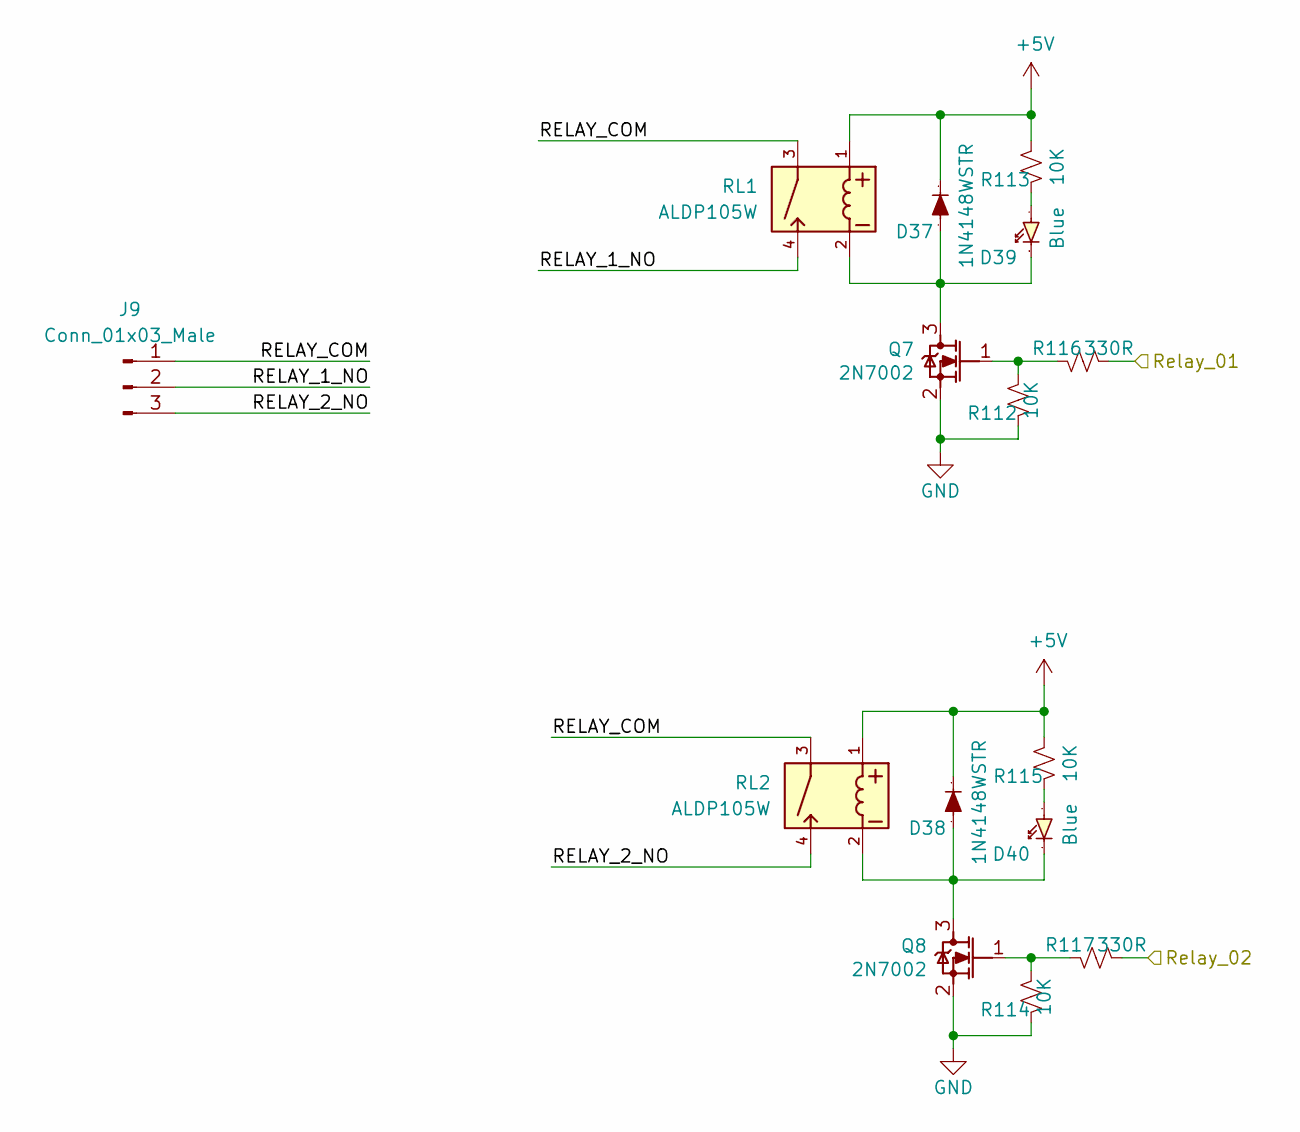
[picture p31: schematic Relay_Output.kicad_sch]

Parts:
D37, D38: 1N4148WSTR; SOD-323; MFG P/N 1N4148WSTR
D39, D40: Blue; LED_0805; MFG P/N *
J9: Conn_01x03_Male; PhoenixContact_MC_1,5_3-G-3.81_1x03_P3.81mm_Horizontal
Q7, Q8: 2N7002; SOT-23; MFG P/N 2N7002
R112, R113, R114, R115: 10K; RES_0603; MFG P/N *
R116, R117: 330R; RES_0603; MFG P/N *
RL1, RL2: ALDP105W; Relay_1P1T_NO_7x20x14.9mm_Panasonic_ALDP; MFG P/N ALDP105W

Connections:
+5V: D37.1, D38.1, R113.2, R115.2, RL1.1, RL2.1
GND: Q7.2, Q8.2, R112.1, R114.1
unnamed: D37.2, D39.1, Q7.3, RL1.2
unnamed: D38.2, D40.1, Q8.3, RL2.2
unnamed: D39.2, R113.1
unnamed: D40.2, R115.1
unnamed: Q7.1, R112.2, R116.1
unnamed: Q8.1, R114.2, R117.1
RELAY_1_NO: J9.2, RL1.4
RELAY_2_NO: J9.3, RL2.4
RELAY_COM: J9.1, RL1.3, RL2.3
Relay_01: R116.2
Relay_02: R117.2
