muzaffernizam/STM32-Motor-Control-BLDC-24V/Hardware/STM32_Motor_Kit_v0.1/SD_Card.kicad_sch

## KiCad design Hardware/STM32_Motor_Kit_v0.1/SD_Card.kicad_sch (2024-07-18)

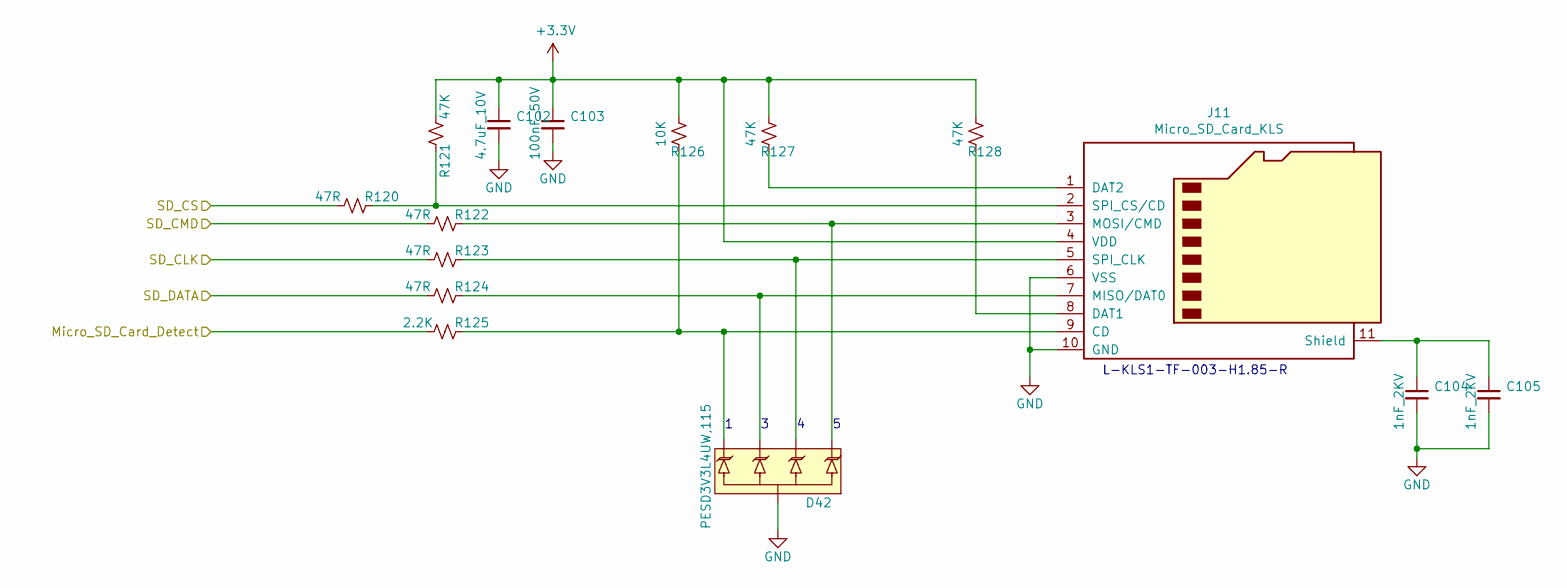
[picture p32: schematic SD_Card.kicad_sch]

Parts:
C102: 4.7uF_10V; CAP_0603; MFG P/N *
C103: 100nF_50V; CAP_0603; MFG P/N *
C104, C105: 1nF_2KV; CAP_1206; MFG P/N *
D42: PESD3V3L4UW,115; SOT-665; MFG P/N PESD3V3L4UW,115
J11: Micro_SD_Card_KLS; Micro_SD_Card_Socket_KLS; MFG P/N L-KLS1-TF-003-H1.85-R
R120, R122, R123, R124: 47R; RES_0603; MFG P/N *
R121, R127, R128: 47K; RES_0603; MFG P/N *
R125: 2.2K; RES_0603; MFG P/N *
R126: 10K; RES_0603; MFG P/N *

Connections:
+3.3V: C102.1, C103.1, J11.4 (VDD), R121.2, R126.1, R127.1, R128.1
GND: C102.2, C103.2, C104.2, C105.2, D42.2, J11.6 (VSS), J11.10 (GND)
Micro_SD_Card_Detect: R125.2
unnamed: C104.1, C105.1, J11.11 (Shield)
unnamed: D42.1, J11.9 (CD), R125.1, R126.2
unnamed: D42.3, J11.7 (MISO/DAT0), R124.1
unnamed: D42.4, J11.5 (SPI_CLK), R123.1
unnamed: D42.5, J11.3 (MOSI/CMD), R122.1
unnamed: J11.1 (DAT2), R127.2
unnamed: J11.2 (SPI_CS/CD), R120.1, R121.1
unnamed: J11.8 (DAT1), R128.2
SD_CLK: R123.2
SD_CMD: R122.2
SD_CS: R120.2
SD_DATA: R124.2

Notes on the sheet:
L-KLS1-TF-003-H1.85-R
