muzaffernizam/STM32-Motor-Control-BLDC-24V/Hardware/STM32_Motor_Kit_v0.1/STM32_Motor_Kit_v0.1.kicad_sch

## KiCad design Hardware/STM32_Motor_Kit_v0.1/STM32_Motor_Kit_v0.1.kicad_sch (2026-02-23)

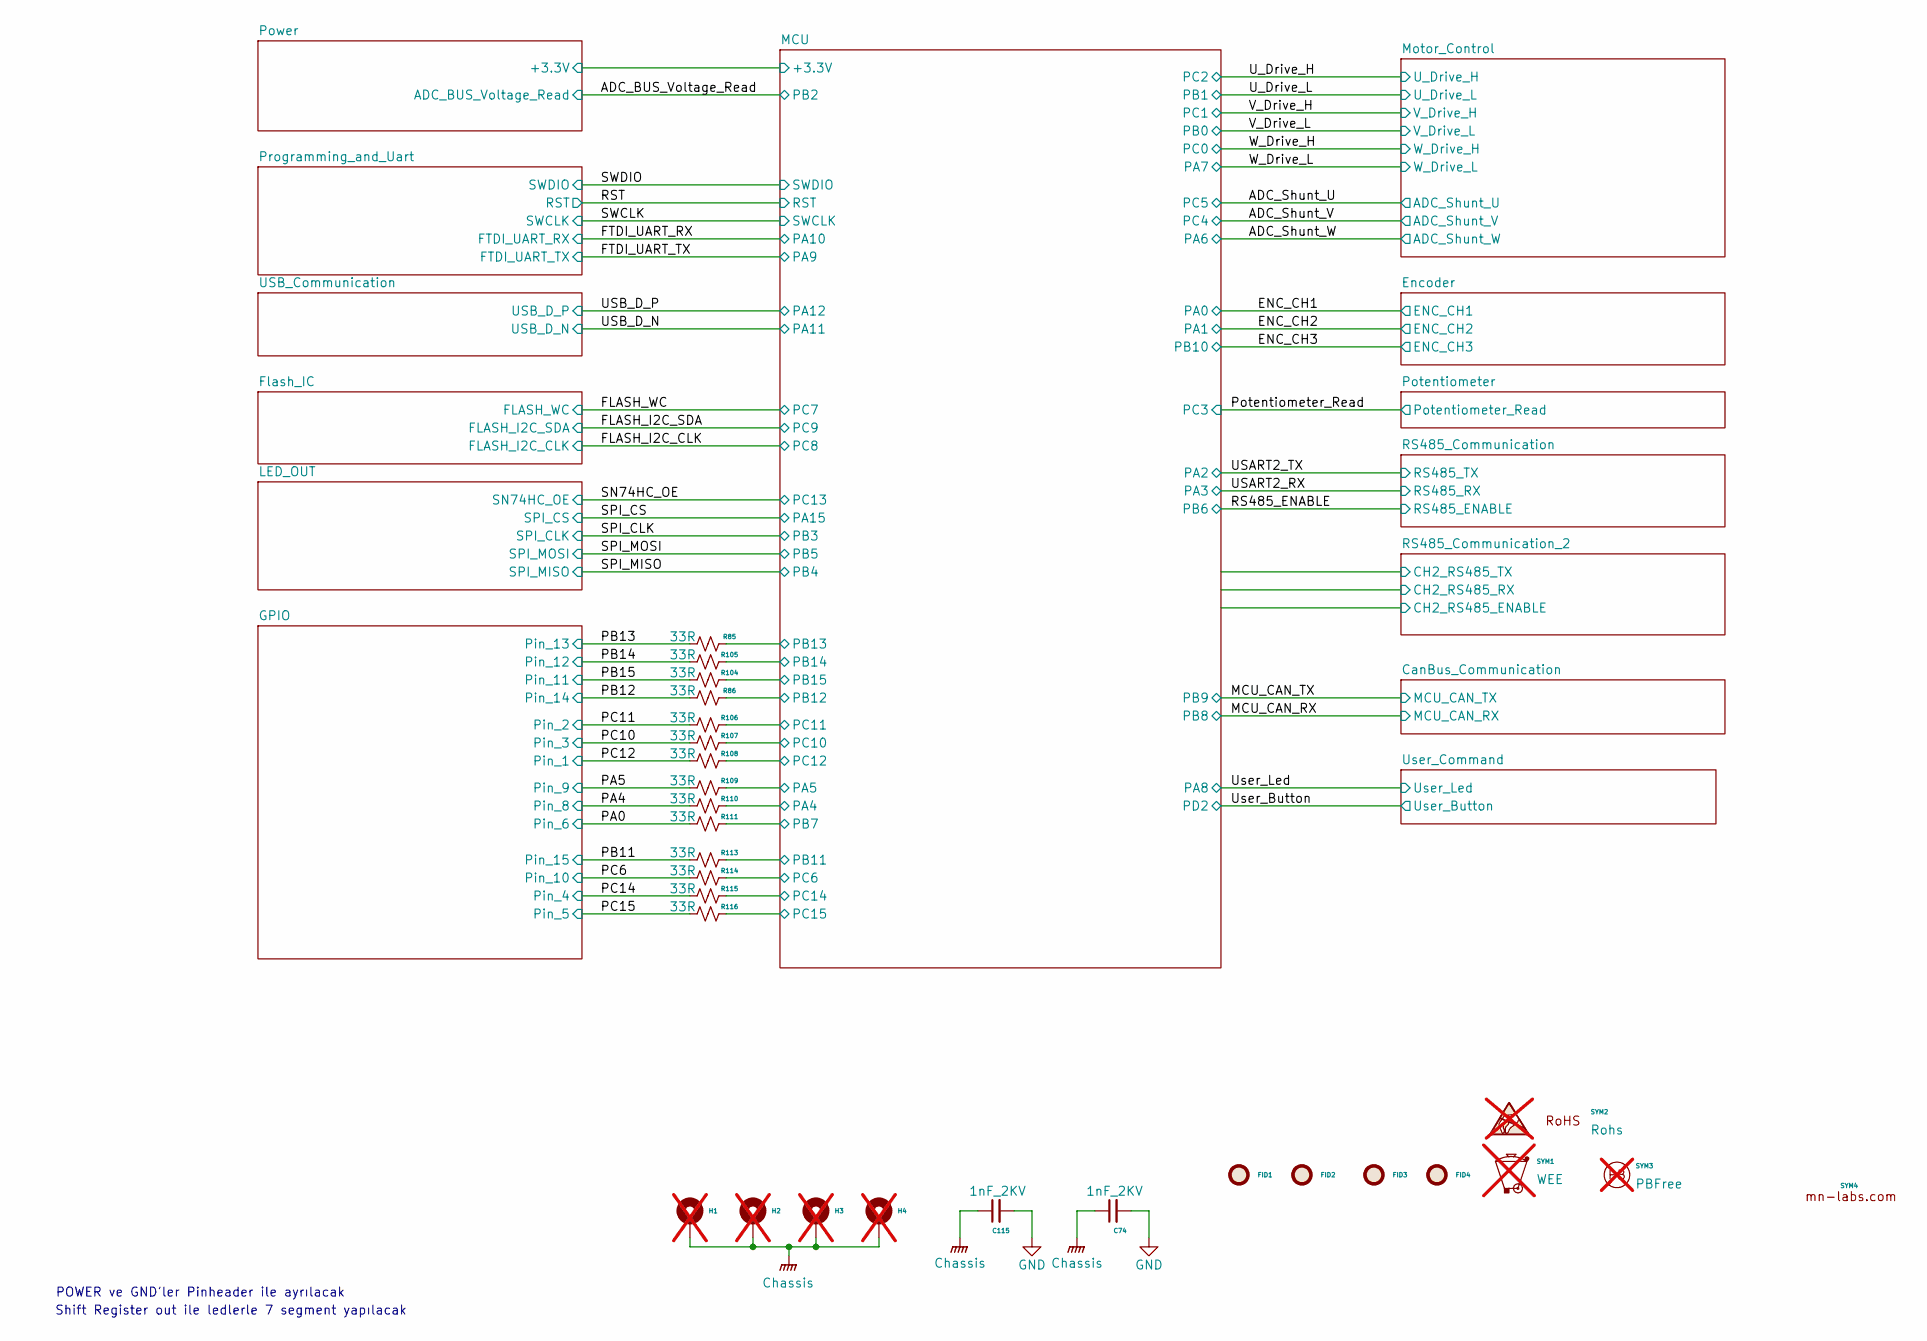
[picture p33: schematic STM32_Motor_Kit_v0.1.kicad_sch]

Parts:
C74, C115: 1nF_2KV; CAP_1206; MFG P/N *
FID1, FID2, FID3, FID4: Fiducial_Point; Fiducial_1mm_Mask2mm
H1, H2, H3, H4: MountingHole_Pad; MountingHole_3.2mm_M3_DIN965_Pad; not fitted
R85, R86, R104, R105, R106, R107, R108, R109, R110, R111, R113, R114, R115, R116: 33R; RES_0603; MFG P/N *
SYM1: WEE; WEEE-Logo_4.2x6mm_SilkScreen; not fitted
SYM2: Rohs; ROHS_LOGO; not fitted
SYM3: PBFree; PBFREE_5x5mm; not fitted
SYM4: MN Lab; not fitted

Connections:
Chassis: C74.1, C115.1, H1.1, H2.1, H3.1, H4.1
GND: C74.2, C115.2
PA0: R111.2
PA4: R110.1, R110.2
PA5: R109.1, R109.2
PB7: R111.1
PB11: R113.1, R113.2
PB12: R86.1, R86.2
PB13: R85.1, R85.2
PB14: R105.1, R105.2
PB15: R104.1, R104.2
PC6: R114.1, R114.2
PC10: R107.1, R107.2
PC11: R106.1, R106.2
PC12: R108.1, R108.2
PC14: R115.1, R115.2
PC15: R116.1, R116.2

Notes on the sheet:
POWER ve GND'ler Pinheader ile ayrılacak
Shift Register out ile ledlerle 7 segment yapılacak
