muzaffernizam/STM32-Motor-Control-BLDC-24V/Hardware/STM32_Motor_Kit_v0.1/USB_Communication.kicad_sch

## KiCad design Hardware/STM32_Motor_Kit_v0.1/USB_Communication.kicad_sch (2026-02-23)

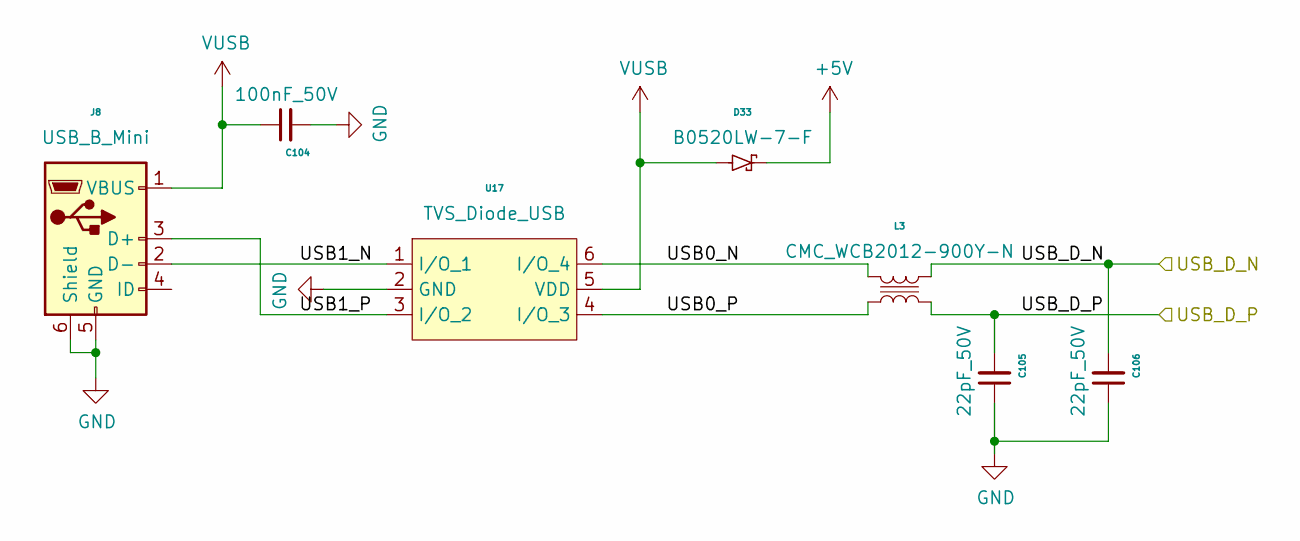
[picture p34: schematic USB_Communication.kicad_sch]

Parts:
C104: 100nF_50V; CAP_0603; MFG P/N *
C105, C106: 22pF_50V; CAP_0603; MFG P/N *
D33: B0520LW-7-F; SOD-123; MFG P/N BAT60JFILM
J8: USB_B_Mini; USB_Mini-B_EDAC_690-005-299-043; MFG P/N L-KLS1-229-5FB-B-R
L3: CMC_WCB2012-900Y-N; CMC_SMD_0805; MFG P/N WCB2012-900Y-N
U17: TVS_Diode_USB; SOT-23-6; MFG P/N PE1805C4A6_R1_00001

Connections:
+5V: D33.1
GND: C104.2, C105.1, C106.1, J8.5 (GND), J8.6 (Shield), U17.2 (GND)
USB0_N: L3.2, U17.6 (I/O_4)
USB0_P: L3.3, U17.4 (I/O_3)
USB1_N: J8.2 (D-), U17.1 (I/O_1)
USB1_P: J8.3 (D+), U17.3 (I/O_2)
USB_D_N: C106.2, L3.1
USB_D_P: C105.2, L3.4
VUSB: C104.1, D33.2, J8.1 (VBUS), U17.5 (VDD)
