muzaffernizam/STM32-Motor-Control-BLDC-24V/Hardware/STM32_Motor_Kit_v0.1/User_Command.kicad_sch

## KiCad design Hardware/STM32_Motor_Kit_v0.1/User_Command.kicad_sch (2026-02-23)

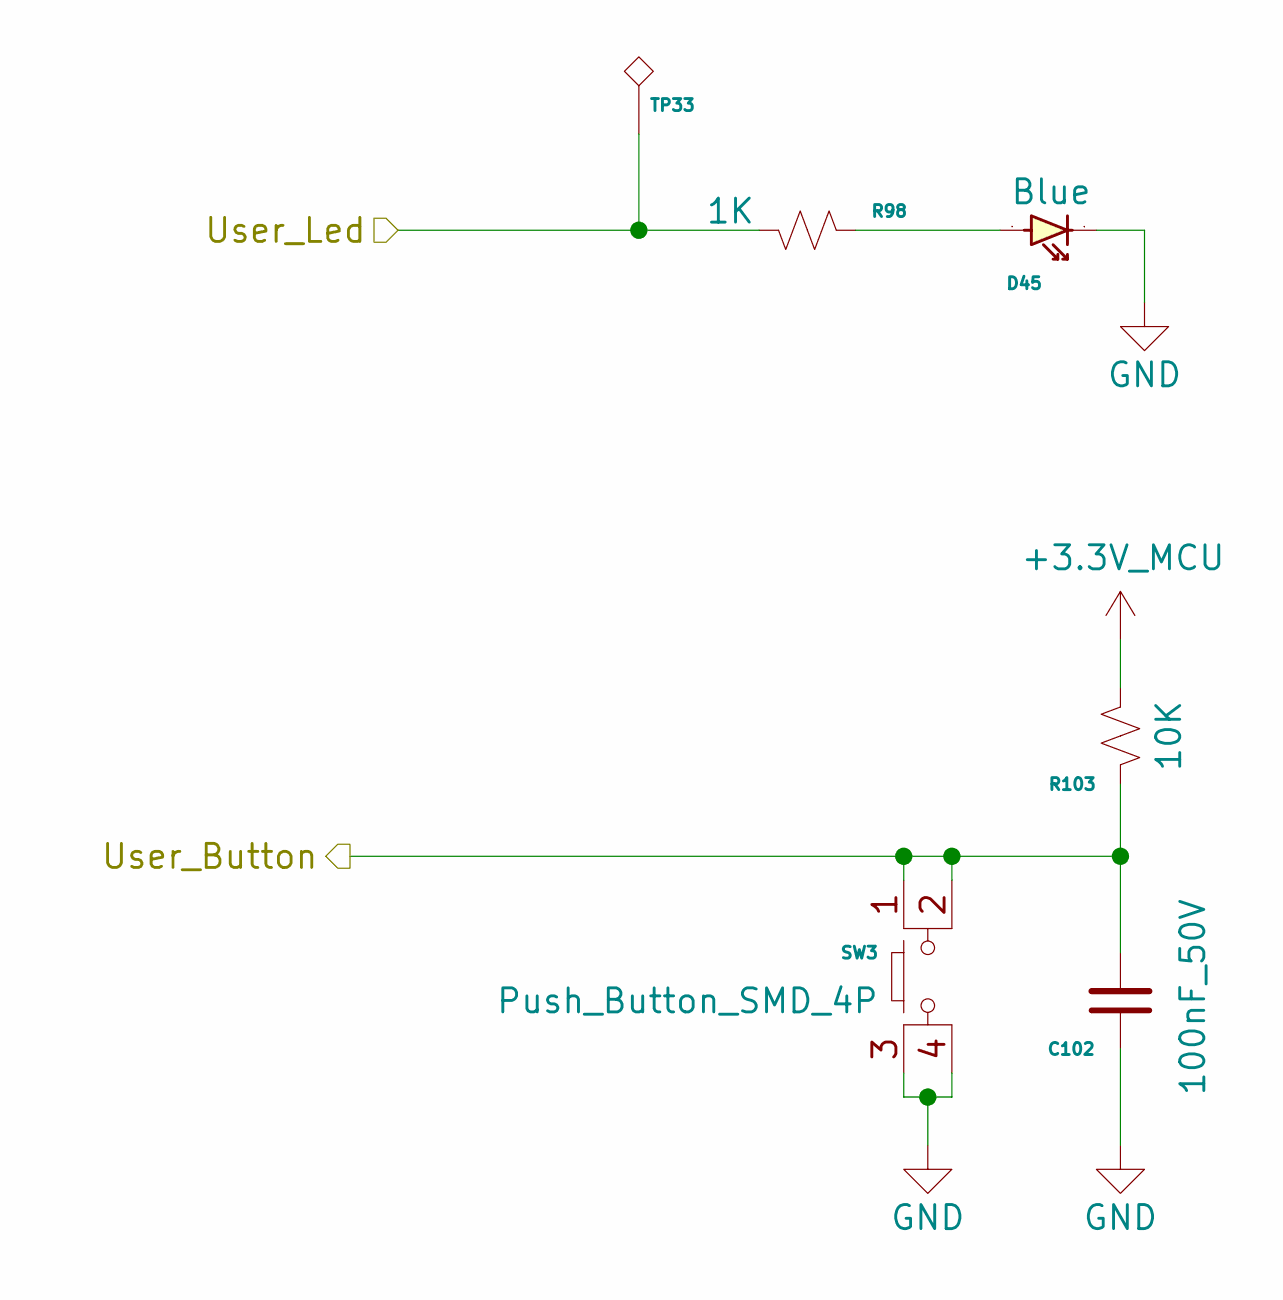
[picture p35: schematic User_Command.kicad_sch]

Parts:
C102: 100nF_50V; CAP_0603; MFG P/N *
D45: Blue; LED_0805; MFG P/N *
R98: 1K; RES_0603; MFG P/N *
R103: 10K; RES_0603; MFG P/N *
SW3: Push_Button_SMD_4P; SW_PTS645SK50SMTR92; MFG P/N PTS645SK50SMTR92 LFS
TP33: Test_Point; TEST_POINT

Connections:
+3.3V_MCU: R103.2
GND: C102.1, D45.1, SW3.3, SW3.4
unnamed: D45.2, R98.2
User_Button: C102.2, R103.1, SW3.1, SW3.2
User_Led: R98.1, TP33.1
