muzaffernizam/STM32-Motor-Control-BLDC-24V/(commit log)

2024-07-18 Back-Up dosyaları silindi
    [STM32_Motor_Kit_v0.1-CuBottom.gbr, STM32_Motor_Kit_v0.1-CuIn1.gbr, STM32_Motor_Kit_v0.1-CuIn2.gbr, STM32_Motor_Kit_v0.1-CuTop.gbr, STM32_Motor_Kit_v0.1-EdgeCuts.gbr, STM32_Motor_Kit_v0.1-MaskBottom.gbr, STM32_Motor_Kit_v0.1-MaskTop.gbr, STM32_Motor_Kit_v0.1-NPTH.drl]
2024-07-18 Added GND polygon to Inner Layer-1
    [Motor_Control.kicad_sch, Potentiometer.kicad_sch, STM32_Motor_Kit_v0.1.kicad_pcb]
2024-07-21 Firmware Configuration added, Motor Control Pins and BackEMF Analog Pins setted.
    [MCU.kicad_sch, Motor_Control.kicad_sch, Power.kicad_sch, STM32_Motor_Kit_v0.1.kicad_pcb, STM32_Motor_Kit_v0.1.kicad_sch]
2024-08-25 26.08.2024
    1nF 2KV chassis ile GND arasına ekledim. PCB'de güncellemeler oldu.
    [STM32_Motor_Kit_v0.1.kicad_pcb, STM32_Motor_Kit_v0.1.kicad_sch]
2024-09-04 Şemada güncellemeler yaptım, PCB'de revizyon yapılacak
    [CanBus_Communication.kicad_sch, Encoder.kicad_sch, Motor_Control.kicad_sch, Potentiometer.kicad_sch, Power.kicad_sch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]
2026-02-23 Şema üzerinde değişiklikler devam ediyor
    [Encoder.kicad_sch, Flash_IC.kicad_sch, GPIO.kicad_sch, LED_OUT.kicad_sch, MCU.kicad_sch, Motor_Control.kicad_sch, Potentiometer.kicad_sch, Power.kicad_sch]
